lab11/triumvi/README.md

# G2
Energy harvesting true power meter

G2 aims to be the first energy harvesting, clamp on true power meter.
