lab11/triumvi/contiki/README.md

G2 - Contiki
==============

This folder contains code to make G2 a
[Contiki](https://github.com/contiki-os/contiki) platform.

Toolchain
------------

1. Install the compilers. See
[this](https://github.com/contiki-os/contiki/tree/master/platform/cc2538dk#install-a-toolchain)
for a link to the best compiler to use for the CC2538

Main Application
----------------

Currently, `triumvi_current` is the primary application. This application supports
versions 10, 11, 12, 12.1.
