lab11/triumvi/hardware/v9/mcu/Altium/layout/triumvi_v9_mcu.PcbDoc.htm

Reporting Options

# File in Previous Format

Date | : | 4/25/2016
Time | : | 2:15:08 PM
Filename | : | \\psf\Dropbox\Altium_YeSheng\Triumvi_v9_mcu\layout\triumvi_v9_mcu.PcbDoc

Version | Warning

This file was generated by an earlier version of the software
