lab11/triumvi/hardware/v9/sensing/Altium/layout/triumvi_v9_sensing.PcbDoc.htm

Reporting Options

# File in Previous Format

Date | : | 4/26/2016
Time | : | 10:14:43 AM
Filename | : | \\psf\Dropbox\Altium_YeSheng\Triumvi_v9_sensing\layout\triumvi_v9_sensing.PcbDoc

Version | Warning

This file was generated by an earlier version of the software
