lab11/triumvi/case/labels/bottom/BlockM-no-rball.png

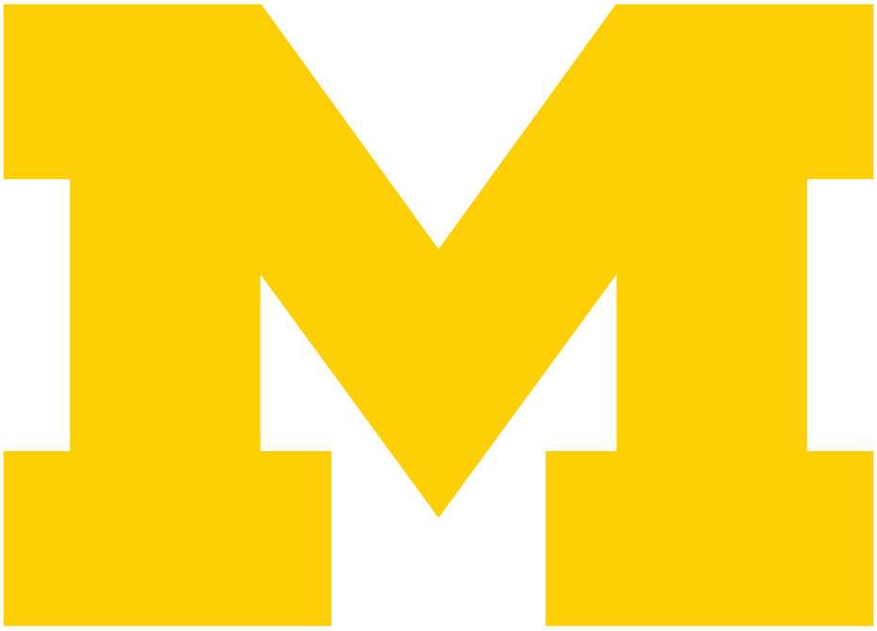
case/labels/bottom/BlockM-no-rball.png
