lab11/triumvi/hardware/charger/bom/Bill of Materials-triumvi_v10_phoneJeck_charging.xlsx

Designator | Value | Footprint | Quantity | Description | Supplier Part Number 1
C1_CHG1, C1_CHG2, C1_CHG3, C1_CHG4, C1_CHG5, C1_CHG6, C1_CHG7, C1_CHG8, C1_CHG9, C1_CHG10, C2_CHG1, C2_CHG2, C2_CHG3, C2_CHG4, C2_CHG5, C2_CHG6, C2_CHG7, C2_CHG8, C2_CHG9, C2_CHG10 | 4.7u | 0805 | 20 | Ceramic capacitor, 4.7 uF, 25 V, 0805 package | 490-3335-1-ND (https://octopart-clicks.com/click/altium?sku=490-3335-1-ND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)
C3 | 10u | 0603 - Polar Marking | 1 | Tantalum capacitor, 10 uF, 10 V, 0603 package | 511-1679-1-ND (https://octopart-clicks.com/click/altium?sku=511-1679-1-ND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)
C4 | 100u | 2917 | 1 | Tantalum capacitor, 100u, 2917 package | 399-3769-1-ND (https://octopart-clicks.com/click/altium?sku=399-3769-1-ND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)
C5 | 10u | 0603 | 1 | Ceramic capacitor, 10 uF, 16 V, 0603 package | 445-9065-1-ND (https://octopart-clicks.com/click/altium?manufacturer=TDK%20Corporation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)
C6 | 1u | 0603 | 1 | Ceramic capacitor, 1 uF, 16 V, 0603 package | 445-1604-1-ND (https://octopart-clicks.com/click/altium?manufacturer=TDK%20Corporation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)
D1_CHG1, D1_CHG2, D1_CHG3, D1_CHG4, D1_CHG5, D1_CHG6, D1_CHG7, D1_CHG8, D1_CHG9, D1_CHG10 |  | 0603 - LED | 10 | LED, Green, 0603 | 160-1446-1-ND (https://octopart-clicks.com/click/altium?sku=160-1446-1-ND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)
D2 |  | 0603 - LED | 1 | LED, Blue, 0603 | 475-2815-1-ND (https://octopart-clicks.com/click/altium?manufacturer=OSRAM%20Opto%20Semiconductors%20Inc.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)
FB1 |  | 0603 | 1 | Ferrite Bead, 2 A, 0603 package | 553-2387-1-ND (https://octopart-clicks.com/click/altium?manufacturer=Pulse%20Electronics%20Corporation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)
J1 |  | PJ-102AH | 1 | CONN PWR JACK 2.1X5.5MM HIGH CUR | CP-102AH-ND (https://octopart-clicks.com/click/altium?sku=CP-102AH-ND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)
P1_CHG1, P1_CHG2, P1_CHG3, P1_CHG4, P1_CHG5, P1_CHG6, P1_CHG7, P1_CHG8, P1_CHG9, P1_CHG10 |  | PJ3516S-041 | 10 | 3.5 mm phone jack, 4 terminals
R1_CHG1, R1_CHG2, R1_CHG3, R1_CHG4, R1_CHG5, R1_CHG6, R1_CHG7, R1_CHG8, R1_CHG9, R1_CHG10 | 10K | 0603 | 10 | Chip resistor, 10K, 0603 package | 541-10.0KHCT-ND (https://octopart-clicks.com/click/altium?sku=541-10.0KHCT-ND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)
R2_CHG1, R2_CHG2, R2_CHG3, R2_CHG4, R2_CHG5, R2_CHG6, R2_CHG7, R2_CHG8, R2_CHG9, R2_CHG10 | 47K | 0603 | 10 | Chip resistor, 47K, 0603 package | 541-47.0KHCT-ND (https://octopart-clicks.com/click/altium?sku=541-47.0KHCT-ND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)
R3_CHG1, R3_CHG2, R3_CHG3, R3_CHG4, R3_CHG5, R3_CHG6, R3_CHG7, R3_CHG8, R3_CHG9, R3_CHG10, R4 | 330 | 0603 | 11 | Chip resistor, 330, 0603 package | 541-330HCT-ND (https://octopart-clicks.com/click/altium?sku=541-330HCT-ND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)
U1_CHG1, U1_CHG2, U1_CHG3, U1_CHG4, U1_CHG5, U1_CHG6, U1_CHG7, U1_CHG8, U1_CHG9, U1_CHG10 |  | TSOT23-5 | 10 | Miniature Single-Cell, Fully Integrated Li-Ion, Li-Polymer Charge Management Controllers | MCP73831T-2ATI/OTCT-ND (https://octopart-clicks.com/click/altium?manufacturer=Microchip%20Technology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)
