lab11/triumvi/hardware/v12.1/config/bom/Bill of Materials-triumvi_integrated_v2_config.xlsx

Designator | Value | Footprint | Quantity | Description | Supplier Part Number 1
C1 | 0.1u | 0402 | 1 | 0.10µF ±10% 16V Ceramic Capacitor X7R 0402 | 490-3261-1-ND (https://octopart-clicks.com/click/altium?sku=490-3261-1-ND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)
D1 | RGB | PLCC6 | 1 | Red, Green, Blue (RGB) 622nm Red, 530nm Green, 470nm Blue LED Indication - Discrete 2.1V Red, 3V Green, 3V Blue 6-SMD, J-Lead | CLY6D-FKC-CK1N1D1BB7D3D3CT-ND (https://octopart-clicks.com/click/altium?manufacturer=Cree%20Inc.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)
J1 |  | DF40C-12DP-0.4V | 1 | Hirose BM20 Series, 0.4mm pitch, 12 pos, header | H124599CT-ND (https://octopart-clicks.com/click/altium?manufacturer=Hirose%20Electric%20Co%20Ltd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)
P1 |  | PJ3516S-041 | 1 | 3.5 mm phone jack, 4 terminals
P2, P3 |  | PJ2505S-041 | 2 | 2.5 mm phone jack, 4 terminals
R1, R7 | 100k | 0402 | 2 | RES SMD 100K OHM 1% 1/16W 0402 | 541-100KLCT-ND (https://octopart-clicks.com/click/altium?sku=541-100KLCT-ND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)
R2 | 110 | 0402 | 1 | RES SMD 110 OHM 1% 1/16W 0402 | 541-110LCT-ND (https://octopart-clicks.com/click/altium?sku=541-110LCT-ND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)
R3 | 220 | 0402 | 1 | RES SMD 220 OHM 1% 1/16W 0402 | 541-220LCT-ND (https://octopart-clicks.com/click/altium?sku=541-220LCT-ND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)
R4 | 324 | 0402 | 1 | RES SMD 324 OHM 1% 1/16W 0402 | 541-324LCT-ND (https://octopart-clicks.com/click/altium?sku=541-324LCT-ND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)
R5, R6 | 10k | 0402 | 2 | RES SMD 10K OHM 1% 1/16W 0402 | 541-10.0KLCT-ND (https://octopart-clicks.com/click/altium?sku=541-10.0KLCT-ND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)
SW1 |  | SH-7050A | 1 | ROTARY CODED SWITCHES | 563-1213-1-ND (https://octopart-clicks.com/click/altium?sku=563-1213-1-ND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)
SW2, SW3 |  | SH-7010A | 2 | ROTARY CODED SWITCHES | 563-1207-1-ND (https://octopart-clicks.com/click/altium?sku=563-1207-1-ND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)
U1 |  | QFN40P400X400X60_HS-29N | 1 | Voltage Level Shifting GPIO with LED Driver and Keypad Engine | SX1509BIULCT-ND (https://octopart-clicks.com/click/altium?manufacturer=Semtech%20Corporation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)
