lab11/triumvi/hardware/v12.1/sensing_mcu/bom/Bill of Materials-triumvi_integrated_v2_base.xlsx

Designator | Value | Footprint | Quantity | Description | Supplier Part Number 1
ANT1 |  | 2450AT45A100 | 1 | 2.45 GHz High Gain SMD Chip Antenna | 712-1012-1-ND (https://octopart-clicks.com/click/altium?manufacturer=Johanson%20Technology%20Inc.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)
B1 |  | 2450BM15A0002 | 1 | 2.45 GHz Balun for TI CC253X | 712-1536-1-ND (https://octopart-clicks.com/click/altium?manufacturer=Johanson%20Technology%20Inc.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)
C1, C2, C3, C14 | 1u | 0603 | 4 | 1µF ±10% 16V Ceramic Capacitor X7R 0603 | 445-1604-1-ND (https://octopart-clicks.com/click/altium?manufacturer=TDK%20Corporation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)
C4, C5, C15, C41, C42, C43, C44, C46, C47 | 4.7u | 0603 | 9 | 4.7µF ±10% 10V Ceramic Capacitor X5R 0603 | 445-7482-1-ND (https://octopart-clicks.com/click/altium?manufacturer=TDK%20Corporation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)
C6 | 0.068u | 0603 | 1 | 0.068µF ±10% 50V Ceramic Capacitor X7R 0603 | 399-7955-1-ND (https://octopart-clicks.com/click/altium?sku=399-7955-1-ND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)
C7 | 10000p | 0603 | 1 | 10000pF ±5% 50V Ceramic Capacitor X7R 0603 | 399-1092-6-ND (https://octopart-clicks.com/click/altium?sku=399-1092-6-ND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)
C8, C9, C10, C11, C12 | 220u | 2917 | 5 | 220µF ±10% Molded Tantalum Capacitors 16V | 399-10409-1-ND (https://octopart-clicks.com/click/altium?sku=399-10409-1-ND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)
C13 | 100u | 1206 - POLAR MARKING | 1 | 100µF ±20% Molded Tantalum Capacitors 6.3V 1206 | 478-8155-1-ND (https://octopart-clicks.com/click/altium?sku=478-8155-1-ND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)
C16, C17, C19, C21, C23, C24, C27, C28, C29, C30, C31, C32, C33, C35, C38, C39 | 0.1u | 0402 | 16 | 0.10µF ±10% 16V Ceramic Capacitor X7R 0402 | 490-3261-1-ND (https://octopart-clicks.com/click/altium?sku=490-3261-1-ND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)
C18 | 80m | XH414HG-IV01E | 1 | 80mF (EDLC) Supercapacitor 3.3V Coin | 728-1050-1-ND (https://octopart-clicks.com/click/altium?sku=728-1050-1-ND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)
C20, C25, C26, C45 | 10u | 0603 | 4 | 10µF ±20% 6.3V Ceramic Capacitor X5R 0603 | 445-4112-1-ND (https://octopart-clicks.com/click/altium?manufacturer=TDK%20Corporation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)
C22 | 18p | 0402 | 1 | 18pF ±2% 50V Ceramic Capacitor C0G, NP0 0402 | 712-1264-1-ND (https://octopart-clicks.com/click/altium?manufacturer=Johanson%20Technology%20Inc.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)
C34 | 220p | 0402 | 1 | 220pF ±10% 50V Ceramic Capacitor X7R 0402 | 399-1030-1-ND (https://octopart-clicks.com/click/altium?sku=399-1030-1-ND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)
C36, C37 | 12p | 0402 | 2 | 12pF ±2% 50V Ceramic Capacitor C0G, NP0 0402 | 712-1256-1-ND (https://octopart-clicks.com/click/altium?manufacturer=Johanson%20Technology%20Inc.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)
C40 | 1000p | 0402 | 1 | 1000pF ±5% 50V Ceramic Capacitor C0G, NP0 0402 | 445-6846-1-ND (https://octopart-clicks.com/click/altium?manufacturer=TDK%20Corporation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)
D1, D3 |  | PowerDI123 | 2 | 1.0A SURFACE MOUNT SCHOTTKY BARRIER RECTIFIER | DFLS130LDICT-ND (https://octopart-clicks.com/click/altium?sku=DFLS130LDICT-ND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)
D2 | Green | 0402 - LED | 1 | Green 571nm LED Indication - Discrete 2V 0402 (1005 Metric) | 754-1811-1-ND (https://octopart-clicks.com/click/altium?sku=754-1811-1-ND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)
D4, D5, D6, D7 |  | SOT23-3 | 4 | SURFACE MOUNT SCHOTTKY BARRIER DIODE | BAS40-04FDICT-ND (https://octopart-clicks.com/click/altium?manufacturer=Diodes%20Incorporated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)
D8 |  | SOT-363 | 1 | SURFACE MOUNT SCHOTTKY BARRIER DIODE ARRAYS | BAS40TW-FDICT-ND (https://octopart-clicks.com/click/altium?sku=BAS40TW-FDICT-ND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)
D9 |  | 0503/SOD-723F | 1 | Zener Diode 3.6V 150mW ±5% Surface Mount 0503 (1308 Metric) | 641-1232-1-ND (https://octopart-clicks.com/click/altium?sku=641-1232-1-ND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)
D10 | Red | 0402 - LED | 1 | Red 620nm LED Indication - Discrete 2V 2-SMD | 511-1593-1-ND (https://octopart-clicks.com/click/altium?sku=511-1593-1-ND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)
D11 |  | 0402 - DIODE | 1 | Diode Schottky 30V 100mA Surface Mount 0402/SOD-923F | 641-1271-1-ND (https://octopart-clicks.com/click/altium?sku=641-1271-1-ND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)
D12 |  | SOT323 | 1 | Diode Array 1 Pair Common Cathode Standard 75V 150mA Surface Mount SC-70, SOT-323 | BAV70W-FDICT-ND (https://octopart-clicks.com/click/altium?sku=BAV70W-FDICT-ND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)
J1 |  | DF40B(2.0)-12DS-0.4V | 1 | Hirose BM20 Series, 0.4mm pitch, 2mm stack height, 12 pos, header | H124594CT-ND (https://octopart-clicks.com/click/altium?manufacturer=Hirose%20Electric%20Co%20Ltd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)
J2, J3 |  | 9774020243R | 2 | 2 mm stack height, m2 standoff | 732-7073-1-ND (https://octopart-clicks.com/click/altium?manufacturer=Wurth%20Electronics%20Inc.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)
L1 | 10u | CDRH2D18 | 1 | 10µH Shielded Inductor 1A 180 mOhm Max Nonstandard | 308-1959-1-ND (https://octopart-clicks.com/click/altium?manufacturer=Sumida%20America%20Components%20Inc.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)
P1, P2 |  | TC2030-IDC-NLFP | 2 | TC2030-MCP-NL
Q1 |  | SOT23-3 | 1 | P-Channel 30-V (D-S) MOSFET | SI2369DS-T1-GE3CT-ND (https://octopart-clicks.com/click/altium?manufacturer=Vishay%20Siliconix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)
Q2, Q4 |  | SOT23-3 | 2 | P-Channel 20 V (D-S) MOSFET | SI2367DS-T1-GE3CT-ND (https://octopart-clicks.com/click/altium?manufacturer=Vishay%20Siliconix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)
Q3, Q5 |  | SOT23-3 | 2 | N-Channel 8 V (D-S) MOSFET | SI2342DS-T1-GE3CT-ND (https://octopart-clicks.com/click/altium?manufacturer=Vishay%20Siliconix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)
Q6, Q7, Q8, Q9 |  | SOT23-3 | 4 | N-Channel 30 V (D-S) MOSFET | SI2338DS-T1-GE3CT-ND (https://octopart-clicks.com/click/altium?manufacturer=Vishay%20Siliconix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)
Q10, Q11 |  | SC70-6 | 2 | DUAL N-CHANNEL ENHANCEMENT MODE MOSFET | DMN2004DWKDICT-ND (https://octopart-clicks.com/click/altium?manufacturer=Diodes%20Incorporated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)
Q12 |  | SC70-6 | 1 | Dual P-Channel 12 V (D-S) MOSFET | SI1965DH-T1-GE3CT-ND (https://octopart-clicks.com/click/altium?manufacturer=Vishay%20Siliconix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)
Q13, Q14, Q15 |  | SC70-6 | 3 | Load Switch with Level-Shift | SI1865DDL-T1-GE3CT-ND (https://octopart-clicks.com/click/altium?manufacturer=Vishay%20Siliconix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)
R1 | 910 | 0402 | 1 | RES SMD 910 OHM 1% 1/16W 0402 | 541-910LCT-ND (https://octopart-clicks.com/click/altium?sku=541-910LCT-ND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)
R2, R3, R5, R6, R26, R28 | 47k | 0402 | 6 | RES SMD 47K OHM 1% 1/16W 0402 | 541-47.0KLCT-ND (https://octopart-clicks.com/click/altium?sku=541-47.0KLCT-ND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)
R4, R7, R8, R22, R24, R29, R30, R32, R33, R37, R38, R39, R40, R41, R42 | 1Meg | 0402 | 15 | RES SMD 1M OHM 1% 1/16W 0402 | 541-1.00MLCT-ND (https://octopart-clicks.com/click/altium?sku=541-1.00MLCT-ND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)
R9 | 20 | 0805 | 1 | RES SMD 20 OHM 0.1% 1/5W 0805 | RTAN0805BKE20R0CT-ND (https://octopart-clicks.com/click/altium?manufacturer=Stackpole%20Electronics%20Inc.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)
R10, R11 | 10k | 0402 | 2 | RES SMD 10K OHM 1% 1/16W 0402 | 541-10.0KLCT-ND (https://octopart-clicks.com/click/altium?sku=541-10.0KLCT-ND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)
R12 | 4.32k | 0402 | 1 | RES SMD 4.32K OHM 1% 1/16W 0402 | 541-4.32KLCT-ND (https://octopart-clicks.com/click/altium?sku=541-4.32KLCT-ND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)
R13 | 45.3k | 0402 | 1 | RES SMD 45.3KOHM 0.5% 1/16W 0402 | YAG4430CT-ND (https://octopart-clicks.com/click/altium?sku=YAG4430CT-ND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)
R14 | 620 | 0402 | 1 | RES SMD 620 OHM 1% 1/16W 0402 | 541-620LCT-ND (https://octopart-clicks.com/click/altium?sku=541-620LCT-ND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)
R15 | 24k | 0402 | 1 | RES SMD 24K OHM 0.5% 1/16W 0402 | 311-2260-1-ND (https://octopart-clicks.com/click/altium?sku=311-2260-1-ND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)
R16 | 20 | 0402 | 1 | RES SMD 20 OHM 1% 1/16W 0402 | 541-20.0LCT-ND (https://octopart-clicks.com/click/altium?sku=541-20.0LCT-ND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)
R17 | 12.1k | 0402 | 1 | RES SMD 12.1K OHM 1% 1/16W 0402 | 541-12.1KLCT-ND (https://octopart-clicks.com/click/altium?sku=541-12.1KLCT-ND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)
R18 | 110 | 0402 | 1 | RES SMD 110 OHM 1% 1/16W 0402 | 541-110LCT-ND (https://octopart-clicks.com/click/altium?sku=541-110LCT-ND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)
R19 | 5.76k | 0402 | 1 | RES SMD 5.76K OHM 0.5% 1/16W 0402 | YAG3196CT-ND (https://octopart-clicks.com/click/altium?sku=YAG3196CT-ND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)
R20, R23, R25 | 100k | 0402 | 3 | RES SMD 100K OHM 1% 1/16W 0402 | 541-100KLCT-ND (https://octopart-clicks.com/click/altium?sku=541-100KLCT-ND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)
R21 | 2Meg | 0402 | 1 | RES SMD 2M OHM 1% 1/16W 0402 | 541-2.00MLCT-ND (https://octopart-clicks.com/click/altium?sku=541-2.00MLCT-ND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)
R27 | 100 | 0402 | 1 | RES SMD 100 OHM 1% 1/16W 0402 | 541-100LCT-ND (https://octopart-clicks.com/click/altium?sku=541-100LCT-ND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)
R31, R34 | 2.2k | 0402 | 2 | RES SMD 2.2K OHM 1% 1/16W 0402 | 541-2.20KLCT-ND (https://octopart-clicks.com/click/altium?sku=541-2.20KLCT-ND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)
R35 | 56k | 0402 | 1 | RES SMD 56K OHM 1% 1/16W 0402 | 541-56.0KLCT-ND (https://octopart-clicks.com/click/altium?sku=541-56.0KLCT-ND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)
R36 | 470k | 0402 | 1 | RES SMD 470K OHM 5% 1/16W 0402 | 541-470KJCT-ND (https://octopart-clicks.com/click/altium?sku=541-470KJCT-ND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)
SW1 |  | EVQP7C | 1 | 3.5 mm×2.9 mm Side-operational SMD Light Touch Switches | P16769CT-ND (https://octopart-clicks.com/click/altium?manufacturer=Panasonic%20Electronic%20Components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)
U1 |  | SOT23-6 | 1 | Low Noise, Regulated Charge Pump DC/DC Converters | LTC3200ES6-5#TRMPBFCT-ND (https://octopart-clicks.com/click/altium?manufacturer=Linear%20Technology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)
U2 |  | TSOT23-5 | 1 | Miniature Single-Cell, Fully Integrated Li-Ion, Li-Polymer Charge Management Controllers | MCP73831T-2ATI/OTCT-ND (https://octopart-clicks.com/click/altium?manufacturer=Microchip%20Technology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)
U3 |  | QFN-10 | 1 | Piezoelectric Energy Harvesting Power Supply | LTC3588EDD-1#PBF-ND (https://octopart-clicks.com/click/altium?manufacturer=Linear%20Technology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)
U4 |  | TDFN-8 | 1 | 256-Kbit (32 K × 8) Serial (SPI) F-RAM | FM25V02A-DGTR-ND (https://octopart-clicks.com/click/altium?manufacturer=Cypress%20Semiconductor%20Corp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)
U5 |  | TSSOP-14 | 1 | 1 pC Charge Injection, 100 pA Leakage CMOS 5 V/5 V/3 V 4-Channel Multiplexer | ADG604YRUZ-ND (https://octopart-clicks.com/click/altium?sku=ADG604YRUZ-ND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)
U6 |  | MSOP-8 | 1 | Micro-Power (50uA), Zero-Drift, Rail-to-Rail Out Instrumentation Amplifier | 296-23564-1-ND (https://octopart-clicks.com/click/altium?sku=296-23564-1-ND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)
U7 |  | MSOP-8 | 1 | 0.9 µA, High Precision Op Amps | MCP6032-E/MS-ND (https://octopart-clicks.com/click/altium?manufacturer=Microchip%20Technology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)
U8 |  | SC70-5 | 1 | Rail-to-rail 0.9 V nanopower comparator | 497-13217-1-ND (https://octopart-clicks.com/click/altium?sku=497-13217-1-ND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)
U9 |  | QFN56 | 1 | A Powerful System-On-Chip for 2.4-GHz IEEE 802.15.4, 6LoWPAN and ZigBee Applications | 296-35797-1-ND (https://octopart-clicks.com/click/altium?sku=296-35797-1-ND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)
U10, U12 |  | CP-6-3 | 2 | Ultralow Noise, 200 mA, CMOS Linear Regulator | ADP151ACPZ-3.0-R7CT-ND (https://octopart-clicks.com/click/altium?manufacturer=Analog%20Devices%20Inc.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)
U11 |  | TSOT-23 | 1 | Low Loss PowerPath Controller in ThinSOT | LTC4412ES6#TRMPBFCT-ND (https://octopart-clicks.com/click/altium?manufacturer=Linear%20Technology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)
Y1 |  | RV-3049-C3 | 1 | Real Time Clock Module with SPI-Bus
Y2 |  | FA-128 | 1 | MHz Range Crystal Unit | SER3800CT-ND (https://octopart-clicks.com/click/altium?sku=SER3800CT-ND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)
