lab11/triumvi/case/triumvi_v10.1_charge_holder.SLDASM

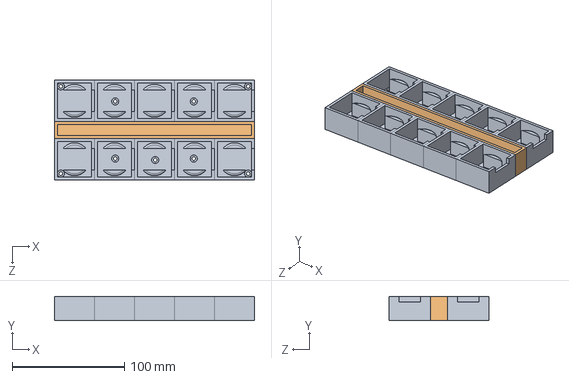
[picture p2: CAD file, 2017-02-23]
case/triumvi_v10.1_charge_holder.SLDASM
177.8 x 21.3 x 88.9 mm
triumvi_v10_charge_holder_pod x 10
triumvi_v10_charge_holder_middle
