lab11/triumvi/case/triumvi_v10_charge_holder_middle.SLDPRT

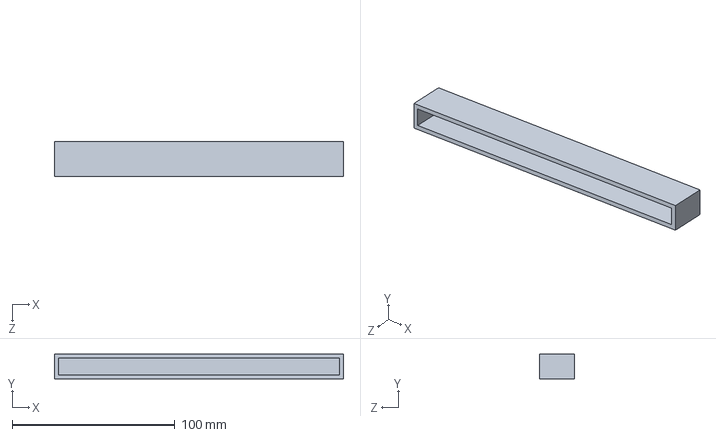
[picture p3: CAD file, 2017-02-23]
case/triumvi_v10_charge_holder_middle.SLDPRT
177.8 x 15.2 x 21.3 mm
