lab11/triumvi/case/triumvi_v10_cap.SLDPRT

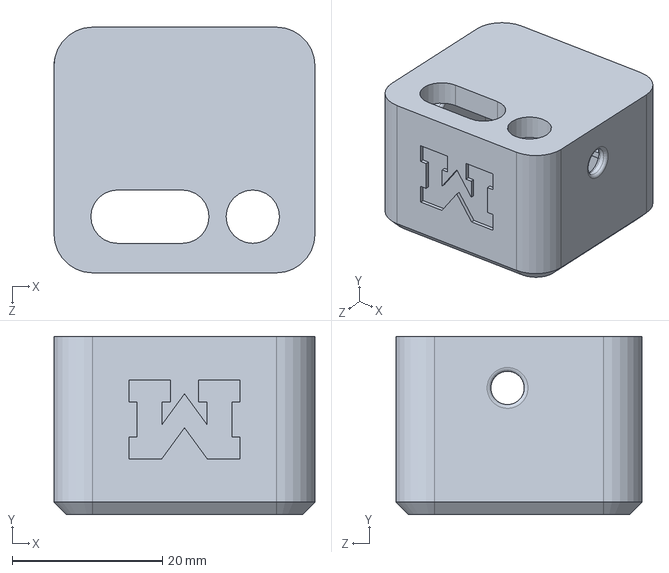
[picture p4: CAD file, 2017-02-23]
case/triumvi_v10_cap.SLDPRT
34.8 x 23.7 x 32.8 mm
