lab11/triumvi/case/triumvi_v10_charge_holder_pod.SLDPRT

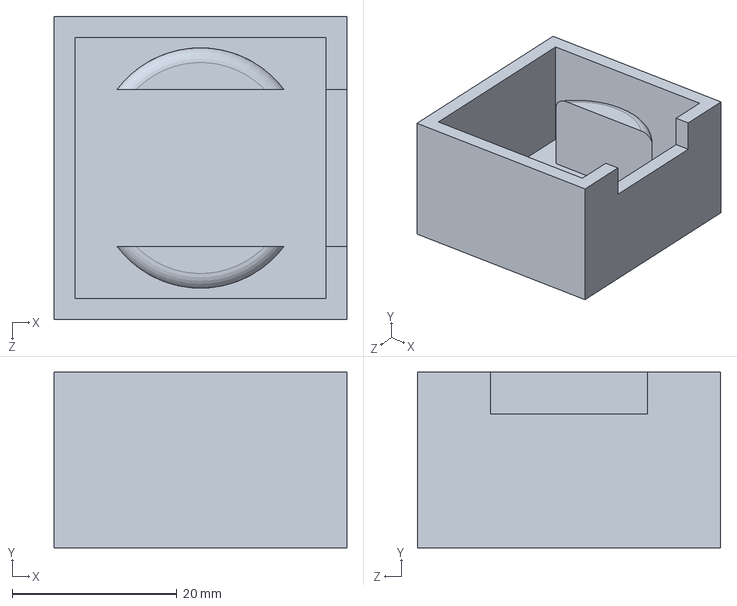
[picture p5: CAD file, 2017-02-23]
case/triumvi_v10_charge_holder_pod.SLDPRT
35.6 x 21.3 x 36.8 mm
