lab11/triumvi/case/triumvi_white_charge_holder.SLDPRT

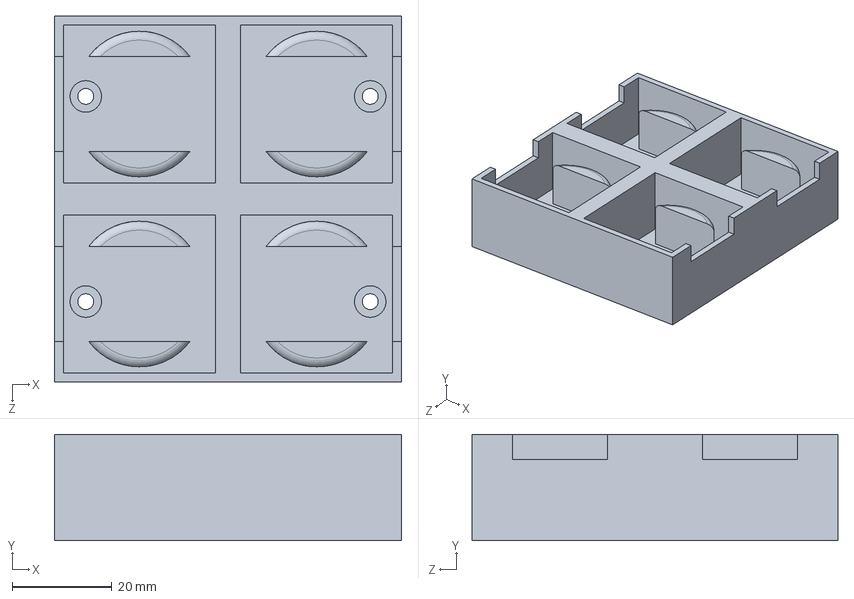
[picture p6: CAD file, 2016-12-15]
case/triumvi_white_charge_holder.SLDPRT
69.6 x 21.3 x 73.4 mm
