lab11/triumvi/case/bottom_cap_case.SLDPRT

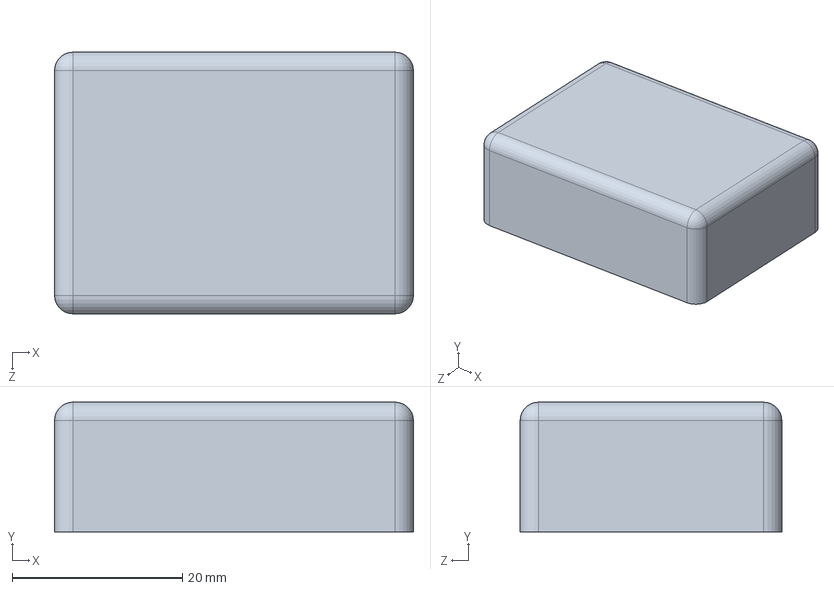
[picture p7: CAD file, 2016-12-15]
case/bottom_cap_case.SLDPRT
42.2 x 15.2 x 30.7 mm
