lab11/triumvi/case/triumvi_white_charge_holder_test.SLDPRT

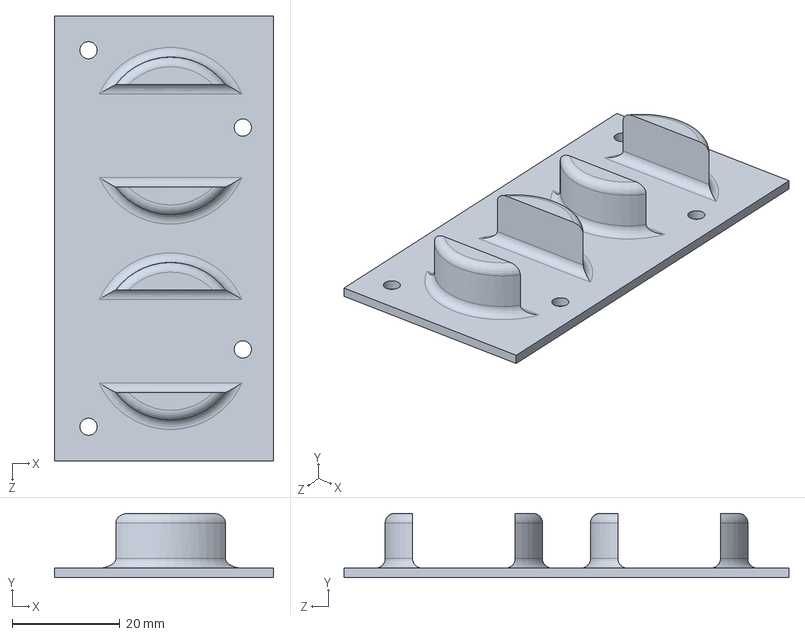
[picture p8: CAD file, 2016-12-15]
case/triumvi_white_charge_holder_test.SLDPRT
40.7 x 11.9 x 82.6 mm
