lab11/triumvi/case/triumvi_v10_charge_holder.SLDASM

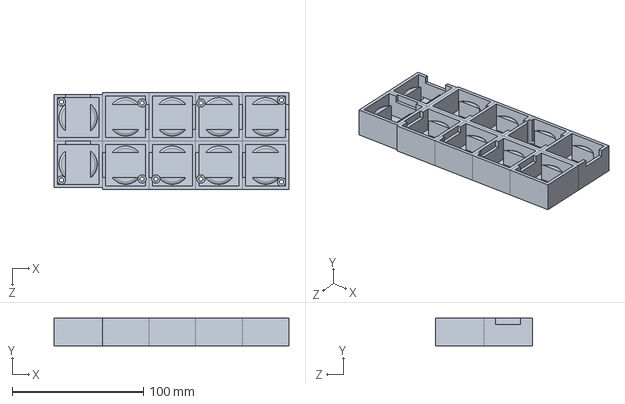
[picture p9: CAD file, 2016-12-15, an earlier design]
case/triumvi_v10_charge_holder.SLDASM
179.1 x 21.3 x 73.7 mm
triumvi_v10_charge_holder_pod x 10
