lab11/triumvi/case/triumvi_v9_cap.SLDPRT

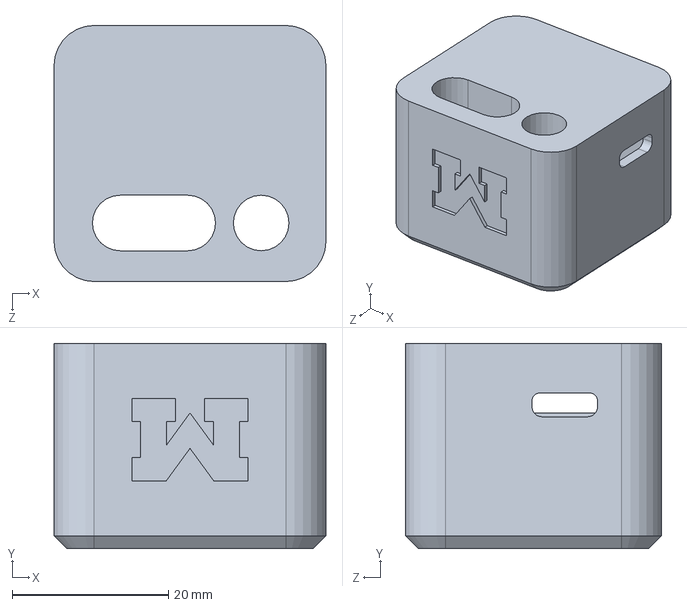
[picture p10: CAD file, 2016-12-15, an earlier design]
case/triumvi_v9_cap.SLDPRT
34.8 x 26.3 x 32.8 mm
