lab11/triumvi/hardware/v12.1/sensing_mcu/schematic/schematic.PDF

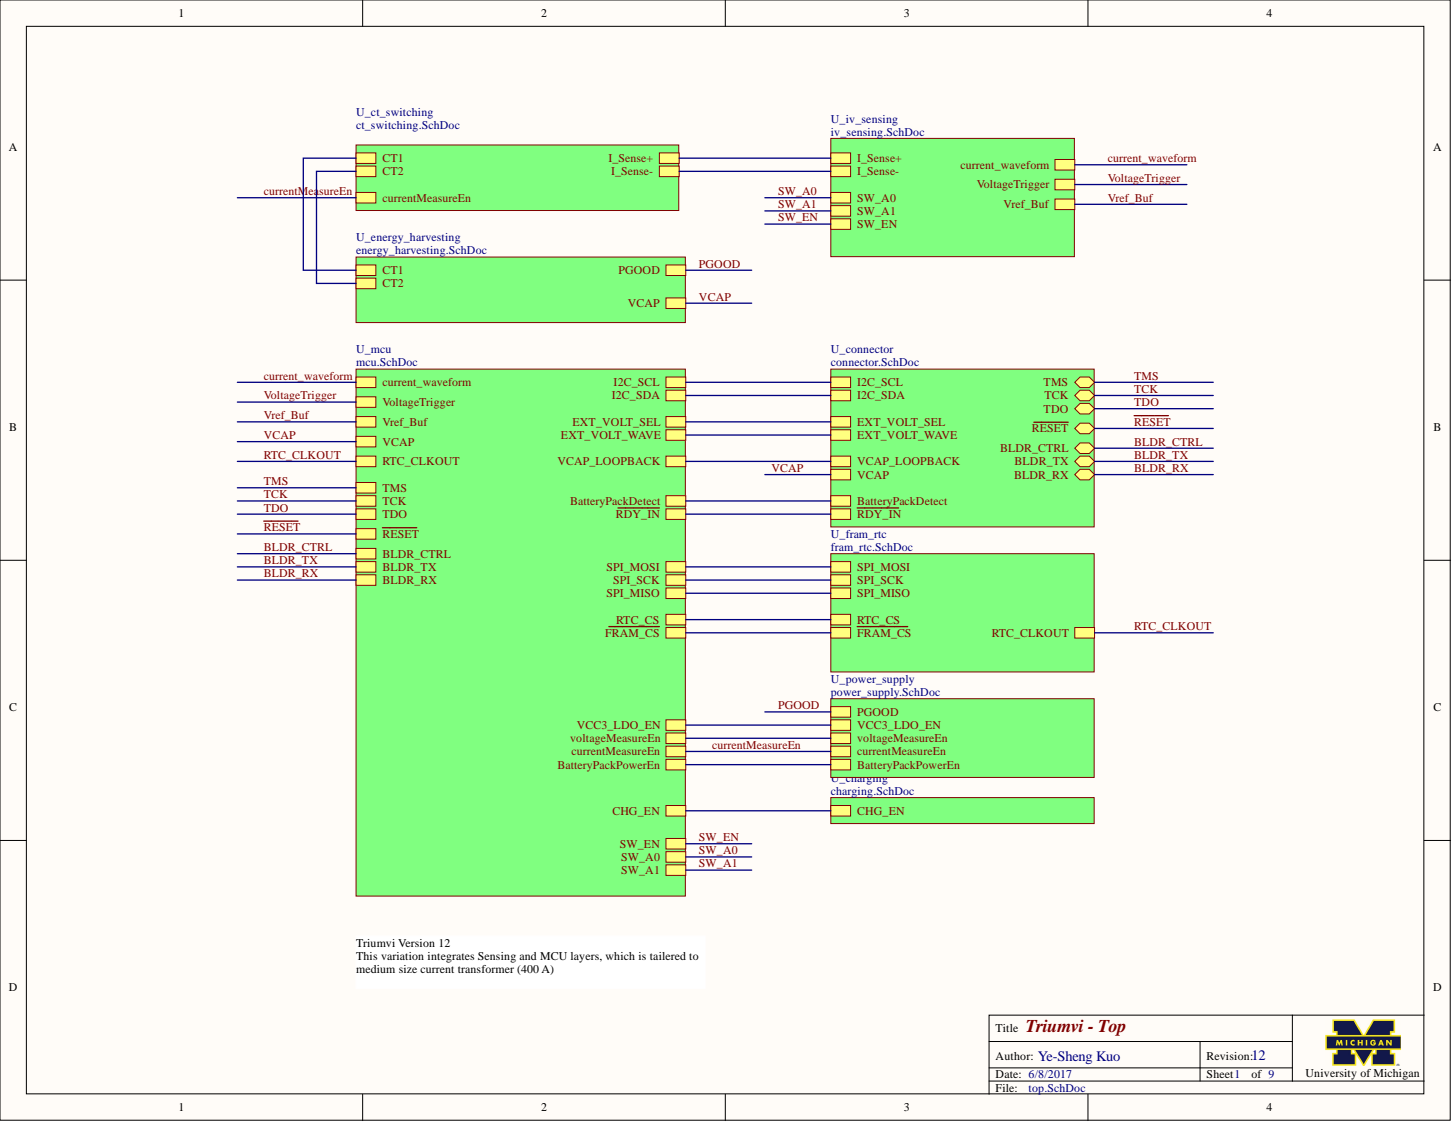
[picture p12: page 1]

Triumvi Version 12
This variation integrates Sensing and MCU layers, which is tailered to
medium size current transformer (400 A)

Triumvi - Top Title | University of Michigan

Author: Ye-Sheng Kuo | Revision:
Date: | Sheet of

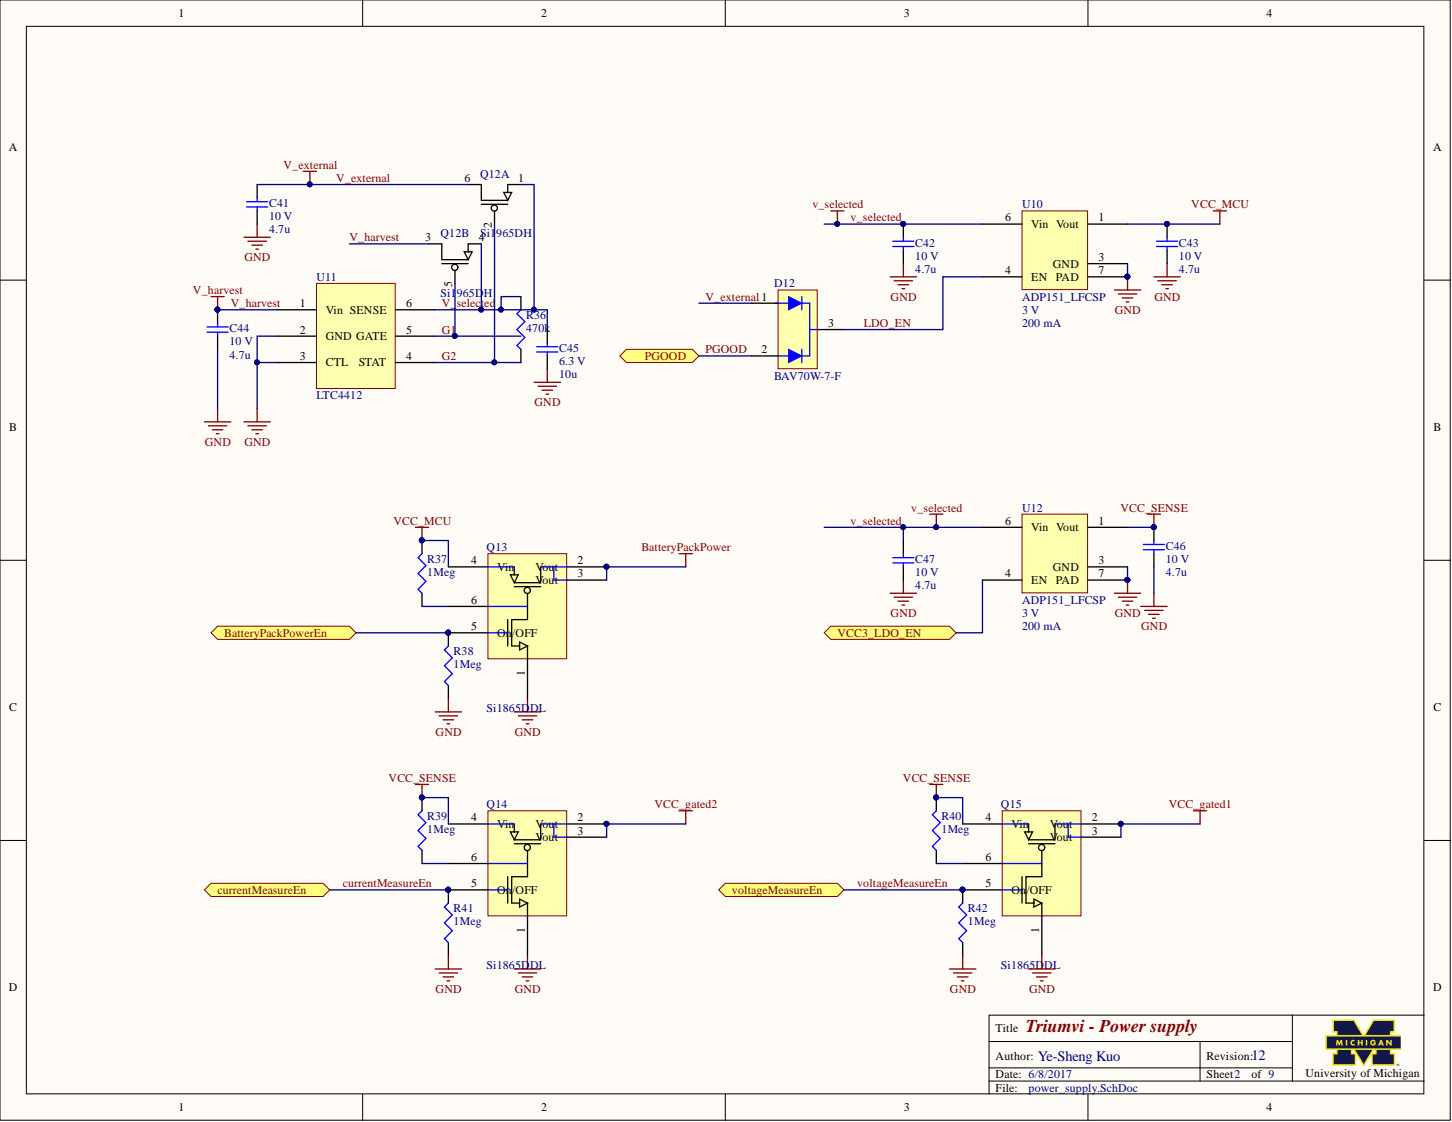
[picture p13: page 2]

Vin 4

On/OFF 5

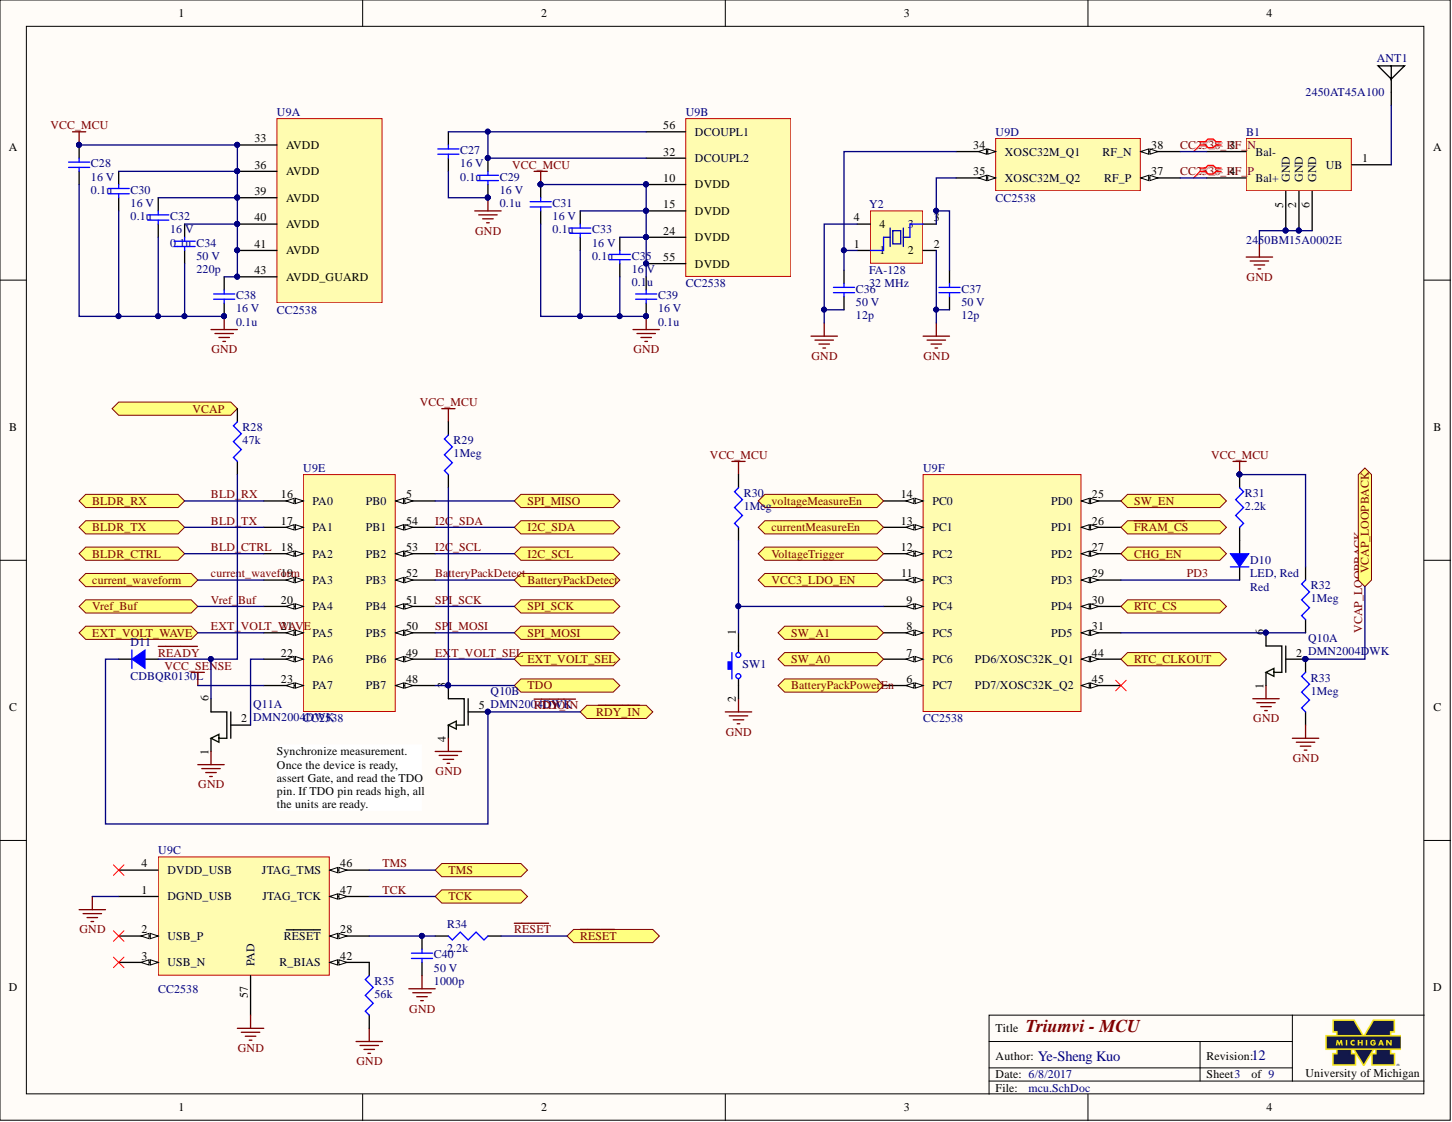
[picture p14: page 3]

AVDD 36

AVDD 40

Synchronize measurement.
Once the device is ready,
assert Gate, and read the TDO
pin. If TDO pin reads high, all
the units are ready.

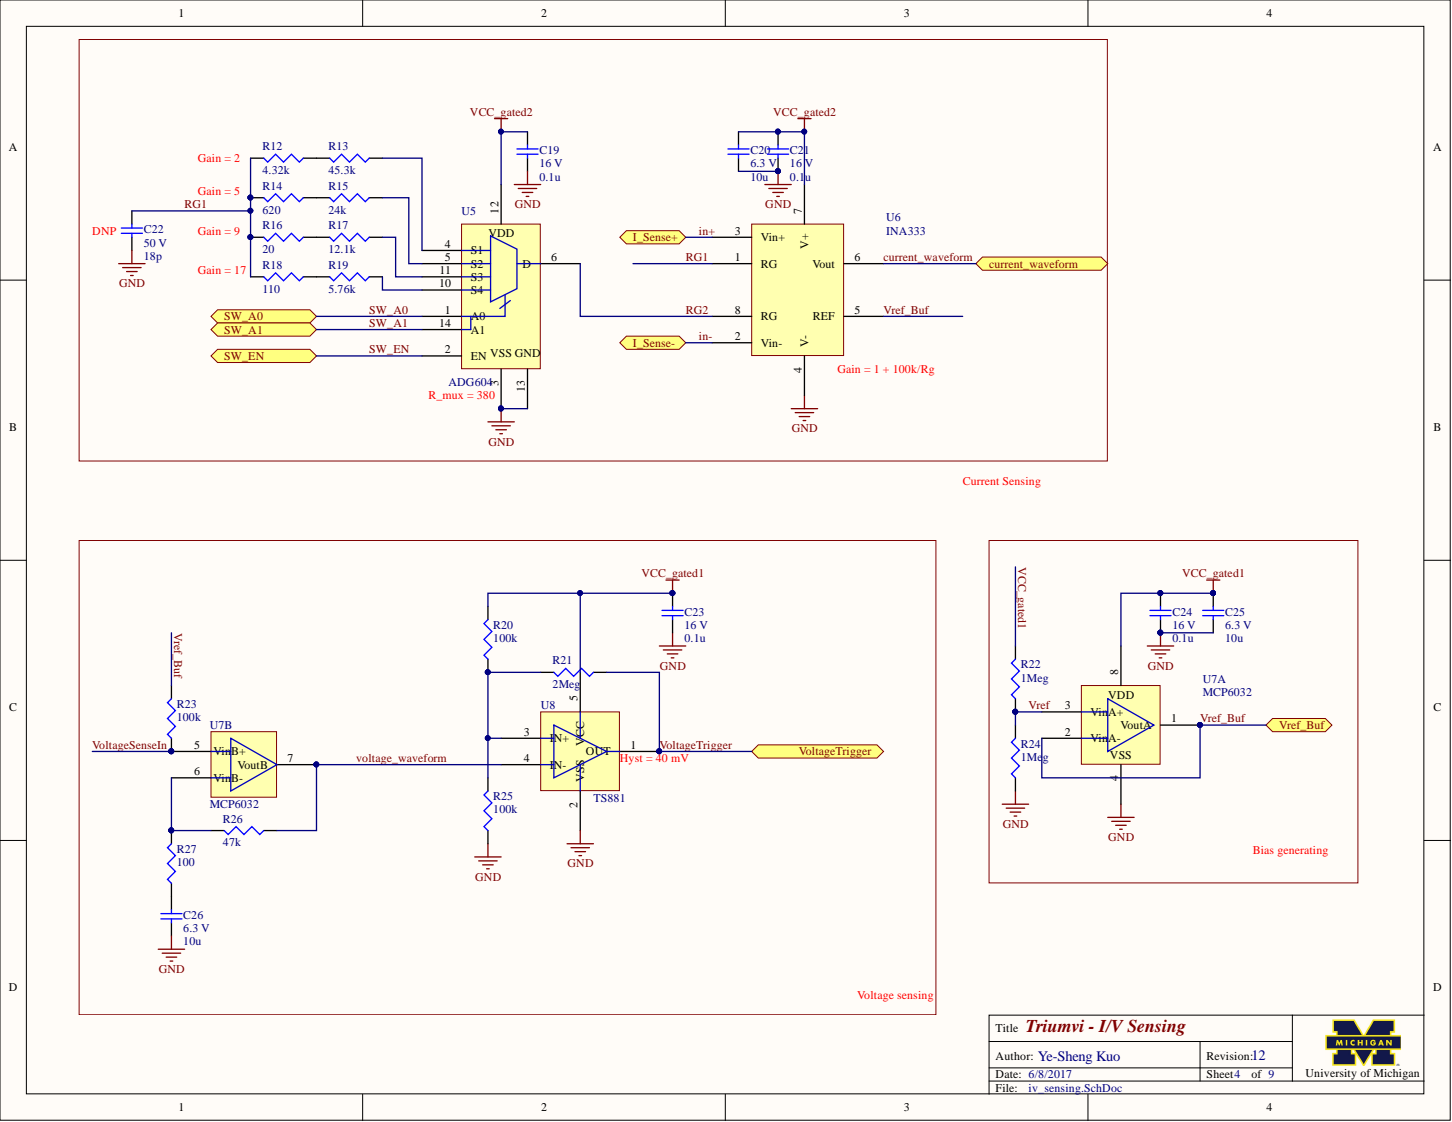
[picture p15: page 4]

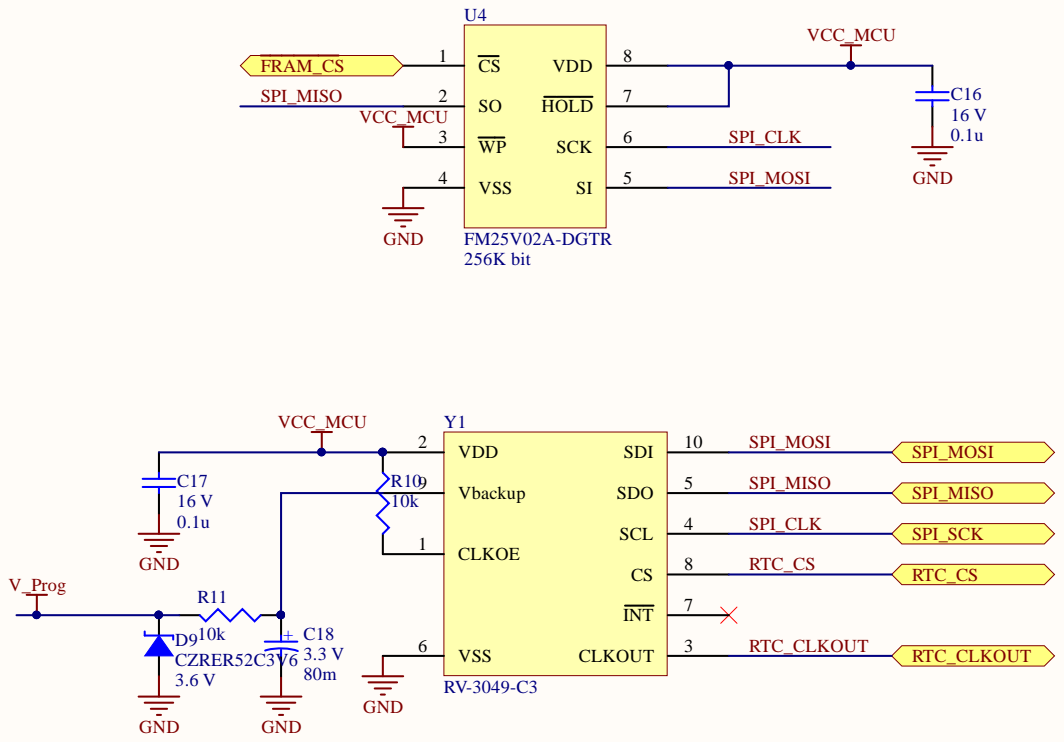
[picture p16: page 5]

Vbackup 9
10k | CLKOE 1

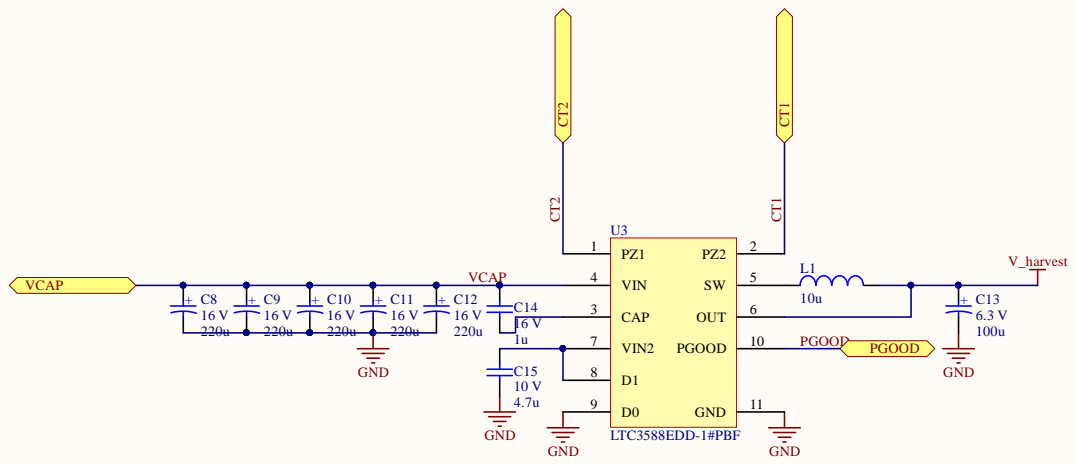
[picture p17: page 6]

16 V | VIN2 7

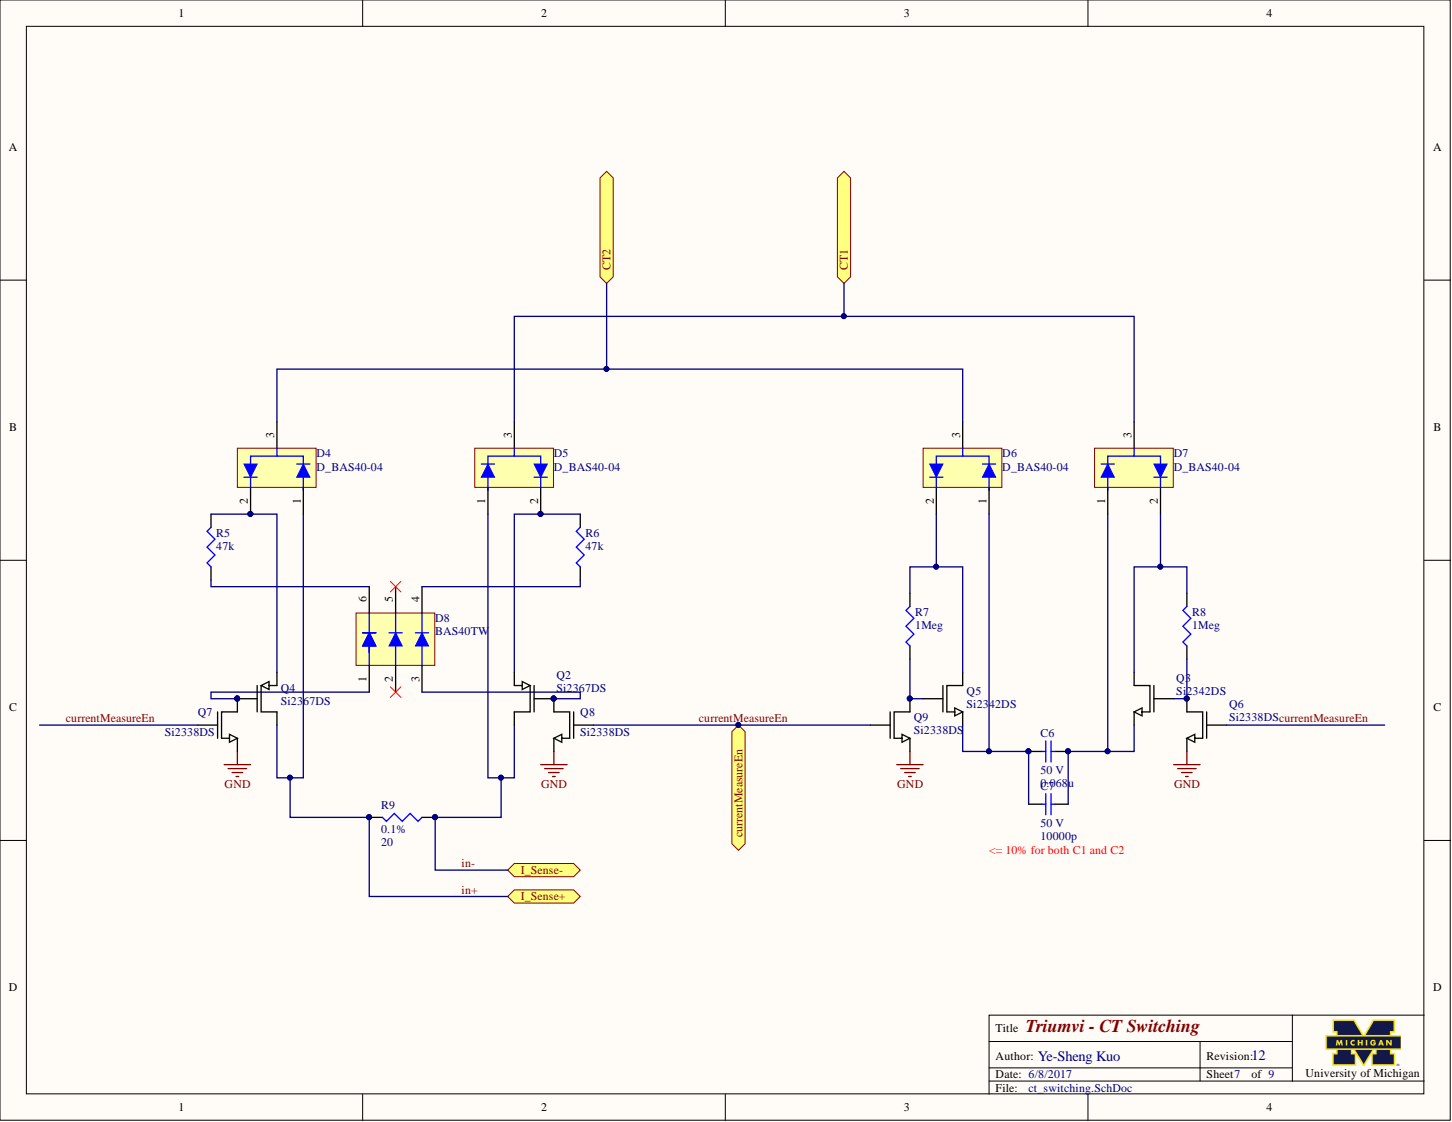
[picture p18: page 7]

Q4
Si2367DS

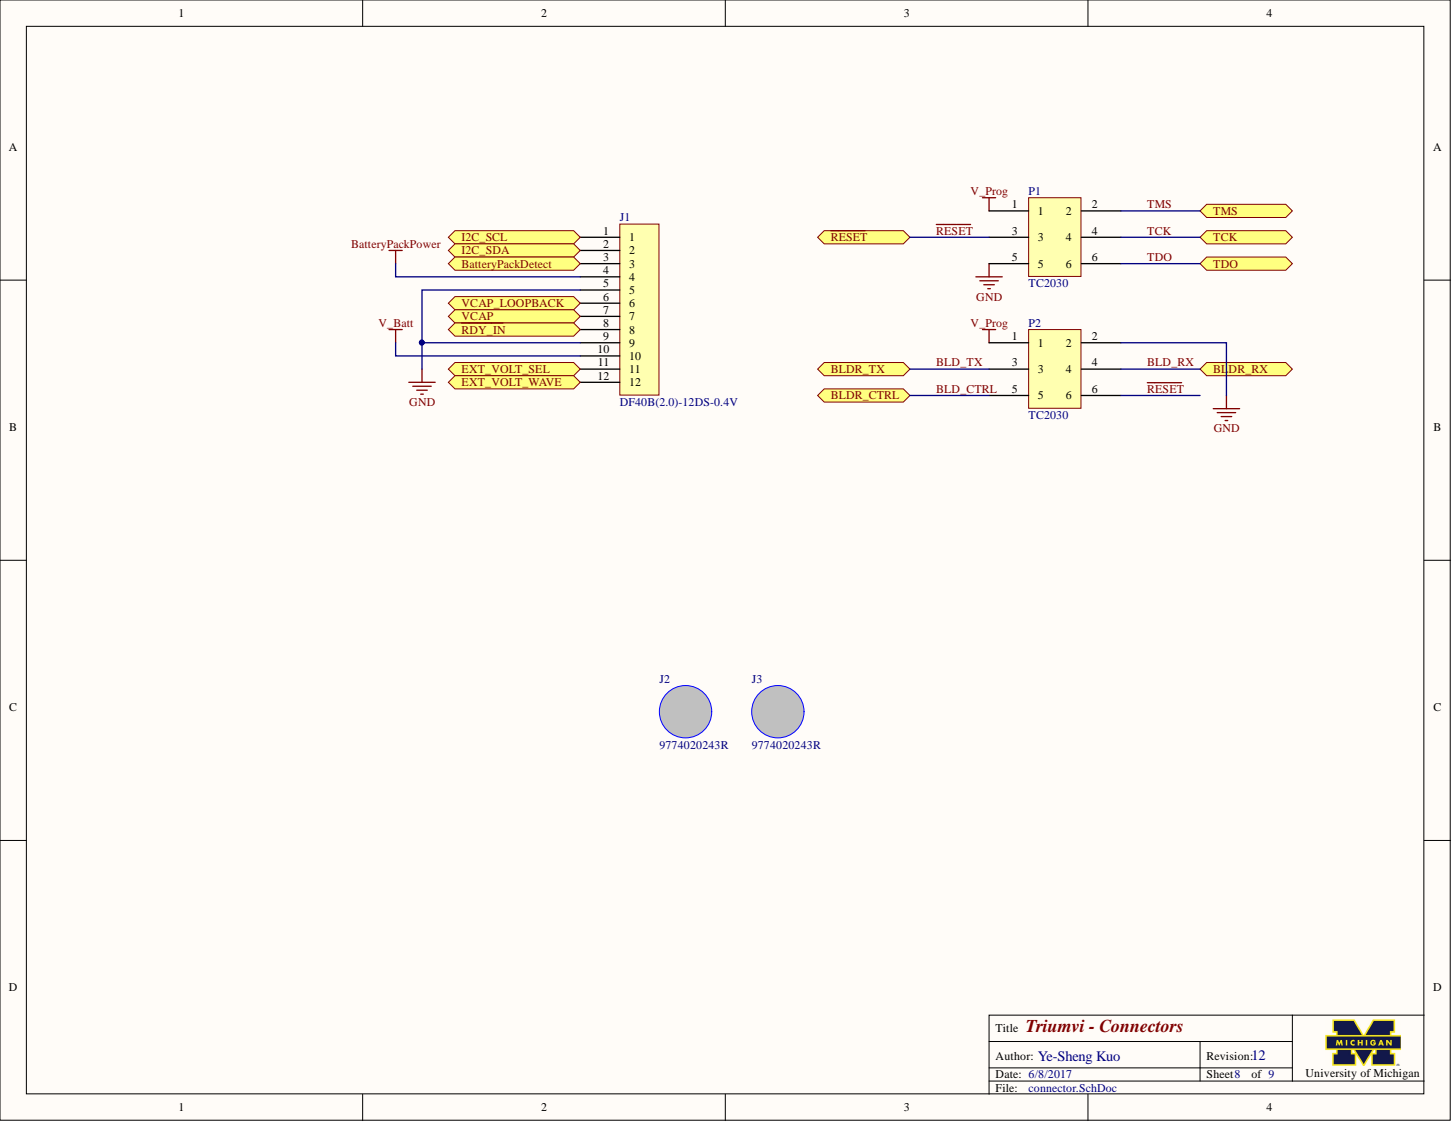
[picture p19: page 8]

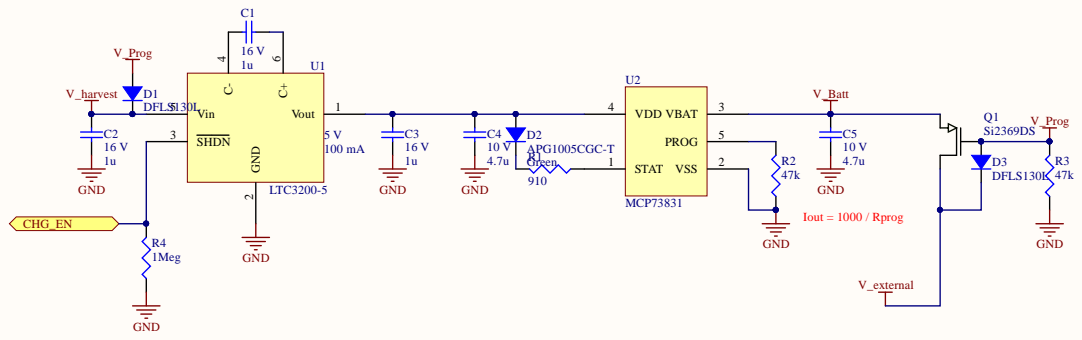
[picture p20: page 9]

Triumvi - Charging T i t l e | U n i vers i t y of Mich i gan

A u t h or: Ye-S h e n g Ku o | Rev i s i o n :

/ / | Sheet o f
