lab11/triumvi/hardware/charger/schematic/schematic.PDF

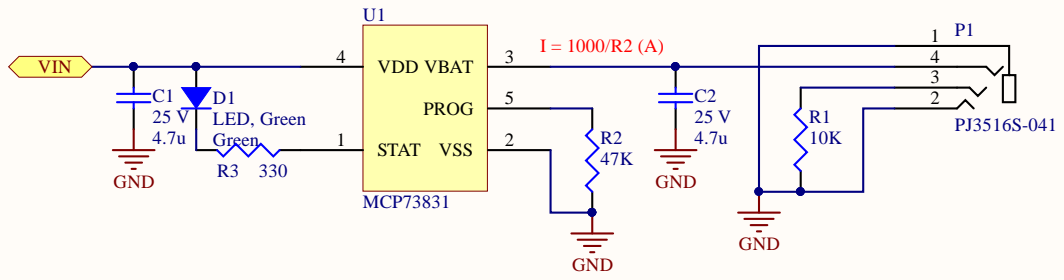
[picture p21: page 1]

T i t l e | U n i vers i t y of Mich i gan

A u t h or: Ye-S h e n g Ku o | Rev i s i o n :
Date: / / | Sheet o f

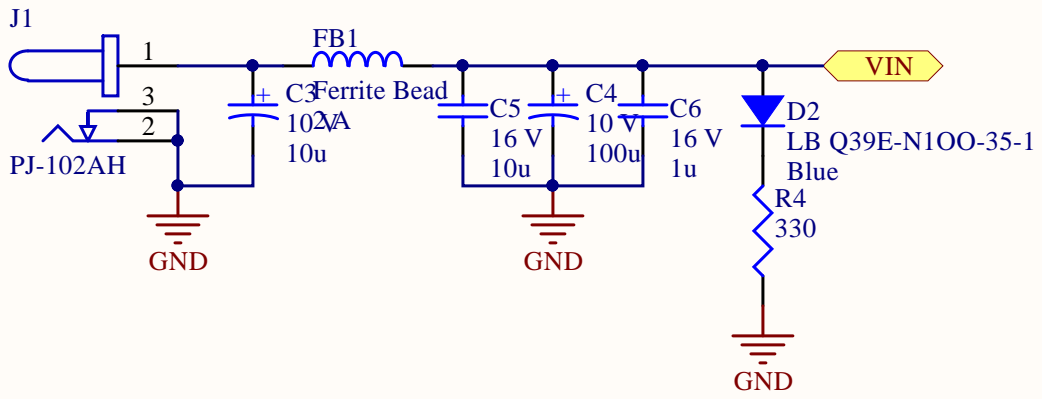
[picture p22: page 2]

T i t l e | U n i vers i t y of Mich i gan

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

/ / | Sheet o f

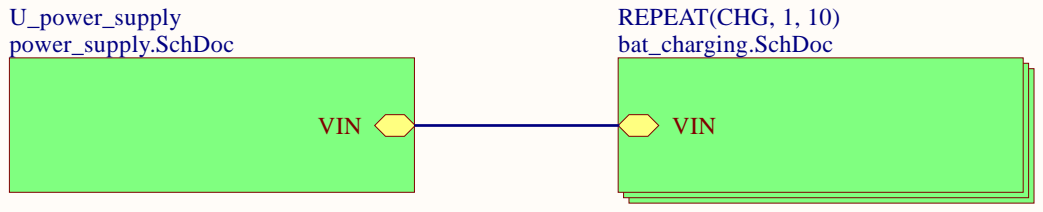
[picture p23: page 3]

Title | University of Michigan

Author: Ye-Sheng Kuo | Revision:
6/9/2017 | Sheet of
