lab11/triumvi/case/triumvi (1).pdf

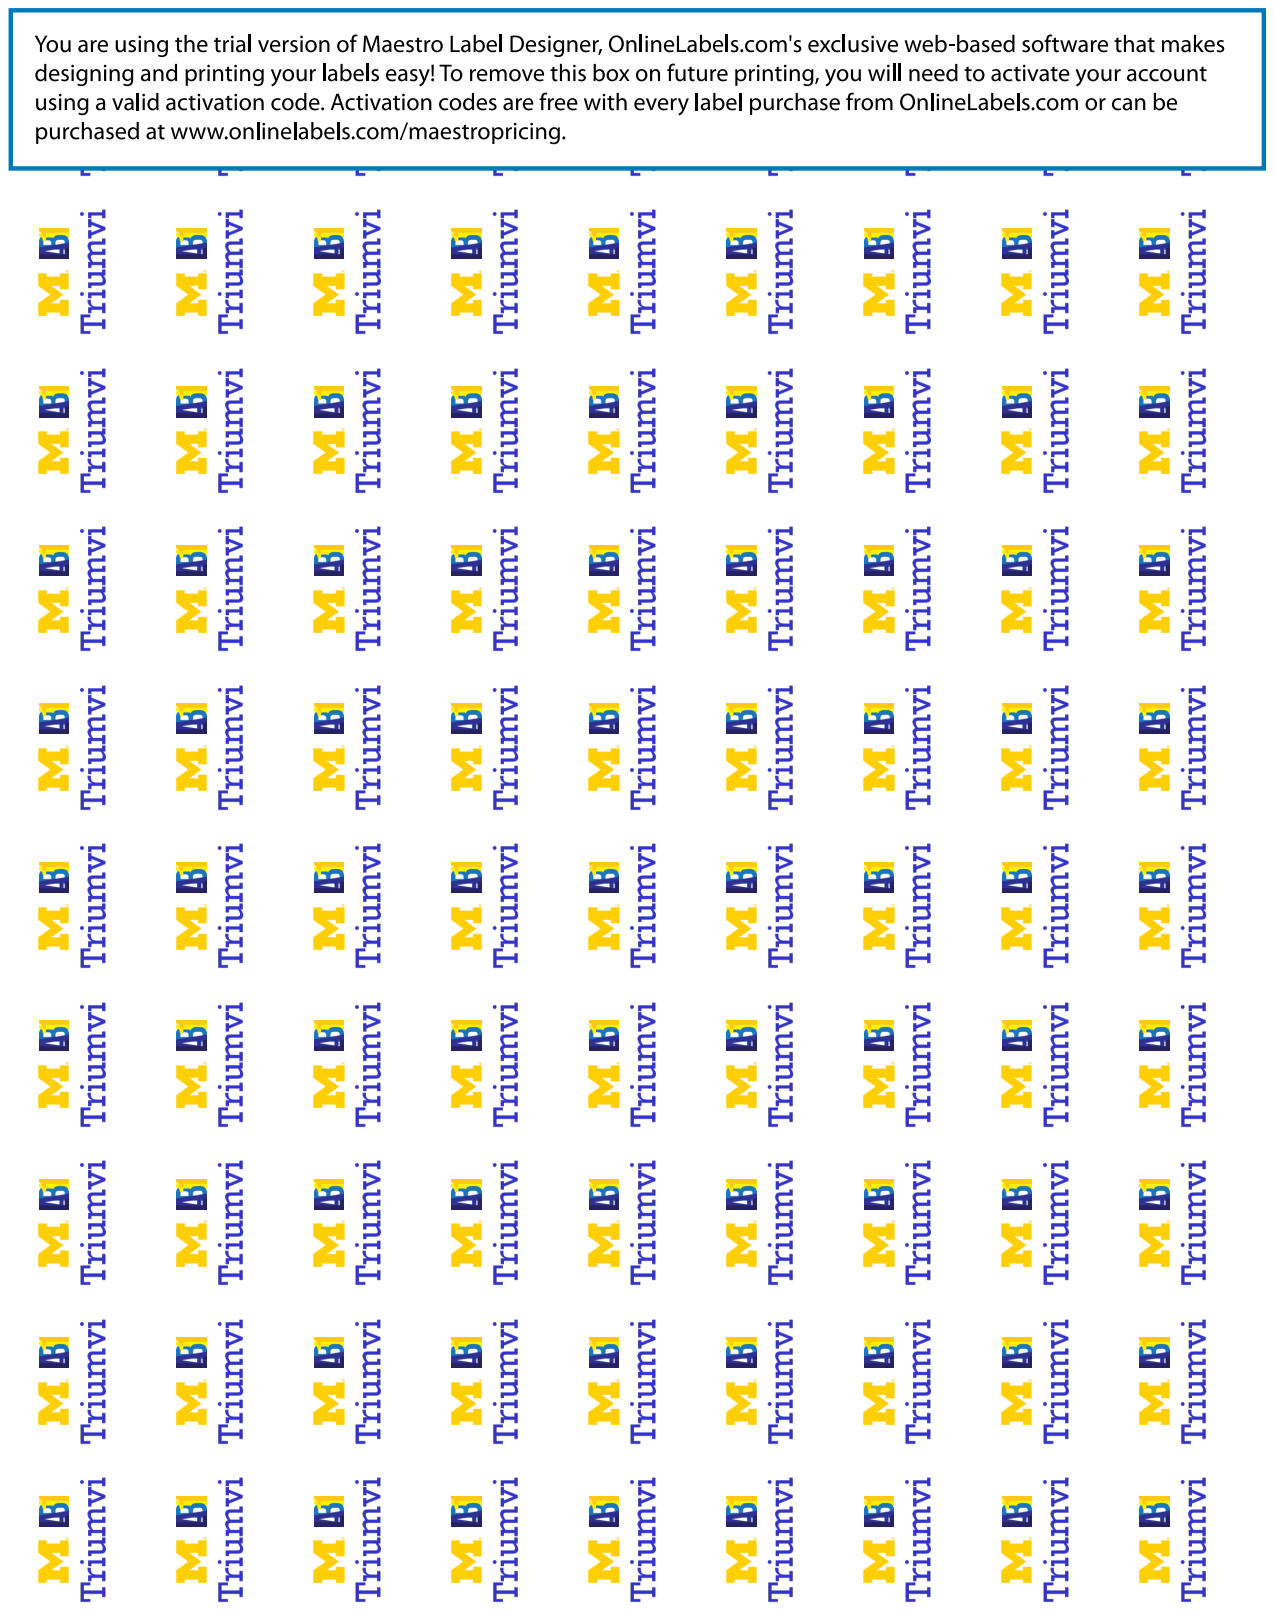
[picture p24: page 1]
