lab11/triumvi/hardware/v7/Project Outputs for coilcube_frontend_v2/schematic.PDF

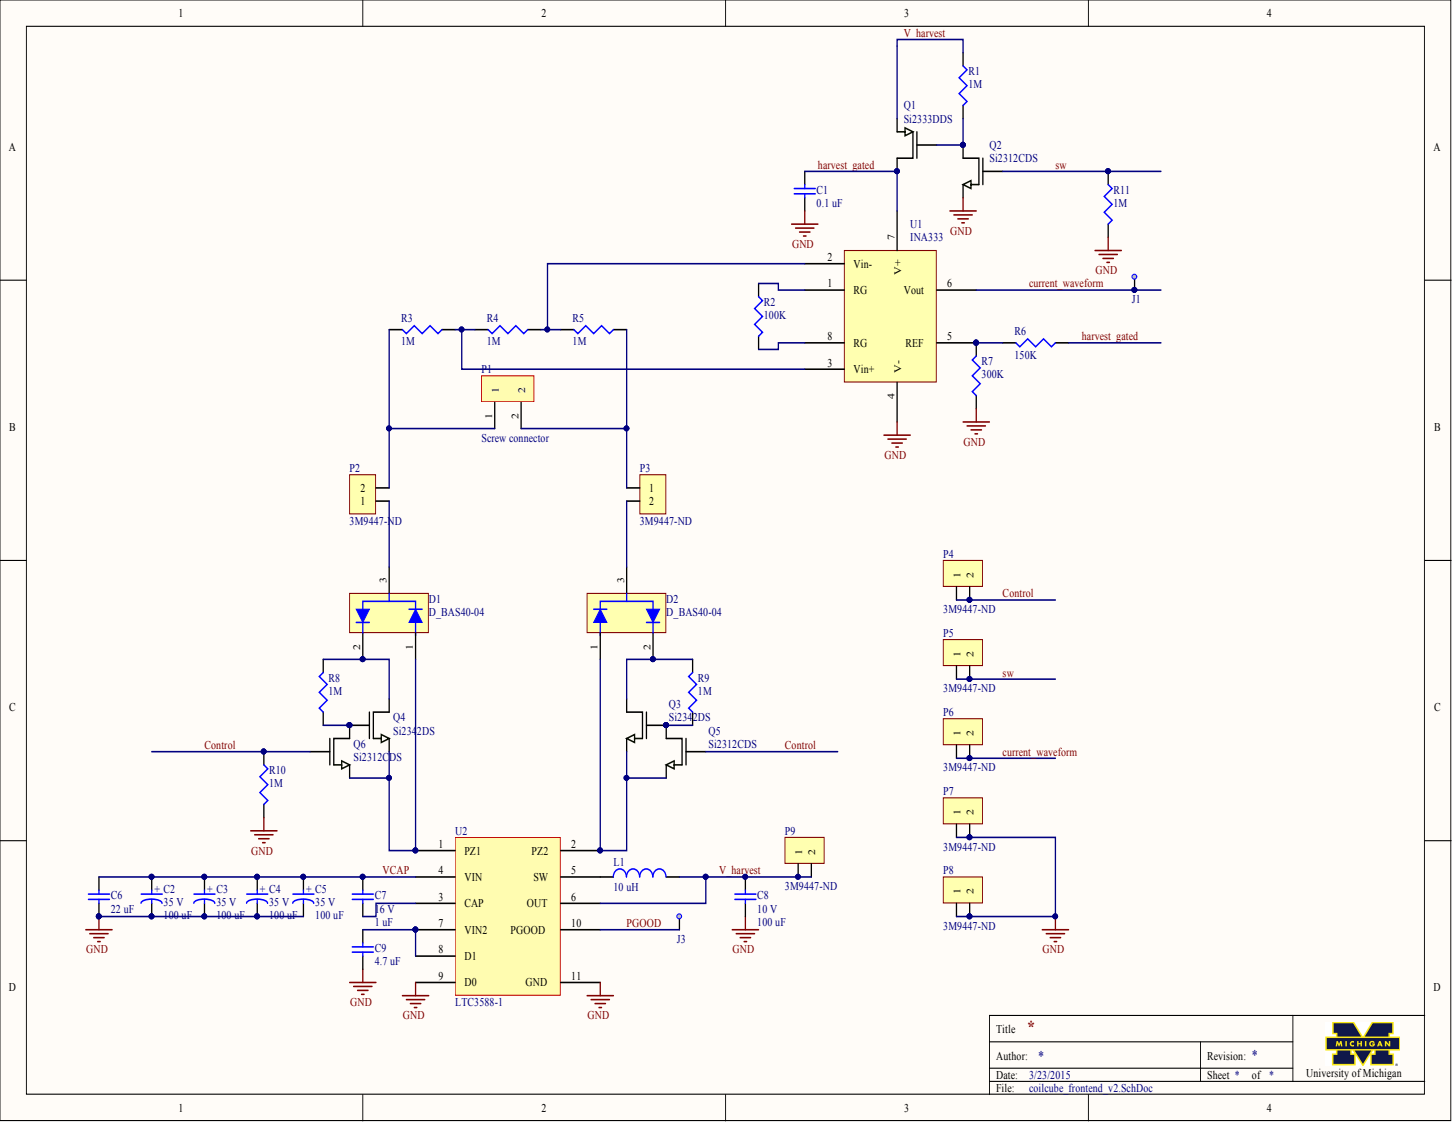
[picture p25: page 1]

CAP 3 | 10 uH

16 V | VIN2 7

Title * | University of Michigan

Author: * | Revision: *
Date: 3/23/2015 | Sheet * of *
