lab11/triumvi/hardware/v7/Project Outputs for coilcube_frontend_v2/schematic_v3.PDF

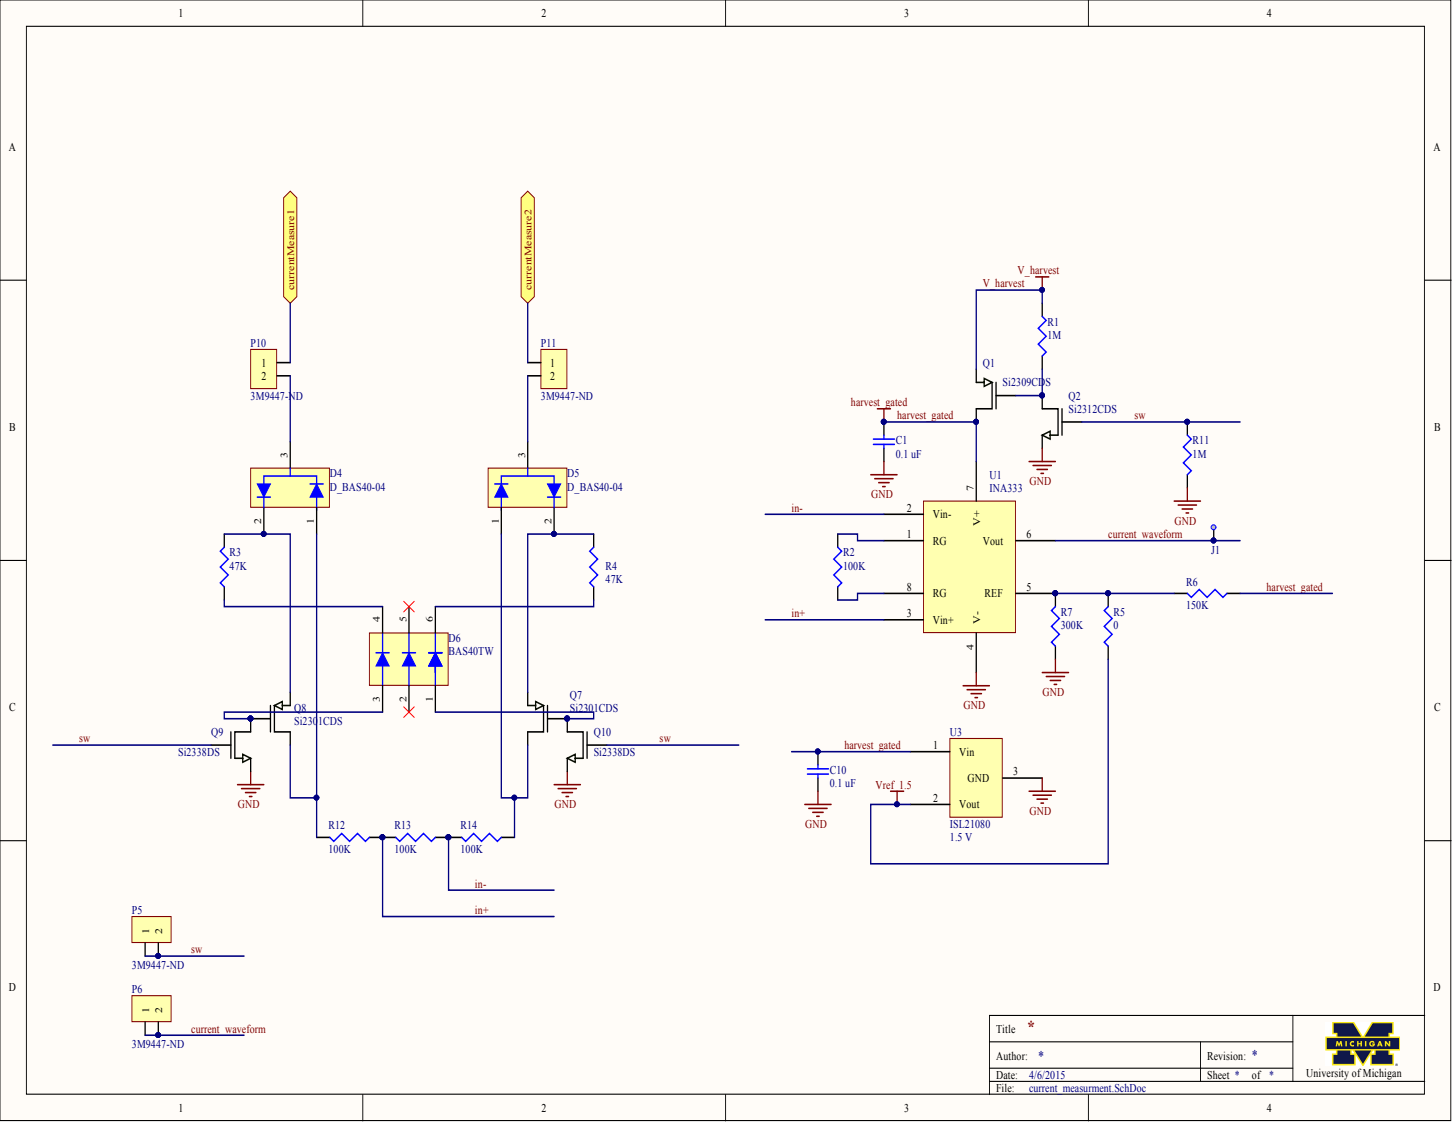
[picture p26: page 1]

Title * | University of Michigan

Author: * | Revision: *
Date: | Sheet * of *

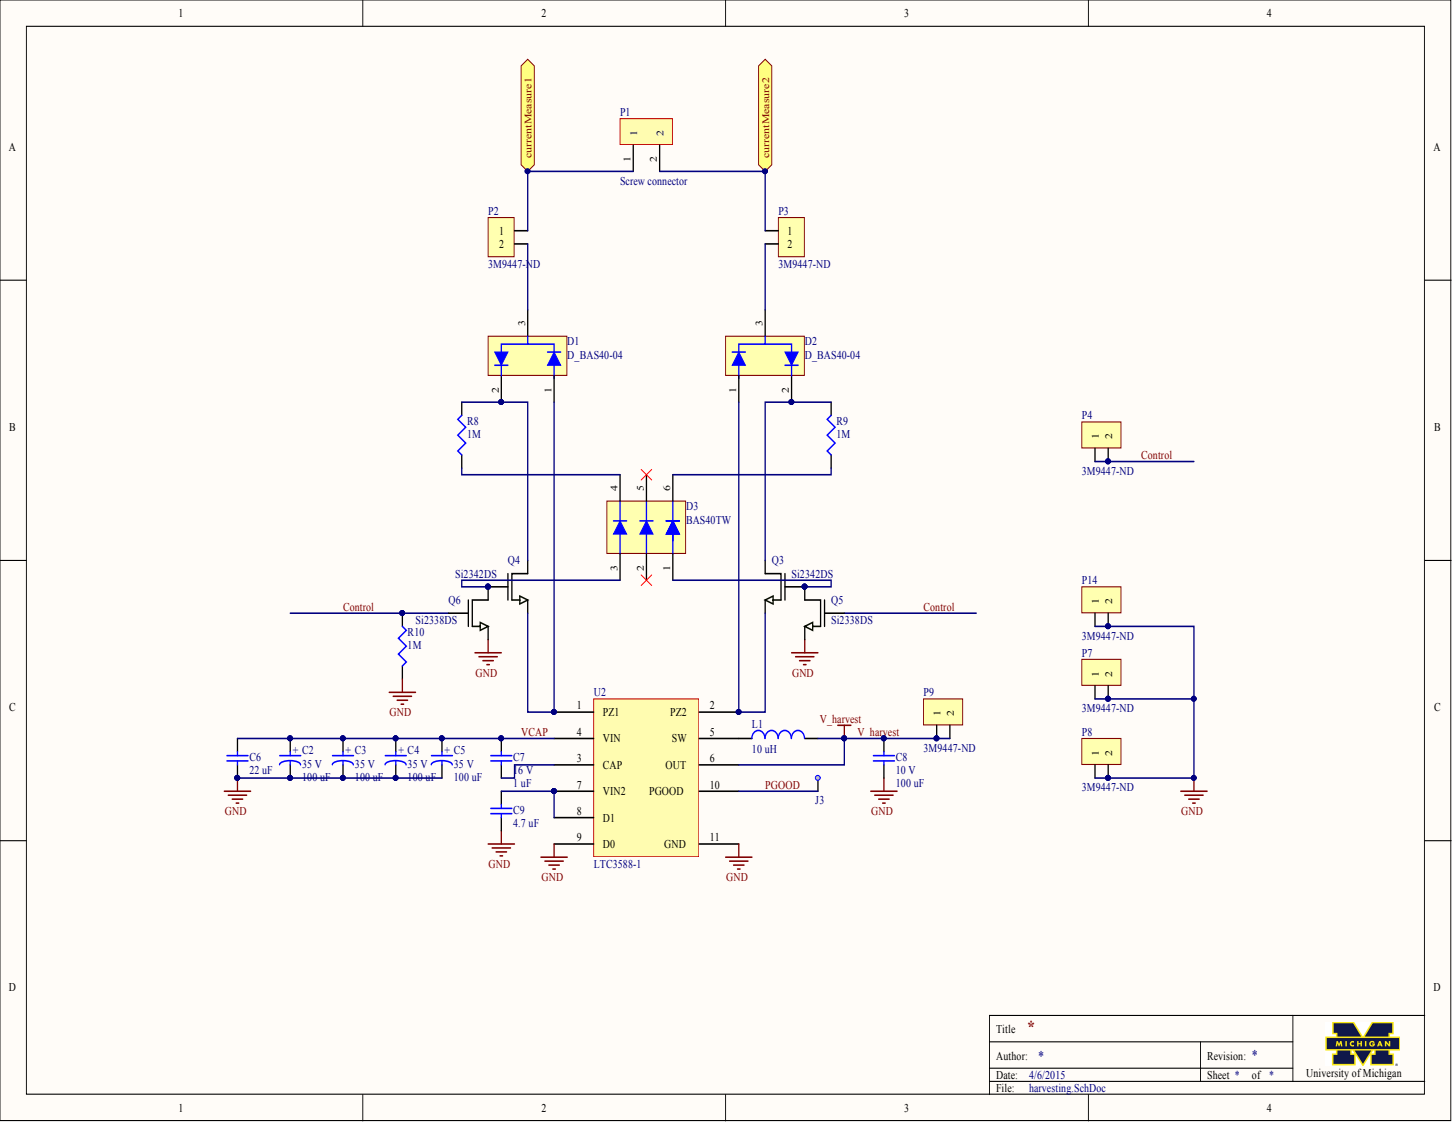
[picture p27: page 2]

CAP 3 | 10 uH

16 V | VIN2 7

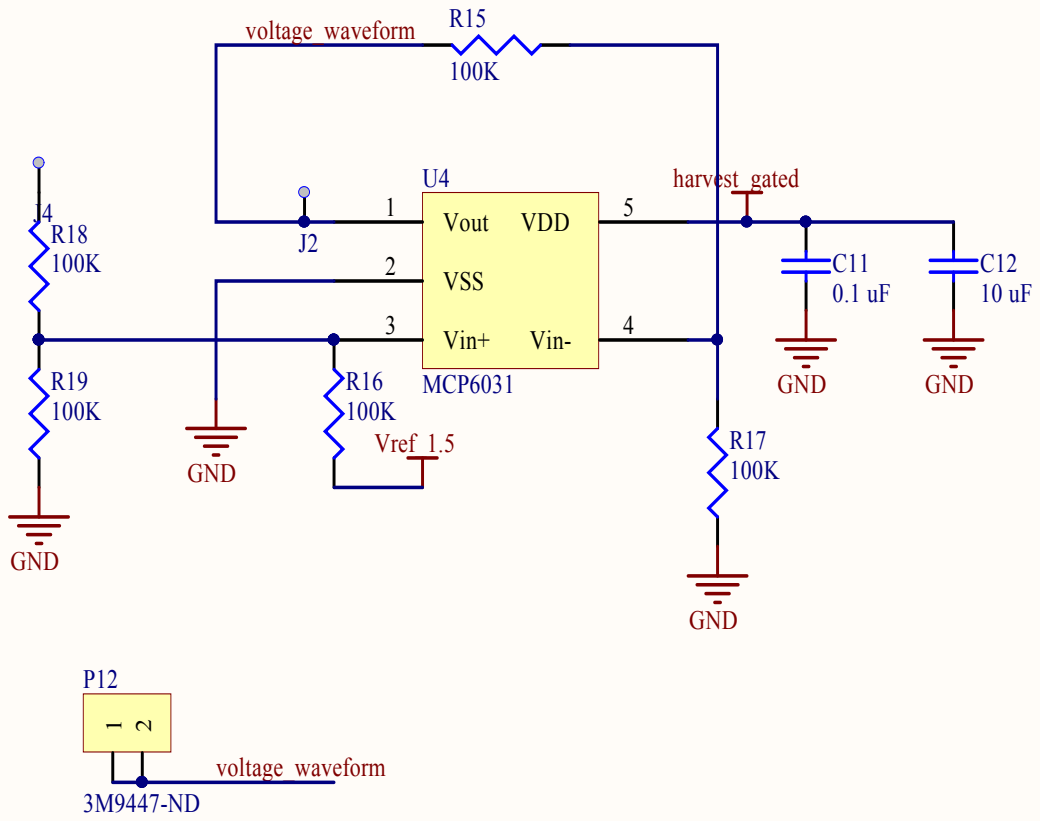
[picture p28: page 3]
