lab11/triumvi/hardware/v11/mcu/schematic/schematic.PDF

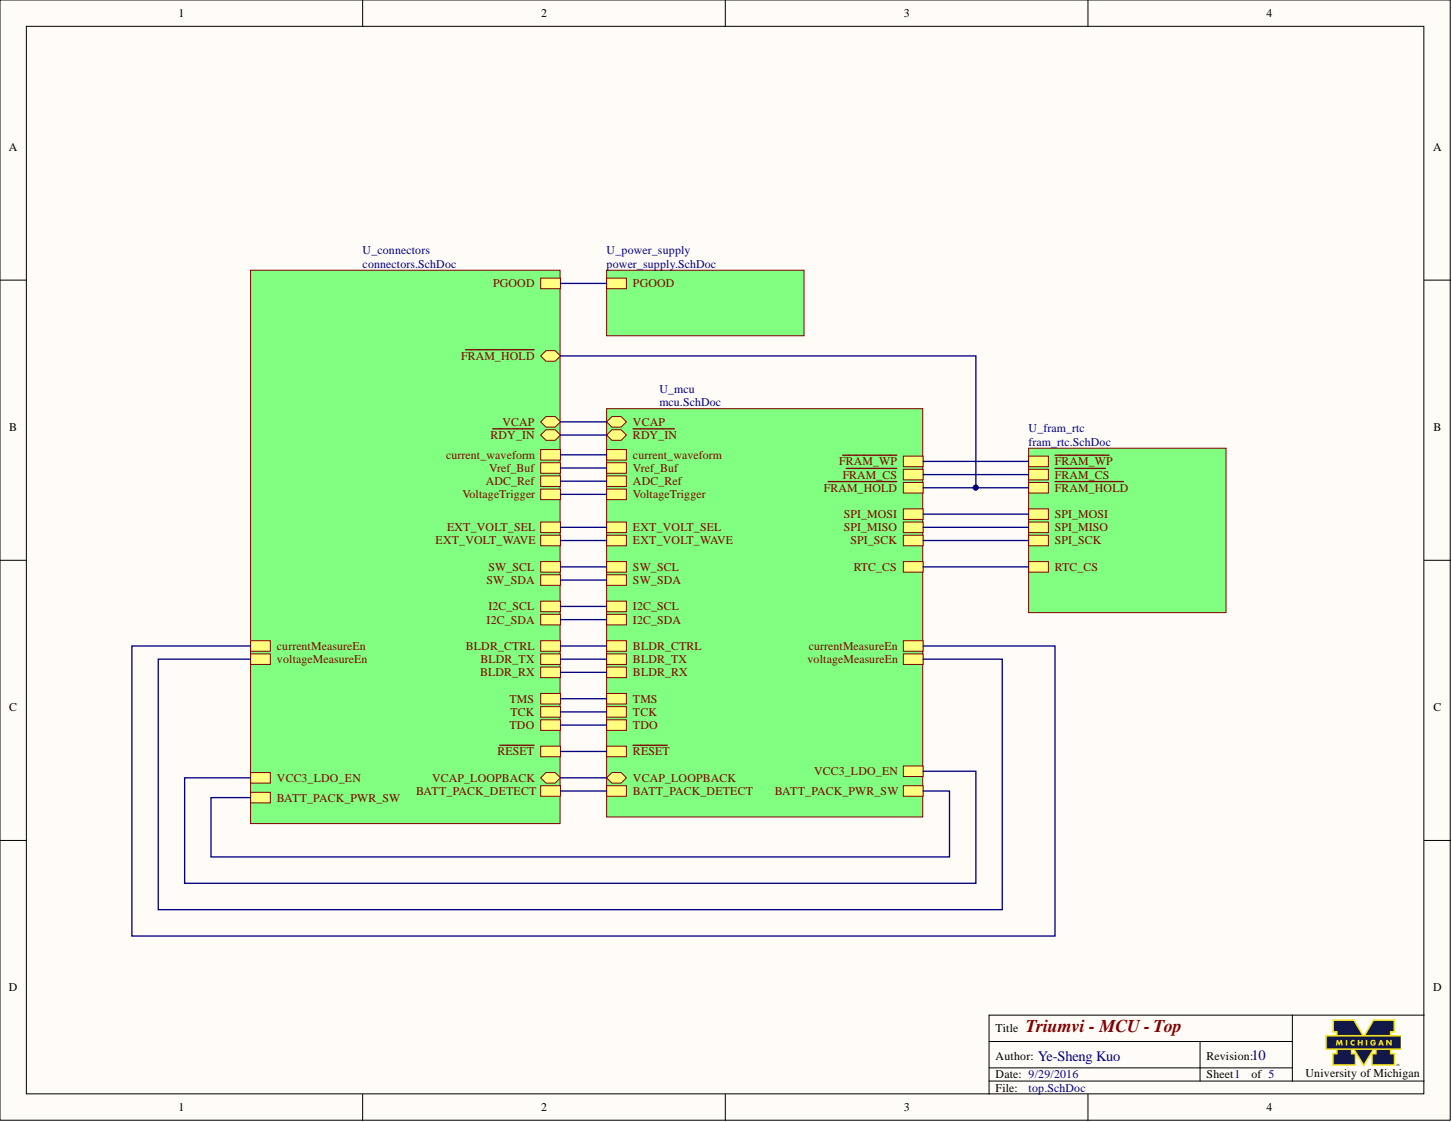
[picture p29: page 1]

Triumvi - MCU - Top Title | University of Michigan

Author: Ye-Sheng Kuo | Revision:
Date: | Sheet of

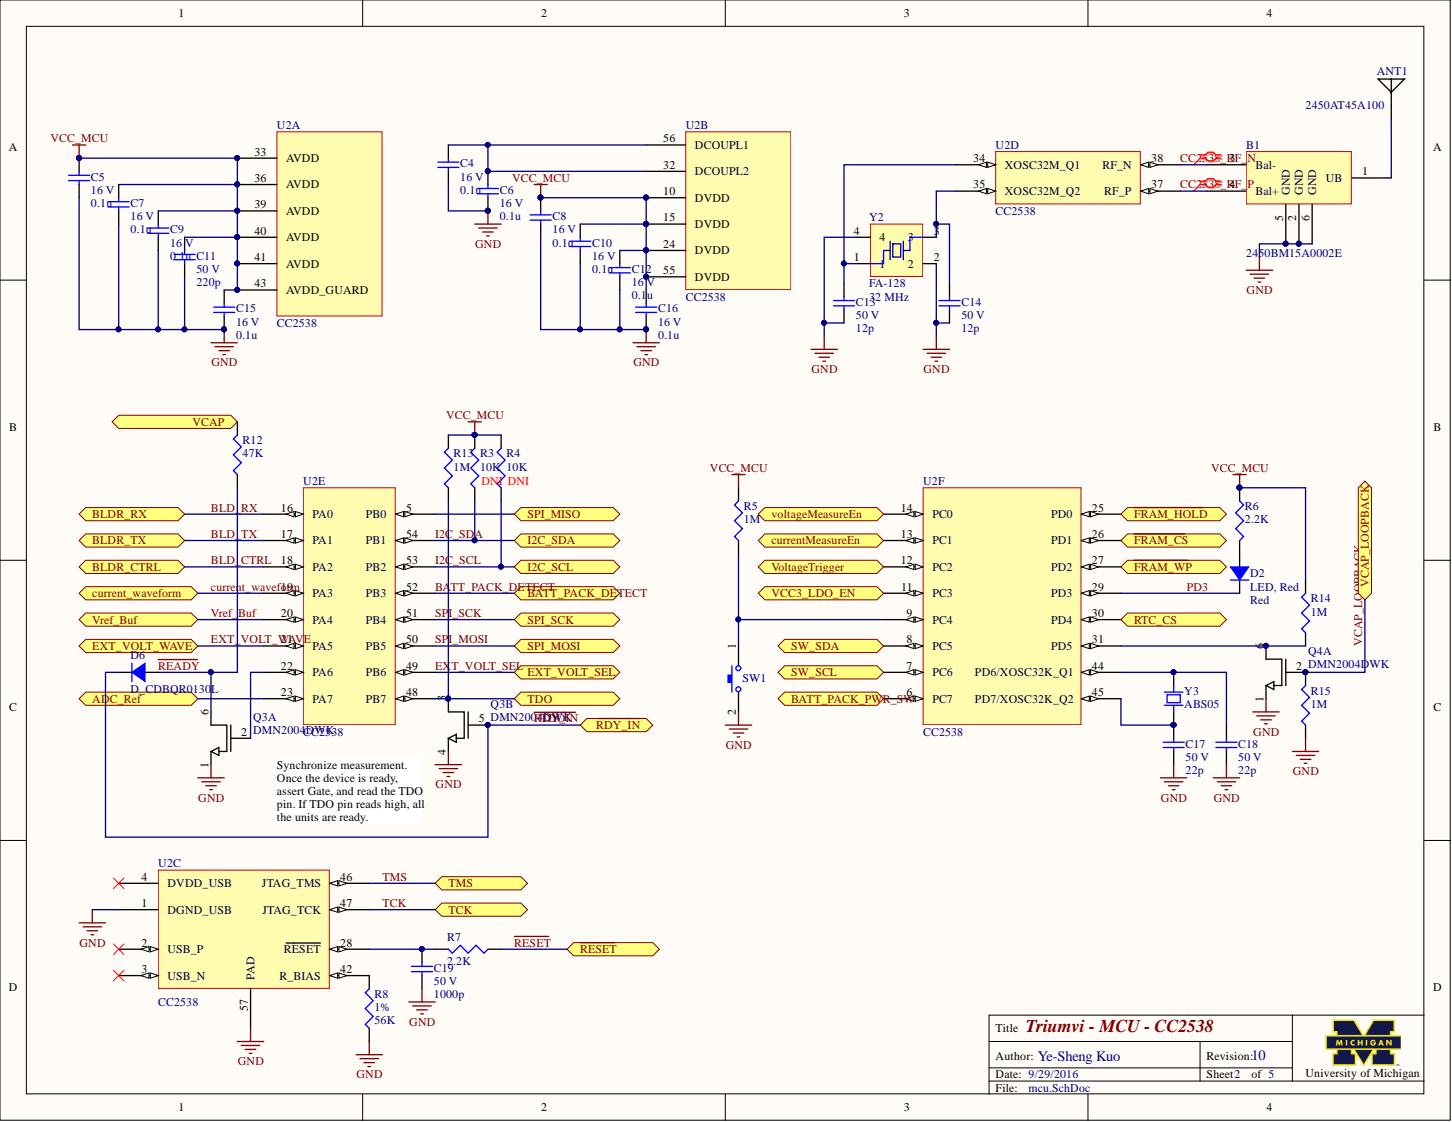
[picture p30: page 2]

Synchronize measurement.
Once the device is ready,
assert Gate, and read the TDO
pin. If TDO pin reads high, all
the units are ready.

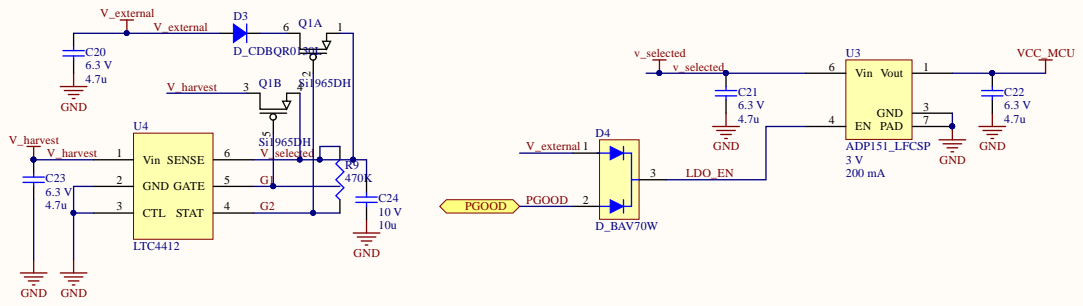
[picture p31: page 3]

Triumvi - MCU - Power supply T i t l e | U n i vers i t y of Mich i gan

A u t h or: Ye-S h e n g Ku o | Rev i s i o n :

/ / | Sheet o f

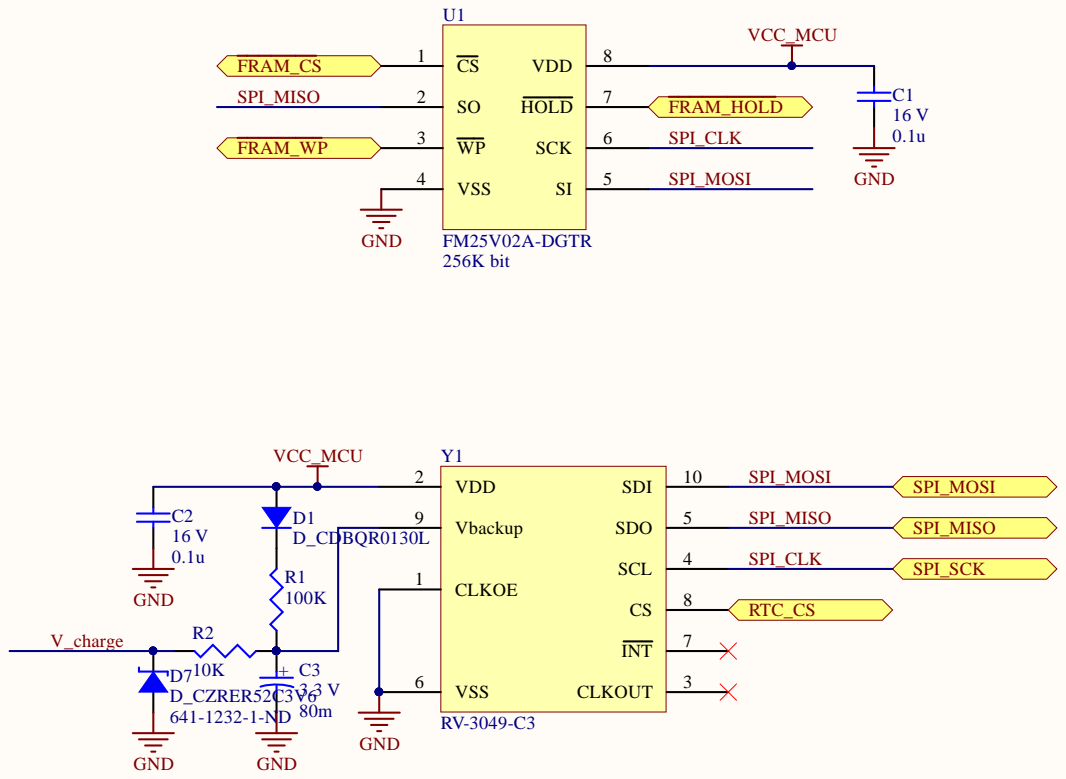
[picture p32: page 4]

Triumvi - MCU - FRAM, RTC

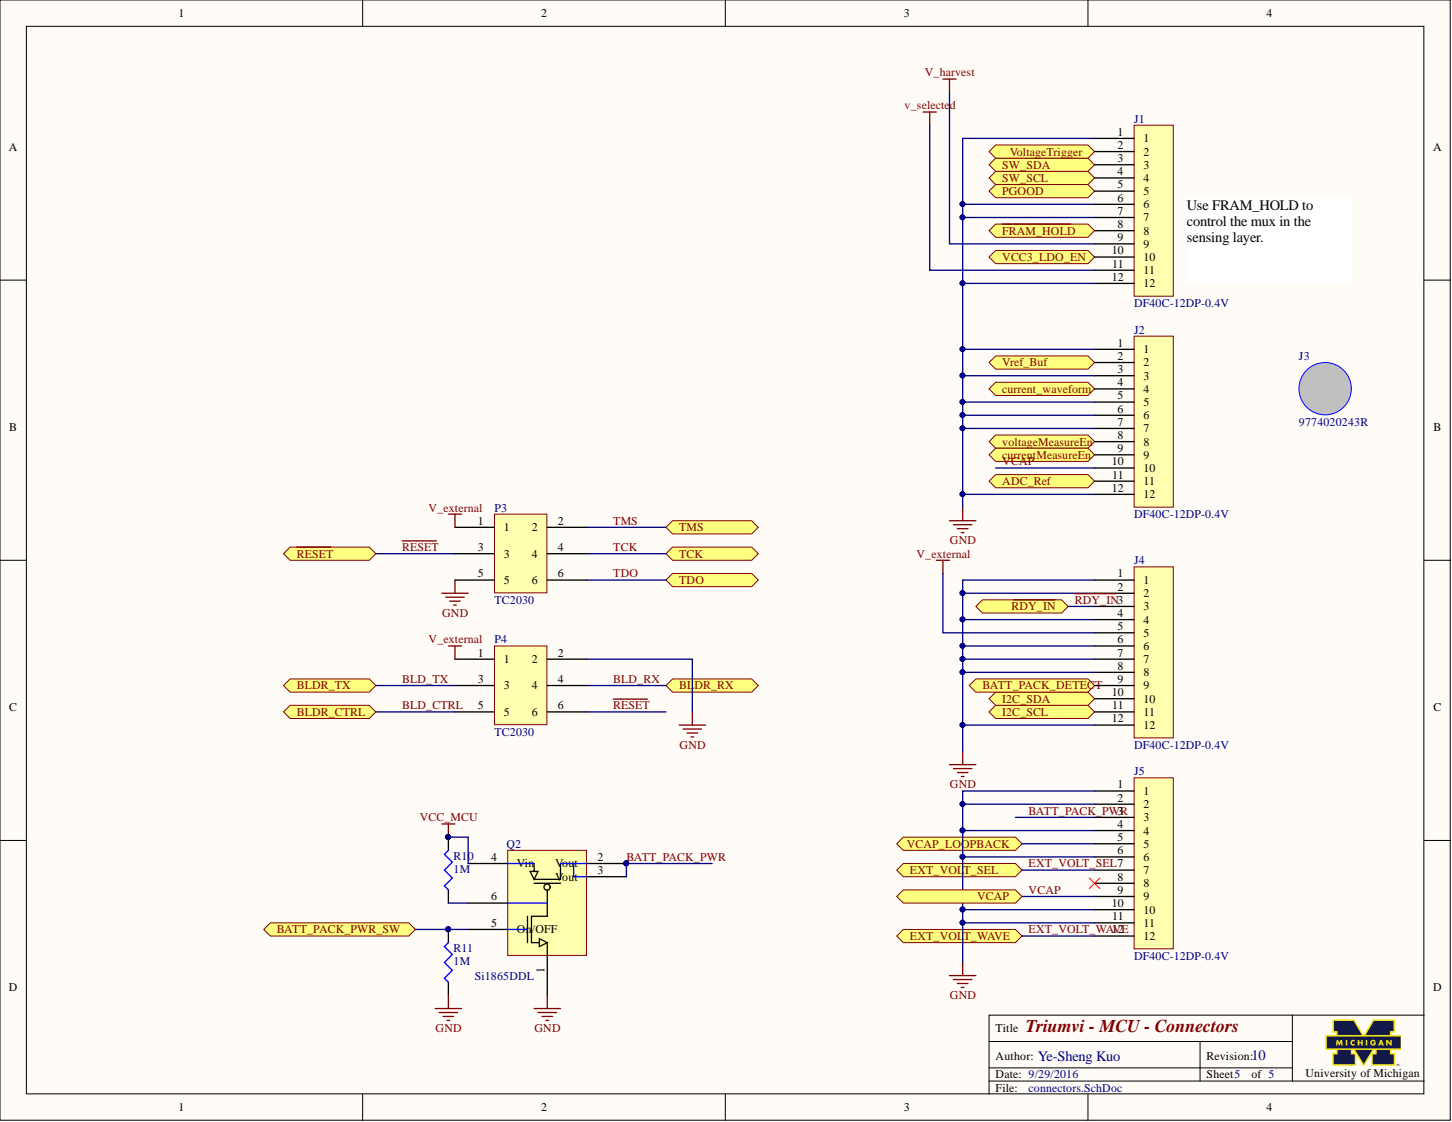
[picture p33: page 5]

Use FRAM_HOLD to
control the mux in the
sensing layer.

FRAM_HOLD | 8 8

VCC3_LDO_EN | 10 10

RDY_IN | 3 3 4 4

BATT_PACK_PWR | 3 3 4 4

Vin 4

EXT_VOLT_SEL VCAP VCAP | 7 7 8 8

11 11
12 12

On/OFF 5
