lab11/triumvi/hardware/v11/sensing/schematic/schematic.PDF

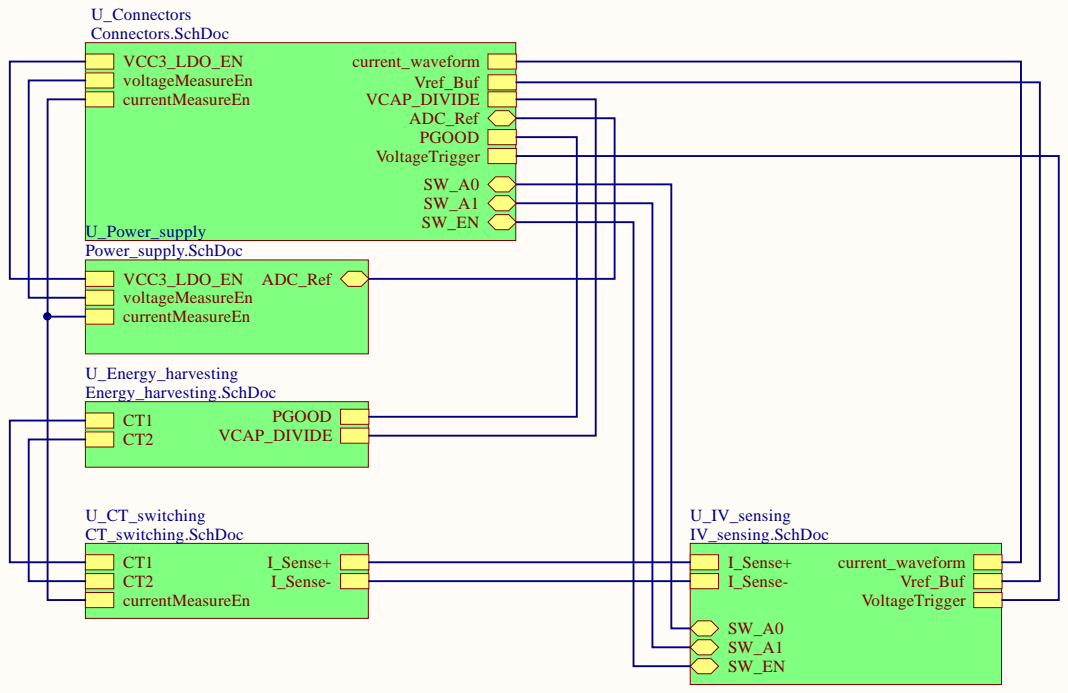
[picture p34: page 1]

ADC_Ref

Power_supply.SchDoc

Triumvi - Sensing - Top Title | University of Michigan

Author: Ye-Sheng Kuo | Revision:
Date: | Sheet of

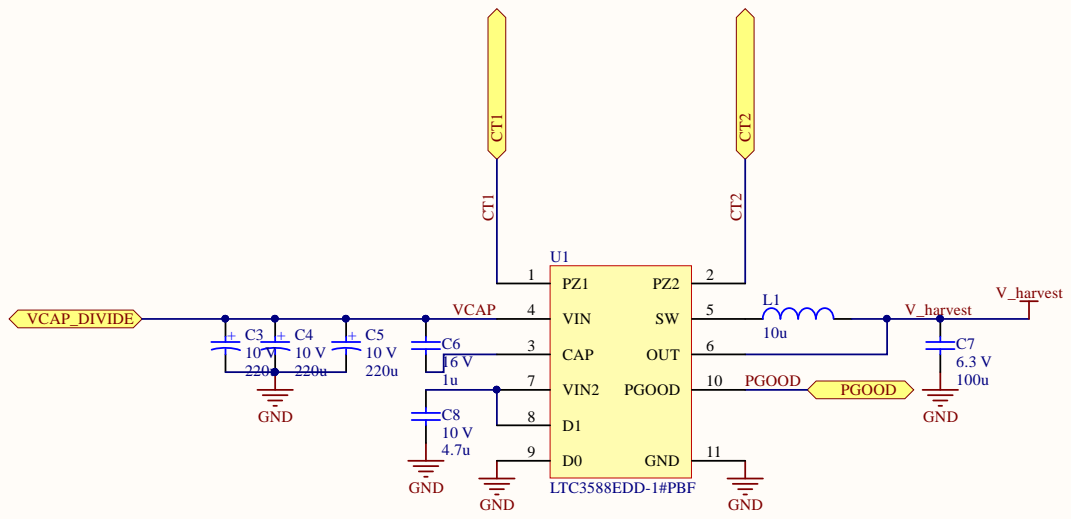
[picture p35: page 2]

16 V | VIN2 7

Triumvi - Sensing - Energy Harvesting

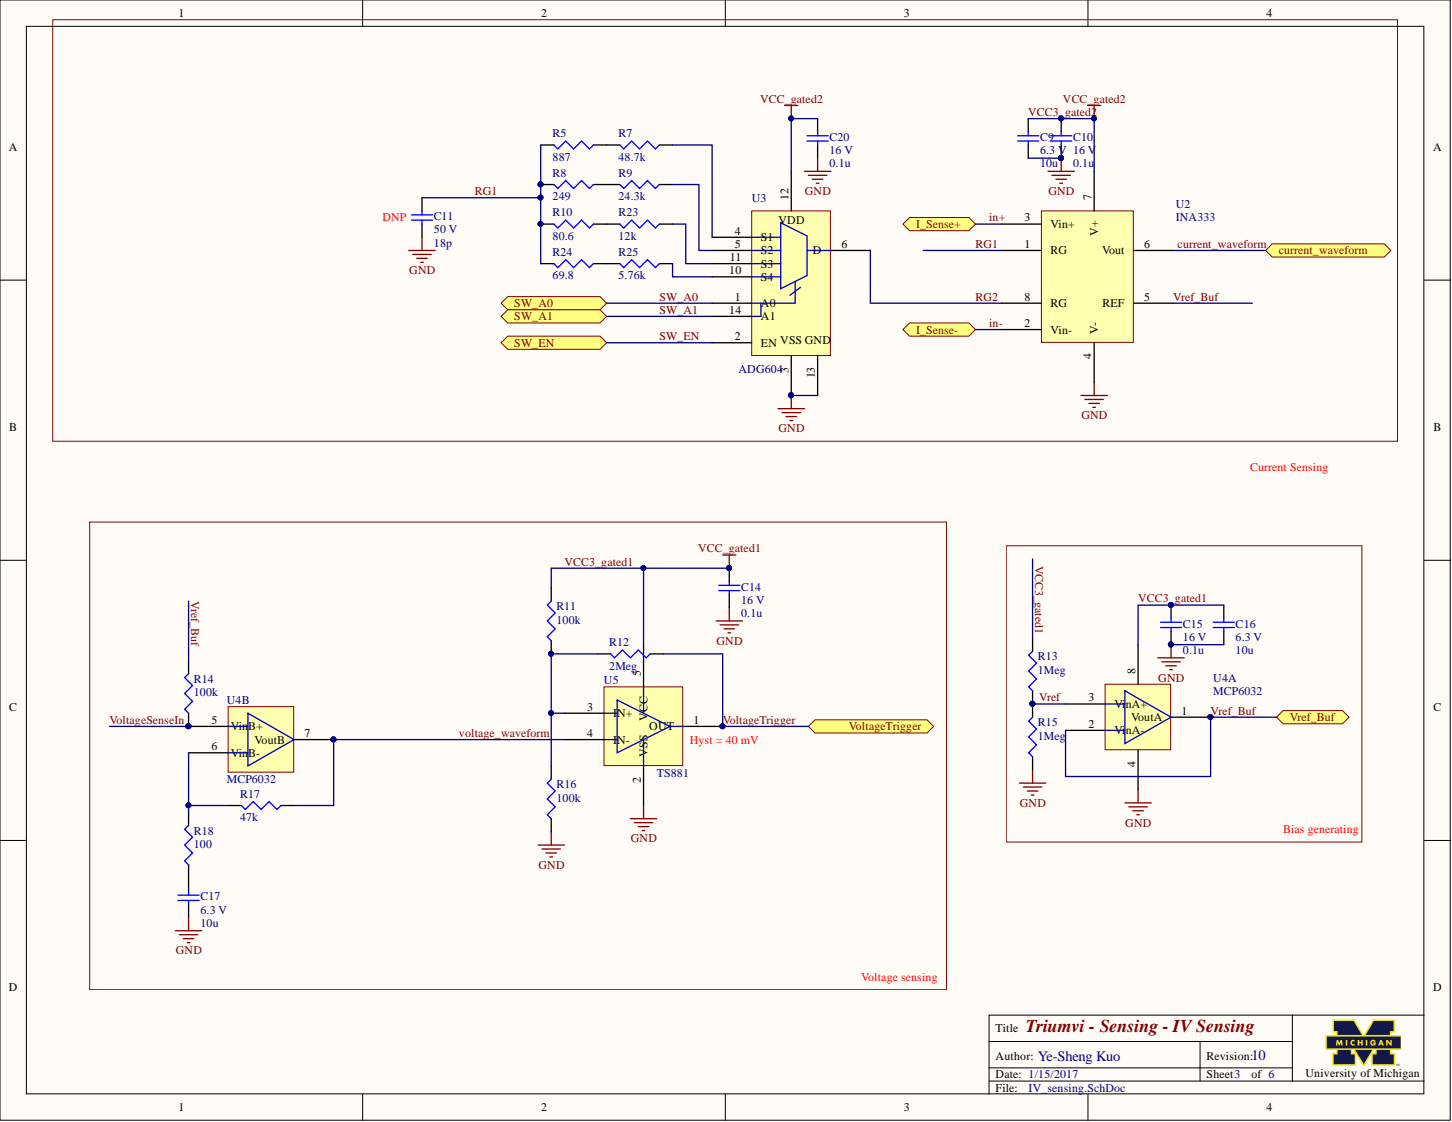
[picture p36: page 3]

Triumvi - Sensing - IV Sensing

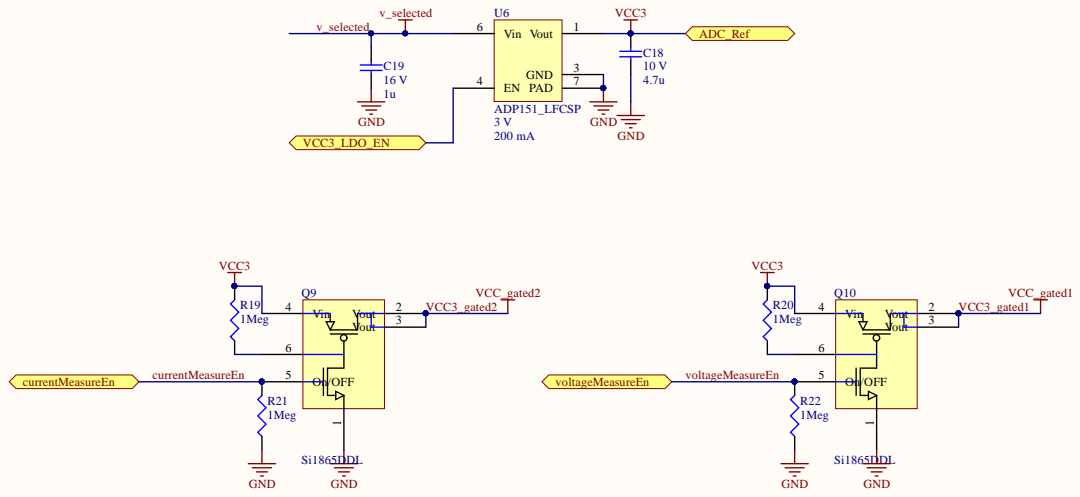
[picture p37: page 4]

Triumvi - Sensing - Power Supply

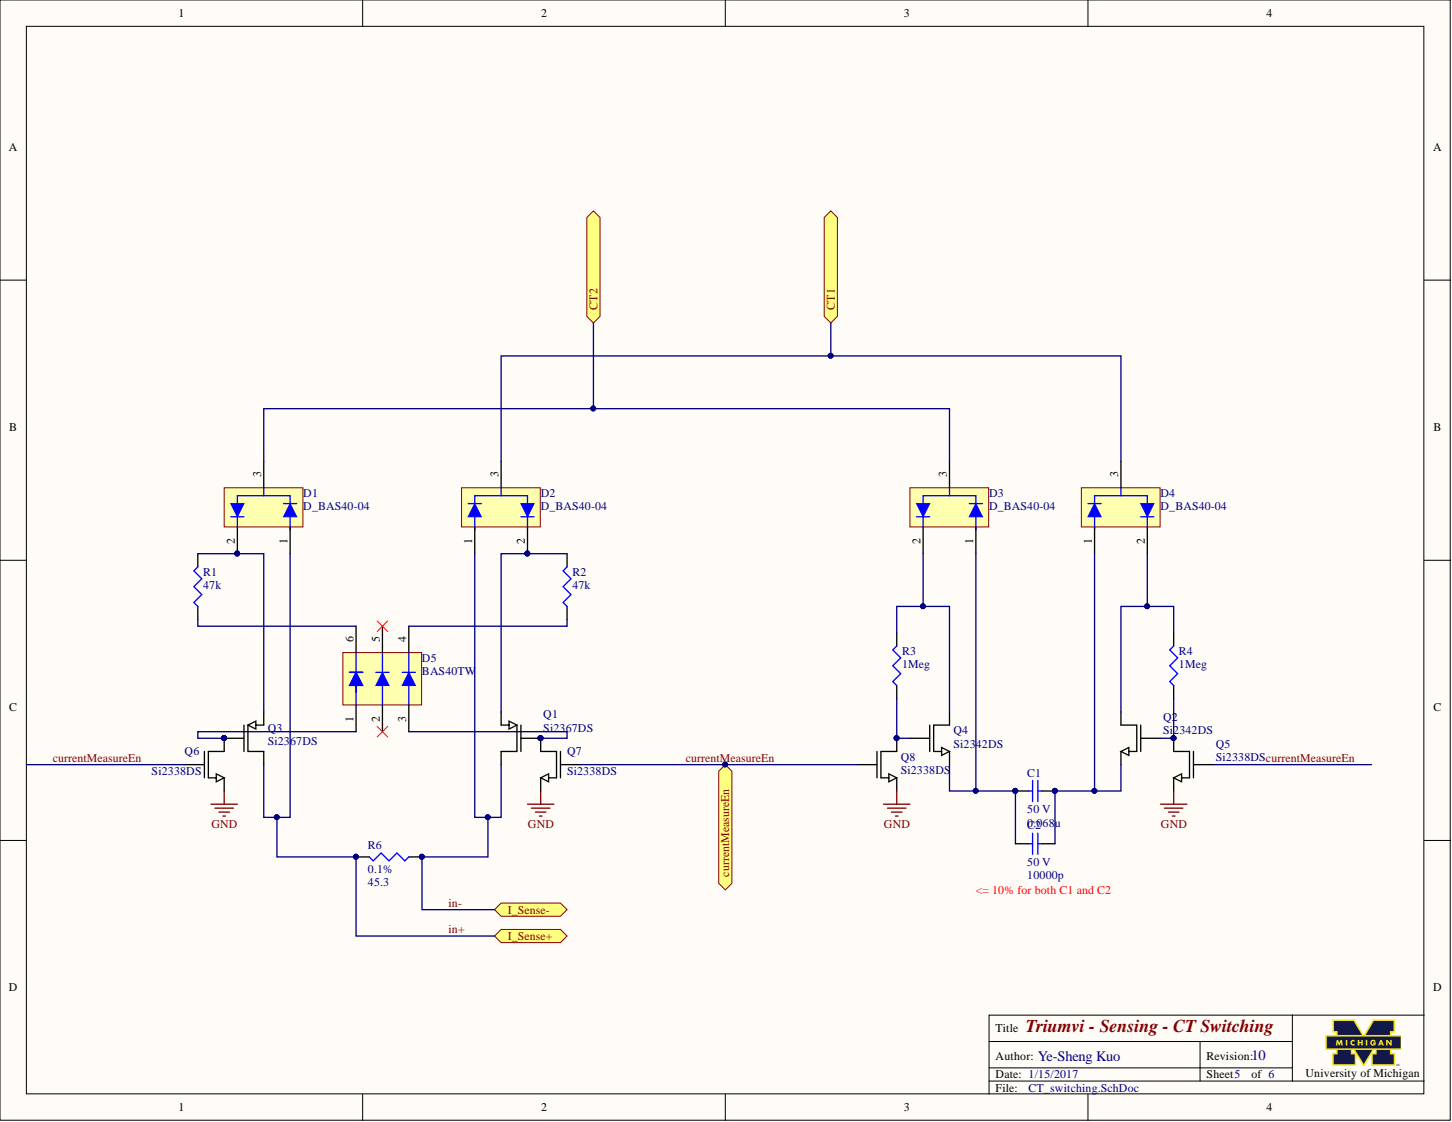
[picture p38: page 5]

Triumvi - Sensing - CT Switching

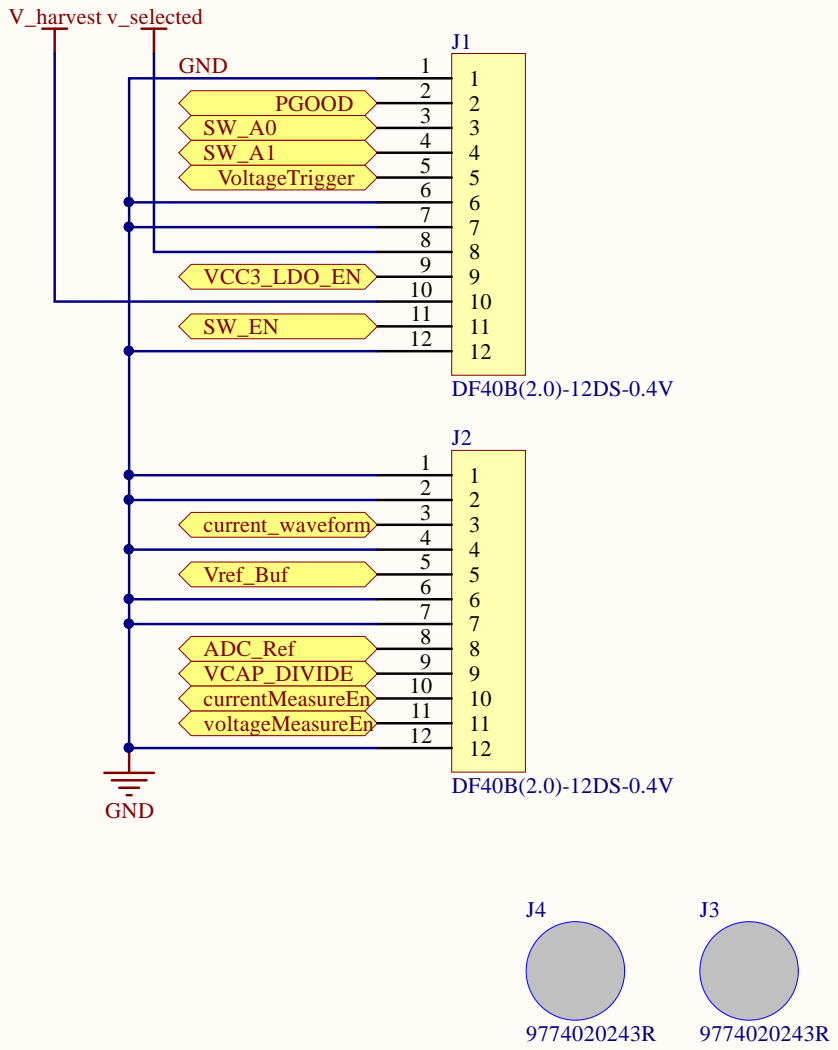
[picture p39: page 6]
