lab11/triumvi/hardware/v9/mcu/schematic/schematic.PDF

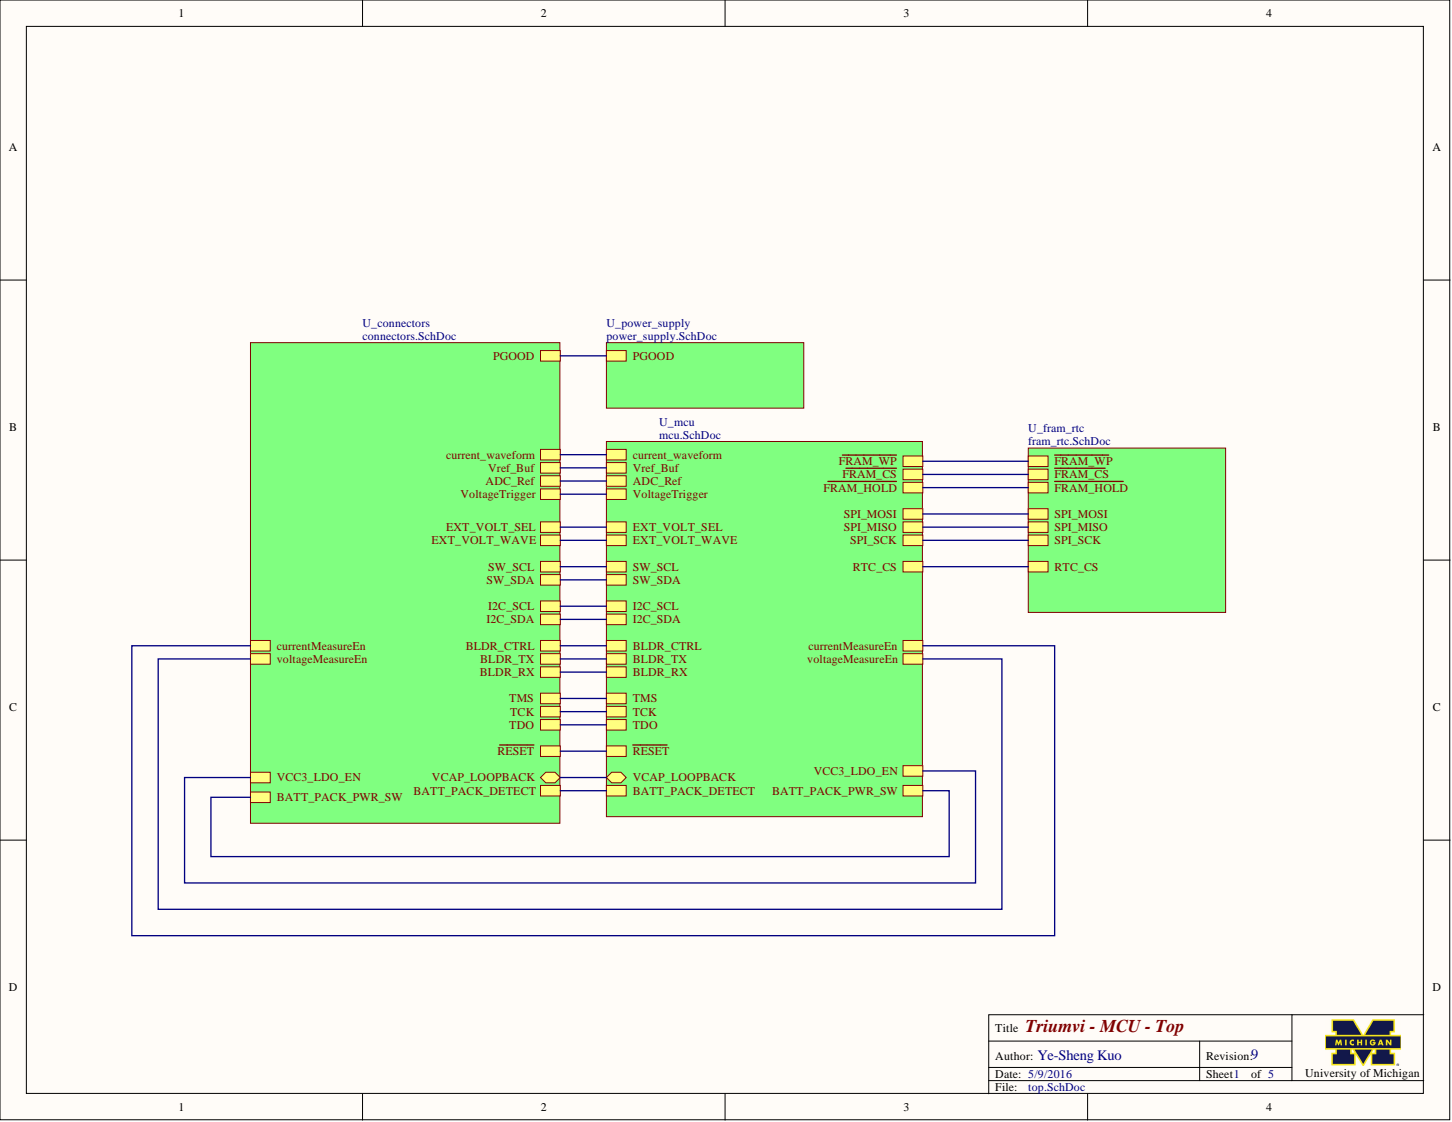
[picture p40: page 1]

Triumvi - MCU - Top Title | University of Michigan

Author: Ye-Sheng Kuo | Revision:
Date: | Sheet of

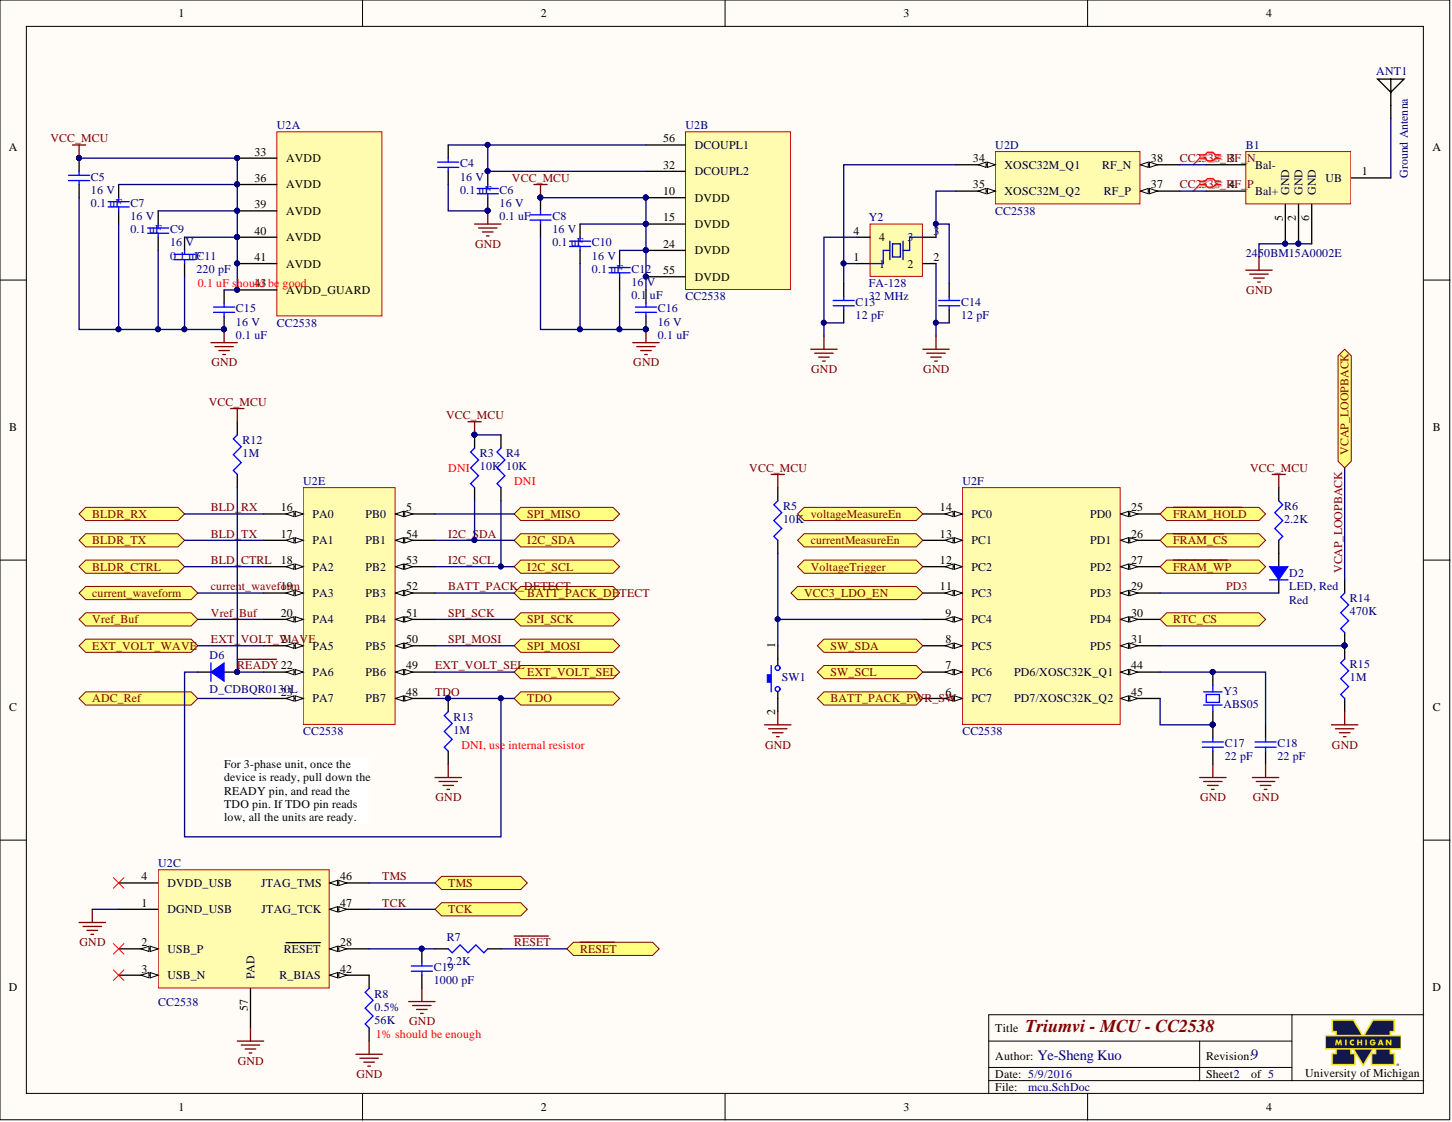
[picture p41: page 2]

For 3-phase unit, once the
device is ready, pull down the
READY pin, and read the
TDO pin. If TDO pin reads
low, all the units are ready.

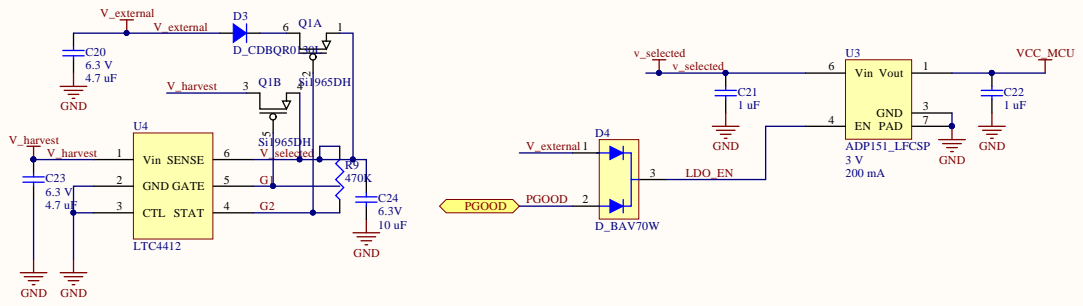
[picture p42: page 3]

Triumvi - MCU - Power supply9 5/9/2016 power_supply.SchDoc A u t h or: Y e-S h e n g Ku o | Rev i s i o n :
T i t l e | U n i vers i t y of Mich i gan

Sheet o f

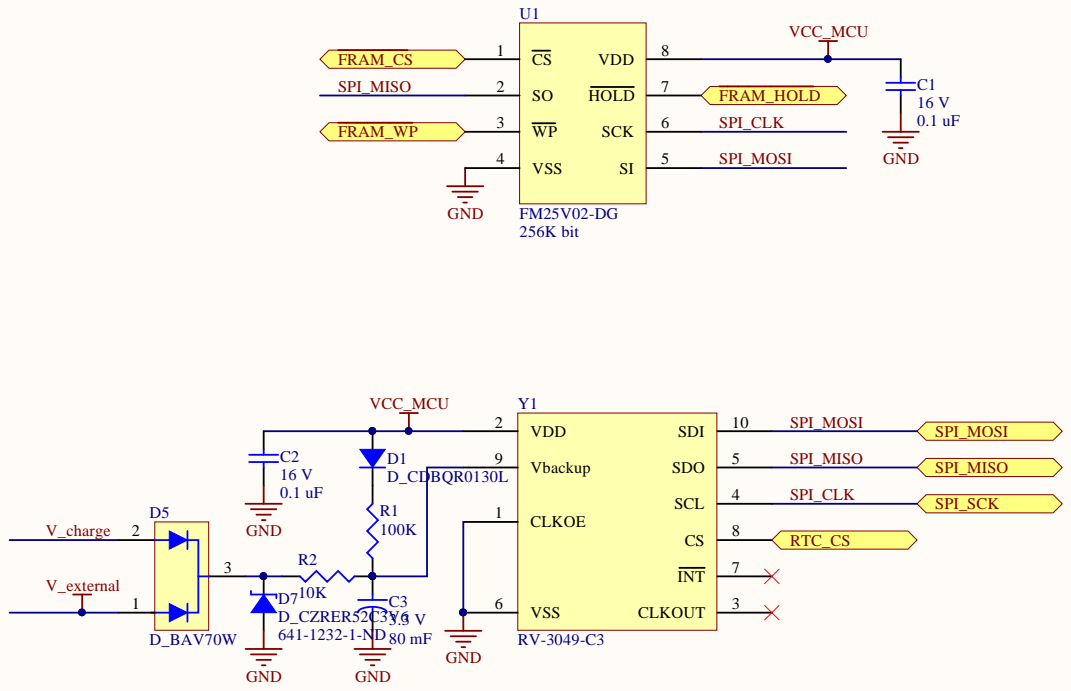
[picture p43: page 4]

Triumvi - MCU - FRAM, RTC

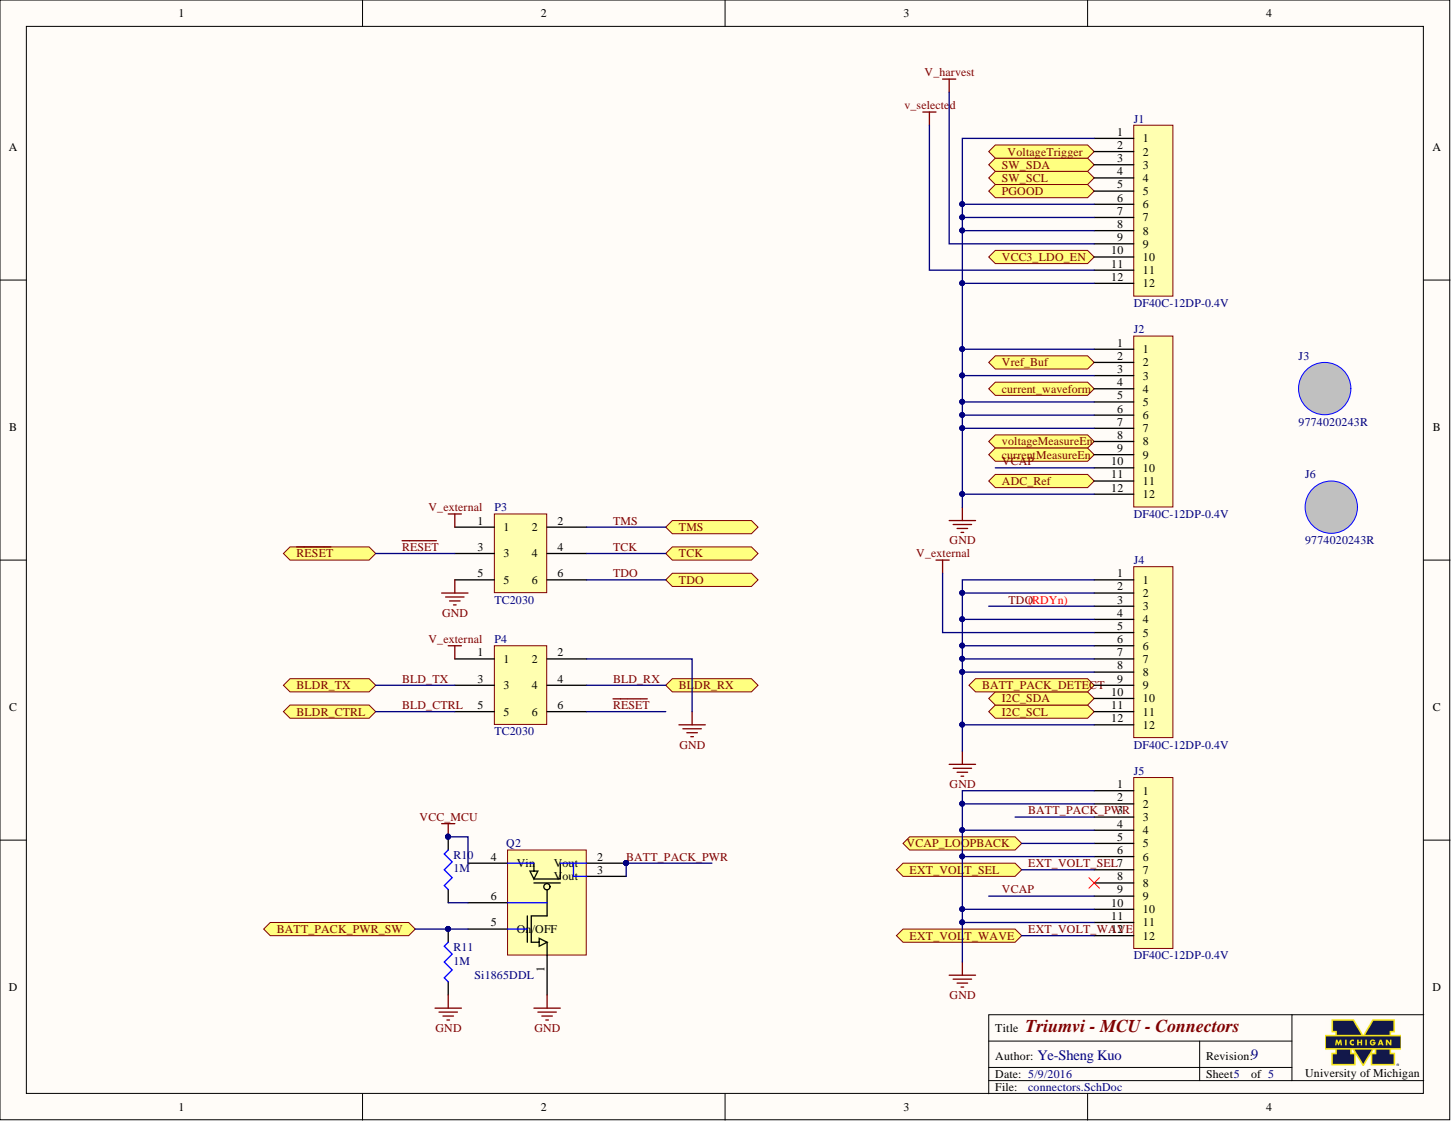
[picture p44: page 5]

7 7
8 8
9 9

VCC3_LDO_EN | 10 10

TDO(RDYn) | 3 3

BATT_PACK_PWR | 3 3 4 4

Vin 4

EXT_VOLT_SEL VCAP | 7 7 8 8

11 11
12 12

On/OFF 5
