lab11/triumvi/hardware/v9/sensing/schematic/schematic.PDF

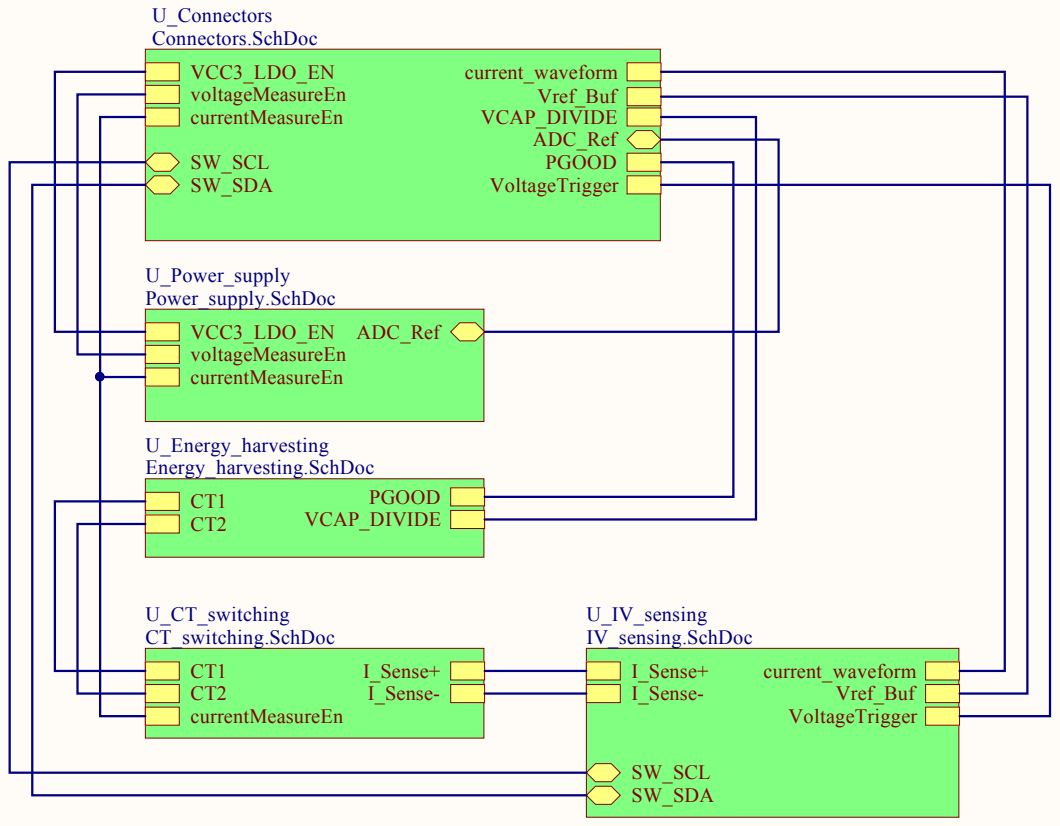
[picture p45: page 1]

ADC_Ref

SW_SDA

U_Power_supply Power_supply.SchDoc

Triumvi - Sensing - Top Title | University of Michigan

Author: Ye-Sheng Kuo | Revision:
Date: | Sheet of

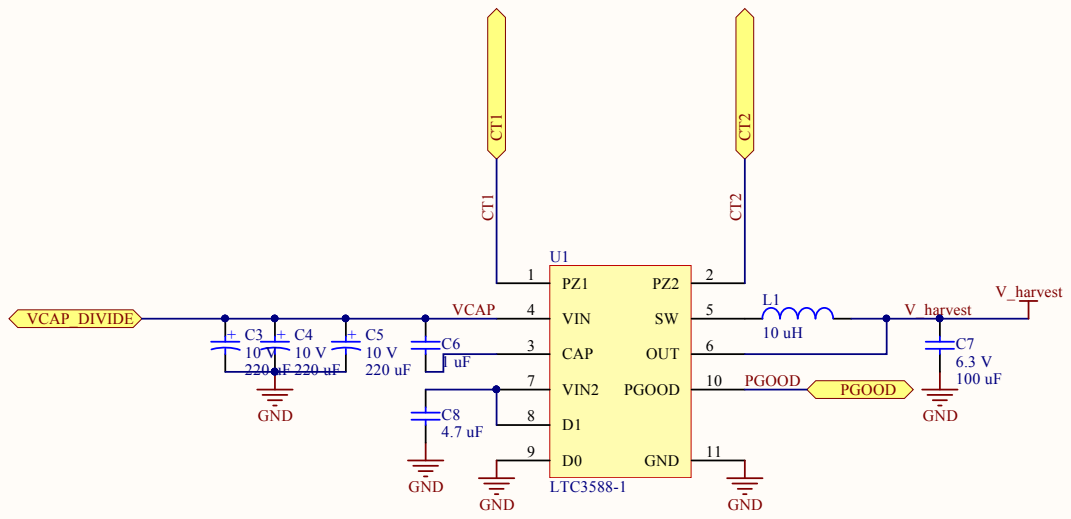
[picture p46: page 2]

1 uF | VIN2 7

Triumvi - Sensing - Energy Harvesting

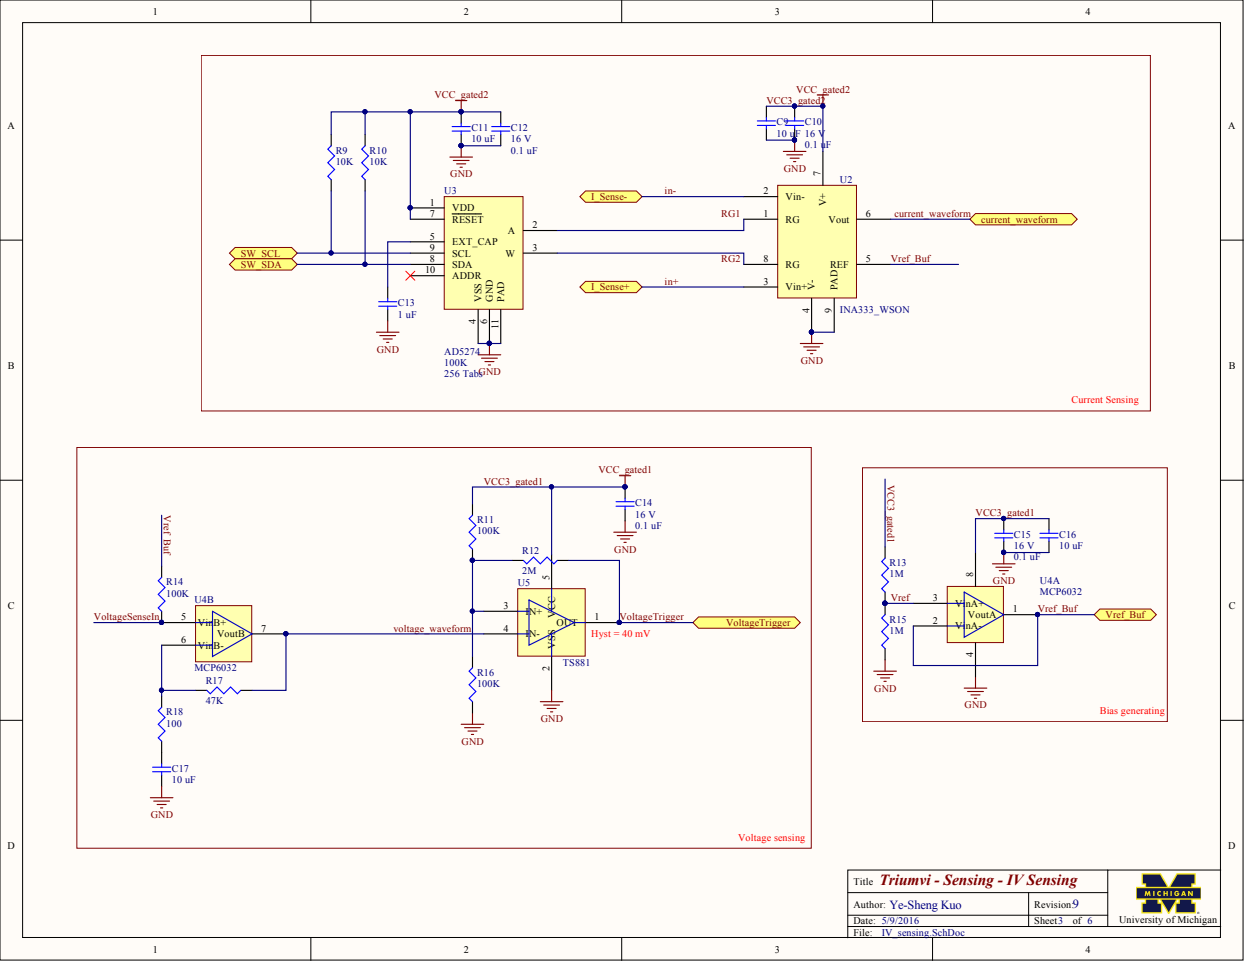
[picture p47: page 3]

Triumvi - Sensing - IV Sensing

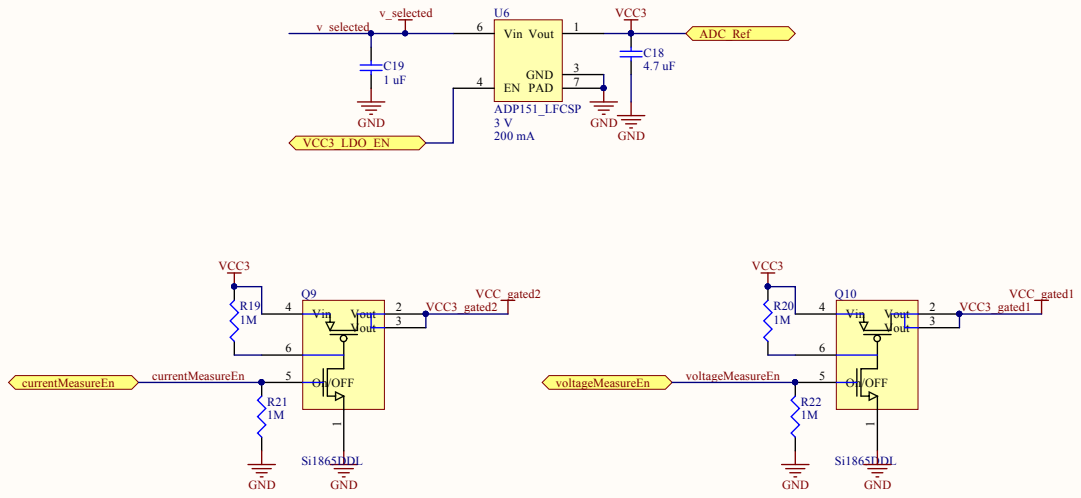
[picture p48: page 4]

Triumvi - Sensing - Power Supply

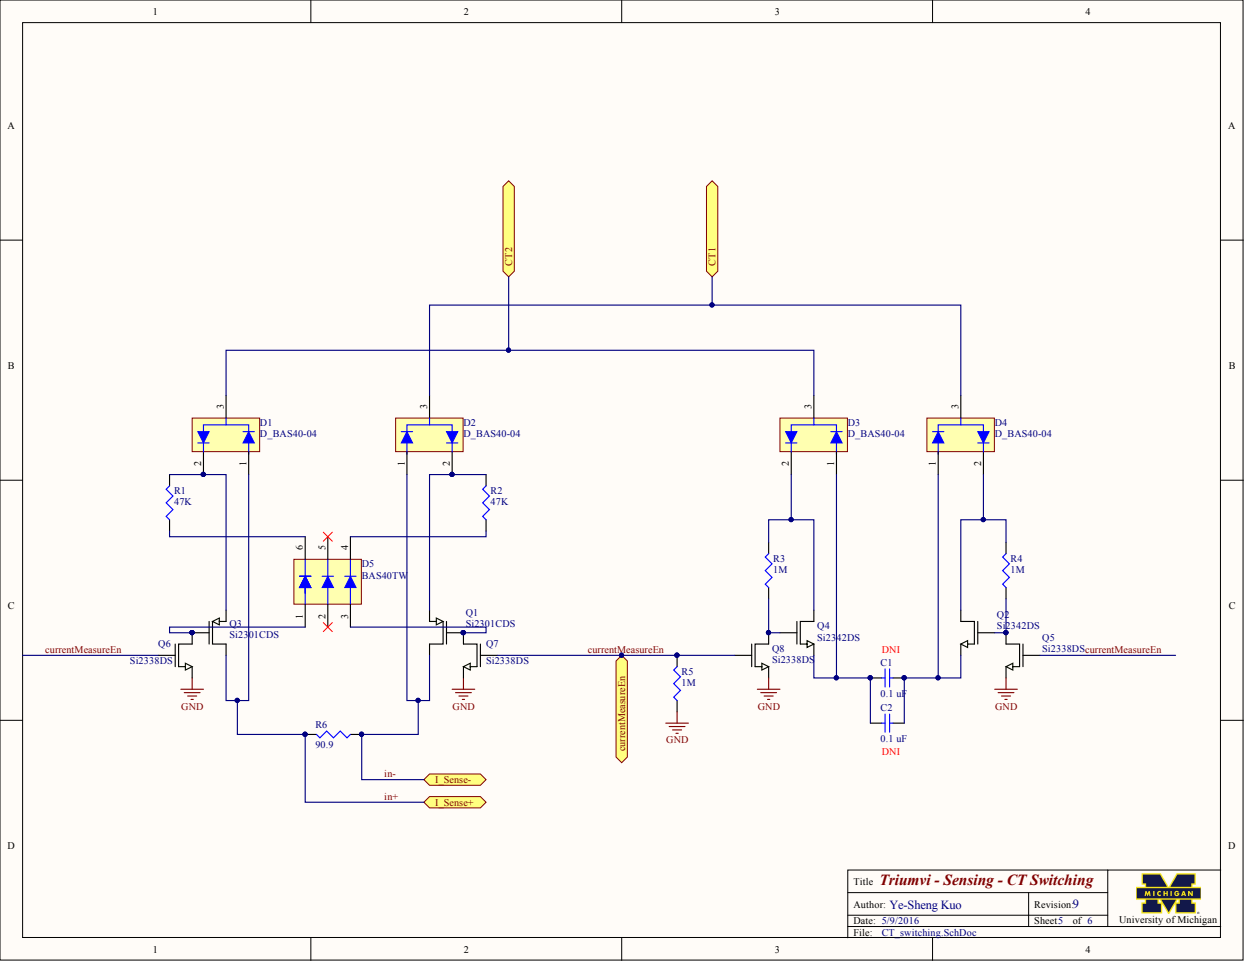
[picture p49: page 5]

Q3
Si2301CDS

Triumvi - Sensing - CT Switching

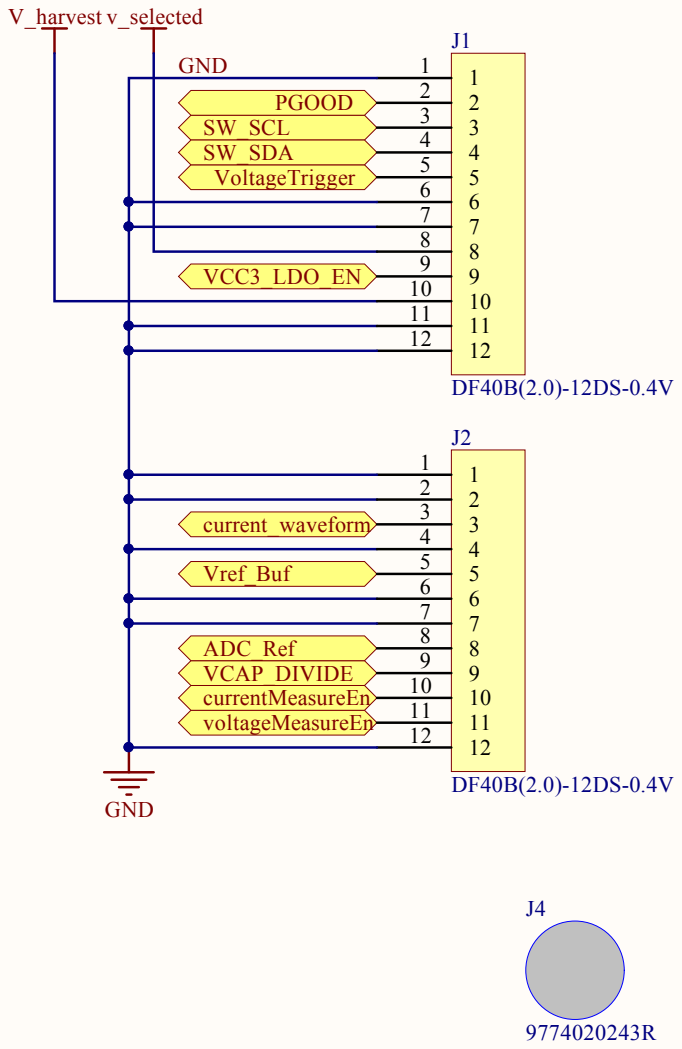
[picture p50: page 6]

7 7
8 8
