lab11/triumvi/hardware/v7/Project Outputs for coilcube_frontend_v2/schematic_v4.PDF

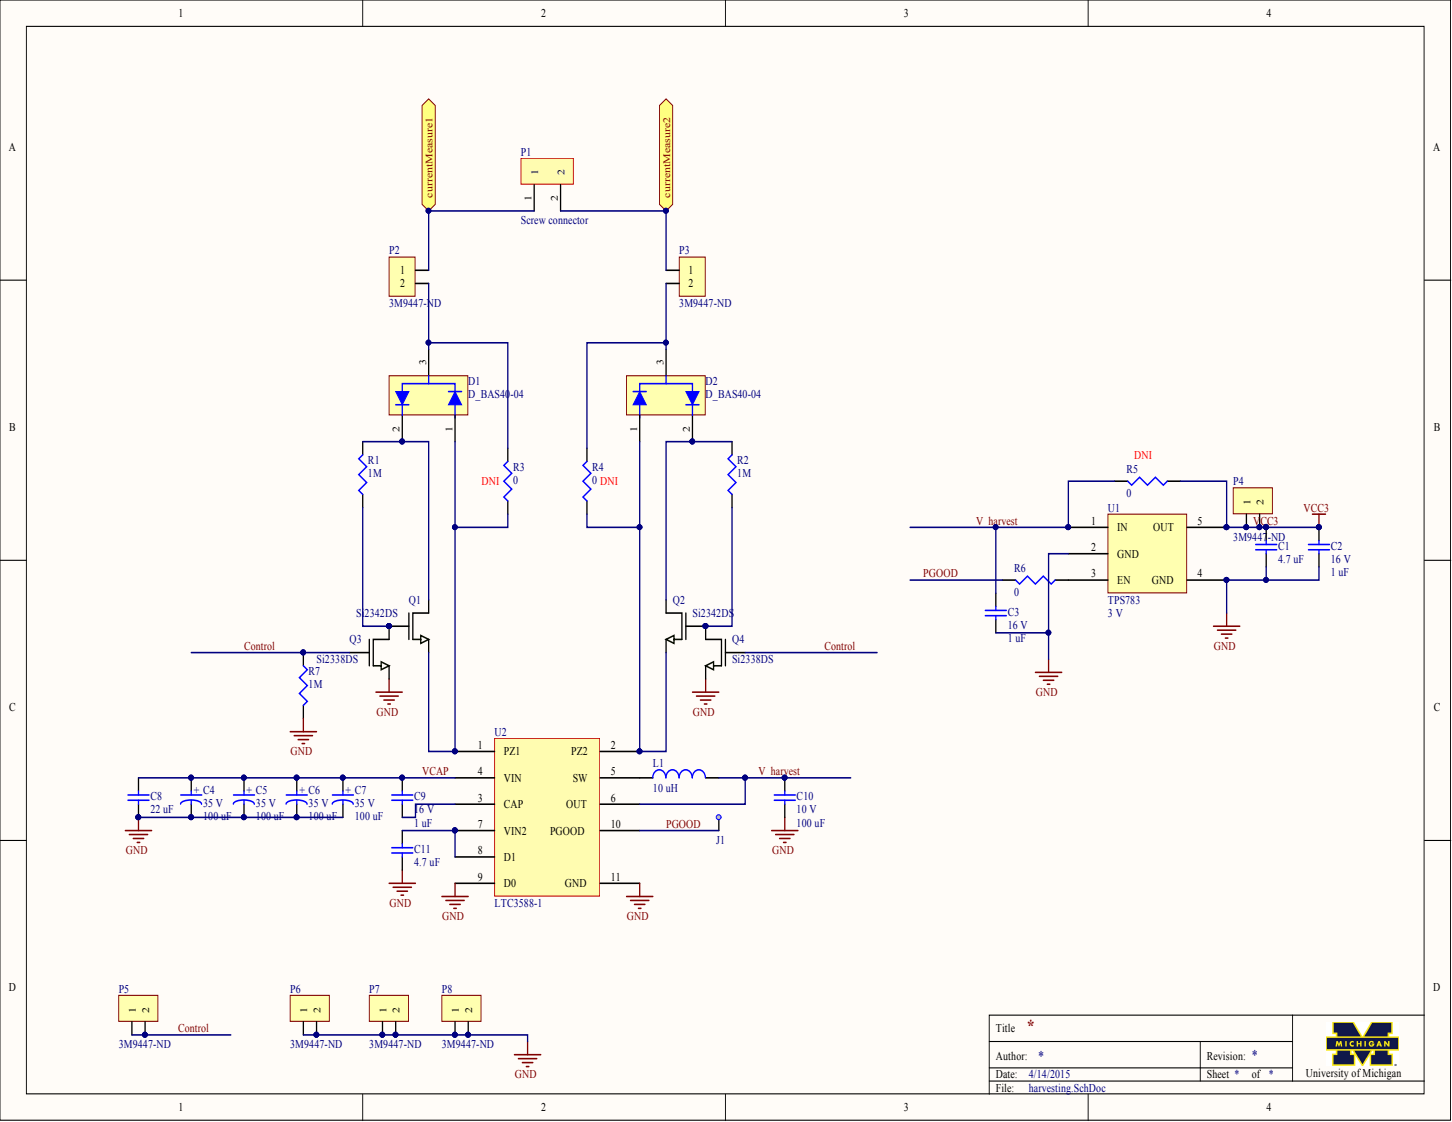
[picture p51: page 1]

* Title | University of Michigan

Author: * | Revision: *
Date: 4/14/2015 | Sheet * of *

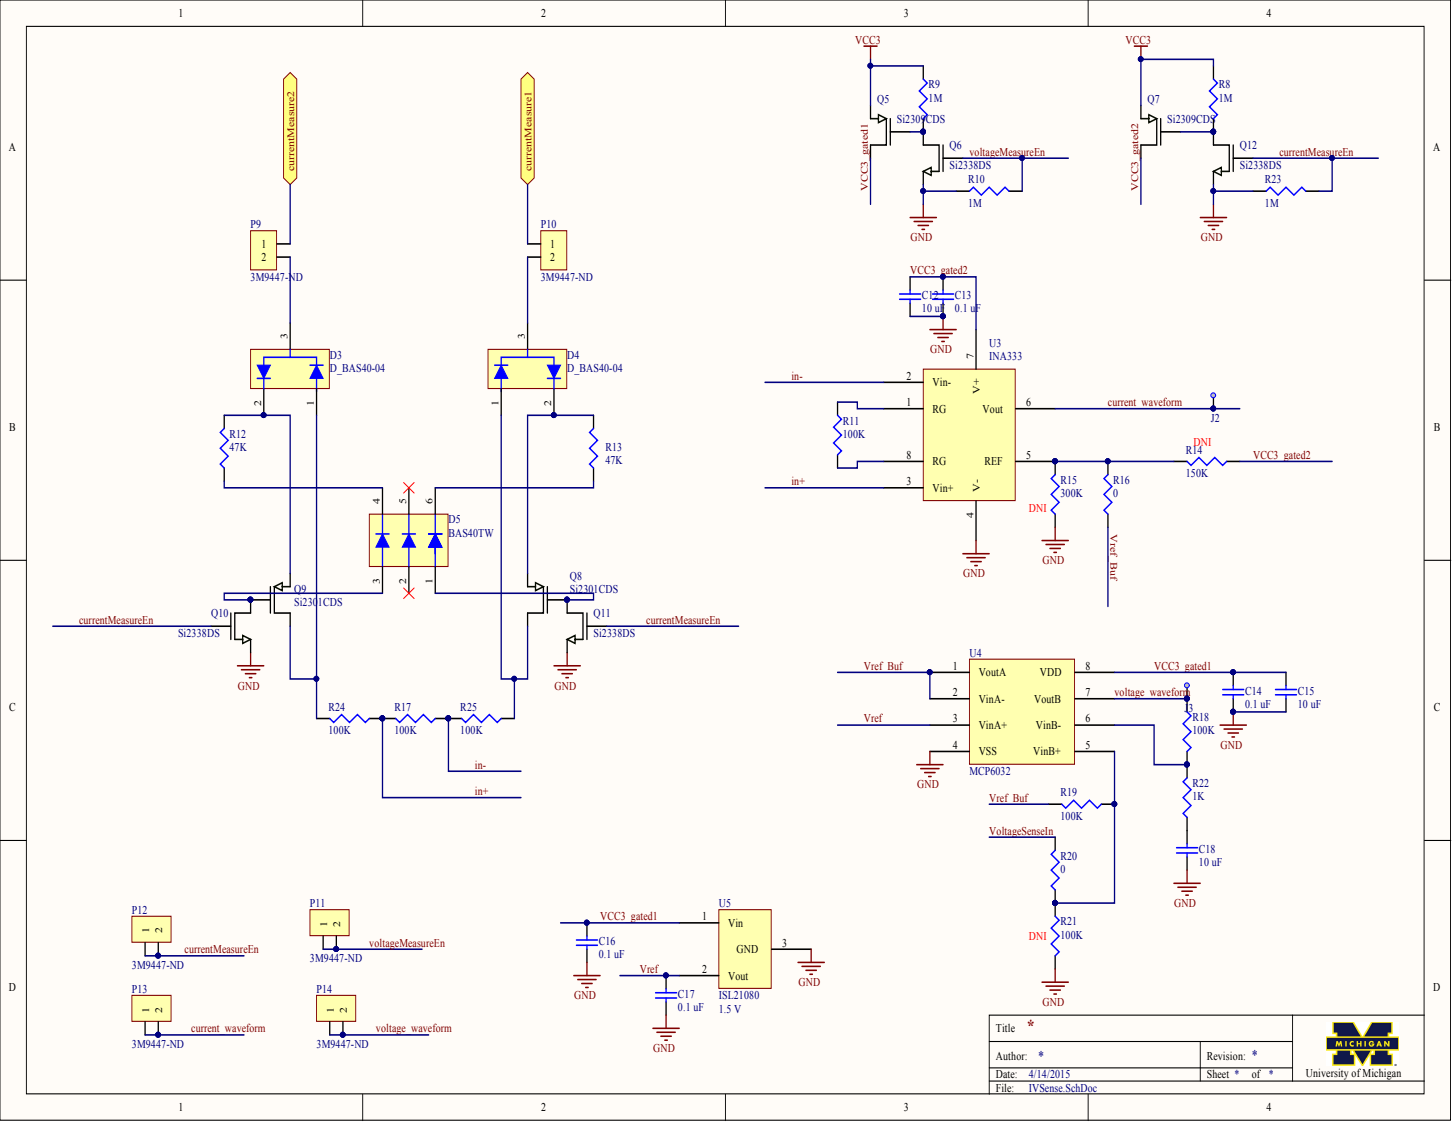
[picture p52: page 2]

Q9
Si2301CDS

* Title | University of Michigan

Author: * | Revision: *
Date: 4/14/2015 | Sheet * of *
