lab11/triumvi/(list of files, drawings)

Other design files:
hardware/altium_libraries/amplifier/amplifier.PcbLib
hardware/altium_libraries/amplifier/amplifier.SchLib
hardware/altium_libraries/battery_charging/battery_charging.PcbLib
hardware/altium_libraries/battery_charging/battery_charging.SchLib
hardware/altium_libraries/comparators/comparators.PcbLib
hardware/altium_libraries/comparators/comparators.SchLib
hardware/altium_libraries/connectos/connectors.PcbLib
hardware/altium_libraries/connectos/connectors.SchLib
hardware/altium_libraries/crystal_oscillator/crystal_oscillators_rtc.PcbLib
hardware/altium_libraries/crystal_oscillator/crystal_oscillators_rtc.SchLib
hardware/altium_libraries/digital_potentiometer/digital_potentiometer.PcbLib
hardware/altium_libraries/digital_potentiometer/digital_potentiometer.SchLib
hardware/altium_libraries/ethernet/ethernet.PcbLib
hardware/altium_libraries/ethernet/ethernet.SchLib
hardware/altium_libraries/ftdi_usbToUart/FTDI_PCB_Public.PcbLib
hardware/altium_libraries/Intel_edison/edison.PcbLib
hardware/altium_libraries/Intel_edison/edison.SchLib
hardware/altium_libraries/io_expansion/io_expansion.PcbLib
hardware/altium_libraries/io_expansion/io_expansion.SchLib
hardware/altium_libraries/level_shifter/level_shifter.PcbLib
hardware/altium_libraries/level_shifter/level_shifter.SchLib
hardware/altium_libraries/logics/logics.PcbLib
hardware/altium_libraries/logics/logics.SchLib
hardware/altium_libraries/mcu/mcu.PcbLib
hardware/altium_libraries/mcu/mcu.SchLib
hardware/altium_libraries/memory/mem.PcbLib
hardware/altium_libraries/memory/mem.SchLib
hardware/altium_libraries/multiplexer/multiplexer.PcbLib
hardware/altium_libraries/multiplexer/multiplexer.SchLib
hardware/altium_libraries/power_switch/power_switch.PcbLib
hardware/altium_libraries/power_switch/power_switch.SchLib
hardware/altium_libraries/powerpath_selector/powerpath_selector.PcbLib
hardware/altium_libraries/powerpath_selector/powerpath_selector.SchLib
hardware/altium_libraries/reference/reference.PcbLib
hardware/altium_libraries/reference/reference.SchLib
hardware/altium_libraries/rf/RF.PcbLib
hardware/altium_libraries/rf/RF.SchLib
hardware/altium_libraries/RLC/rlc.PcbLib
hardware/altium_libraries/RLC/rlc.SchLib
hardware/altium_libraries/switches/switches.PcbLib
hardware/altium_libraries/switches/switches.SchLib
hardware/altium_libraries/transformer/transformer.PcbLib
hardware/altium_libraries/transformer/transformer.SchLib
hardware/altium_libraries/transistors/transistor.PcbLib
hardware/altium_libraries/transistors/transistors.SchLib
hardware/altium_libraries/voltage_regulators/voltage_regulators.PcbLib
hardware/altium_libraries/voltage_regulators/voltage_regulators.SchLib
hardware/charger/design_files/layout/triumvi_v10_phoneJack_charging.PcbDoc
hardware/charger/design_files/layout/triumvi_v10_phoneJack_charging_arr.PcbDoc
hardware/charger/design_files/schematic/bat_charging.SchDoc
hardware/charger/design_files/schematic/power_supply.SchDoc
hardware/charger/design_files/schematic/top.SchDoc
hardware/charger/design_files/triumvi_v10_phoneJeck_charging.PrjPcb
hardware/v7/coilcube_frontend_v2.PrjPcb
hardware/v7/layout/coilcube_frontend_v2.PcbDoc
hardware/v7/layout/coilcube_v3.PcbDoc
hardware/v7/layout/coilcube_v4.PcbDoc
hardware/v7/layout/coilcube_v5.PcbDoc
hardware/v7/layout/coilcube_v6.PcbDoc
hardware/v7/layout/G2_v7_array.PcbDoc
hardware/v7/layout/Genimi_v7.PcbDoc
hardware/v7/schematic/coilcube_frontend_v2.SchDoc
hardware/v7/schematic/current_measurment.SchDoc
hardware/v7/schematic/current_switch.SchDoc
hardware/v7/schematic/harvesting2.SchDoc
hardware/v7/schematic/harvesting.SchDoc
hardware/v7/schematic/IVSense.SchDoc
hardware/v7/schematic/MCU.SchDoc
hardware/v7/schematic/proc.SchDoc
hardware/v7/schematic/voltage_measurment.SchDoc
hardware/v9/configuration/Altium/layout/io_expansion.PcbDoc
hardware/v9/configuration/Altium/layout/io_expansion_v9.PcbDoc
hardware/v9/configuration/Altium/schematic/io_expansion.SchDoc
hardware/v9/configuration/Altium/Triumvi_v9_batteryPack.PrjPcb
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
