lab11/triumvi/contiki/platform/triumvi/dev/board.h

/*
 * Copyright (c) 2012, Texas Instruments Incorporated - http://www.ti.com/
 * All rights reserved.
 *
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
 * 3. Neither the name of the copyright holder nor the names of its
 *    contributors may be used to endorse or promote products derived
 *    from this software without specific prior written permission.
 *
 * THIS SOFTWARE IS PROVIDED BY THE COPYRIGHT HOLDERS AND CONTRIBUTORS
 * ``AS IS'' AND ANY EXPRESS OR IMPLIED WARRANTIES, INCLUDING, BUT NOT
 * LIMITED TO, THE IMPLIED WARRANTIES OF MERCHANTABILITY AND FITNESS
 * FOR A PARTICULAR PURPOSE ARE DISCLAIMED.  IN NO EVENT SHALL THE
 * COPYRIGHT HOLDER OR CONTRIBUTORS BE LIABLE FOR ANY DIRECT, INDIRECT,
 * INCIDENTAL, SPECIAL, EXEMPLARY, OR CONSEQUENTIAL DAMAGES
 * (INCLUDING, BUT NOT LIMITED TO, PROCUREMENT OF SUBSTITUTE GOODS OR
 * SERVICES; LOSS OF USE, DATA, OR PROFITS; OR BUSINESS INTERRUPTION)
 * HOWEVER CAUSED AND ON ANY THEORY OF LIABILITY, WHETHER IN CONTRACT,
 * STRICT LIABILITY, OR TORT (INCLUDING NEGLIGENCE OR OTHERWISE)
 * ARISING IN ANY WAY OUT OF THE USE OF THIS SOFTWARE, EVEN IF ADVISED
 * OF THE POSSIBILITY OF SUCH DAMAGE.
 */
/** \addtogroup cc2538
 * @{
 *
 * \defgroup cc2538-smartrf SmartRF06EB Peripherals
 *
 * Defines related to the SmartRF06EB
 *
 * This file provides connectivity information on LEDs, Buttons, UART and
 * other SmartRF peripherals
 *
 * Notably, PC0 is used to drive LED1 as well as the USB D+ pullup. Therefore
 * when USB is enabled, LED1 can not be driven by firmware.
 *
 * This file can be used as the basis to configure other platforms using the
 * cc2538 SoC.
 * @{
 *
 * \file
 * Header file with definitions related to the I/O connections on the TI
 * SmartRF06EB
 *
 * \note   Do not include this file directly. It gets included by contiki-conf
 *         after all relevant directives have been set.
 */
#ifndef BOARD_H_
#define BOARD_H_

#include "dev/gpio.h"
#include "dev/nvic.h"
/*---------------------------------------------------------------------------*/
/** \name SmartRF LED configuration
 *
 * LEDs on the SmartRF06 (EB and BB) are connected as follows:
 * - LED1 (Red)    -> PC0
 * - LED2 (Yellow) -> PC1
 * - LED3 (Green)  -> PC2
 * - LED4 (Orange) -> PC3
 *
 * LED1 shares the same pin with the USB pullup
 * @{
 */
/*---------------------------------------------------------------------------*/
/* Some files include leds.h before us, so we need to get rid of defaults in
 * leds.h before we provide correct definitions */
#undef LEDS_GREEN
#undef LEDS_BLUE
#undef LEDS_RED
#undef LEDS_CONF_ALL

#define LEDS_BLUE                16 /**< PD4 */
#define LEDS_RED                 8  /**< PD3 */
#define LEDS_GREEN               32 /**< PD5 */
#define LEDS_CONF_ALL            56

/* Notify various examples that we have LEDs */
#define PLATFORM_HAS_LEDS        0

#define LED_BLUE_BASE            GPIO_D_BASE
#define LED_RED_BASE             GPIO_D_BASE
#define LED_GREEN_BASE           GPIO_D_BASE
#define LED_BLUE_MASK            GPIO_PIN_MASK(4)
#define LED_RED_MASK             GPIO_PIN_MASK(3)
#define LED_GREEN_MASK           GPIO_PIN_MASK(5)
/** @} */
/*---------------------------------------------------------------------------*/
/** \name USB configuration
 *
 * The USB pullup is driven by PC0 and is shared with LED1
 */
#define USB_PULLUP_PORT          GPIO_C_NUM
#define USB_PULLUP_PIN           0
/** @} */
/*---------------------------------------------------------------------------*/
/** \name UART configuration
 *
 * On the SmartRF06EB, the UART (XDS back channel) is connected to the
 * following ports/pins
 * - RX:  PA0
 * - TX:  PA1
 * - CTS: PB0 (Can only be used with UART1)
 * - RTS: PD3 (Can only be used with UART1)
 *
 * We configure the port to use UART0. To use UART1, replace UART0_* with
 * UART1_* below.
 * @{
 */
#define UART0_RX_PORT            GPIO_A_NUM
#define UART0_RX_PIN             0

#define UART0_TX_PORT            GPIO_A_NUM
#define UART0_TX_PIN             1
// unused uart1
#define UART1_CTS_PORT           GPIO_C_NUM
#define UART1_CTS_PIN            1

#define UART1_RTS_PORT           GPIO_C_NUM
#define UART1_RTS_PIN            2
/** @} */

/* Triumvi */
/* Port A */
#define I_ADC_GPIO_NUM	GPIO_A_NUM
#define I_ADC_GPIO_PIN	3
#define I_ADC_CHANNEL	SOC_ADC_ADCCON_CH_AIN3

#define V_REF_ADC_GPIO_NUM	GPIO_A_NUM
#define V_REF_ADC_GPIO_PIN	4
#define V_REF_ADC_CHANNEL	SOC_ADC_ADCCON_CH_AIN4

#define EXT_VOLT_IN_GPIO_NUM GPIO_A_NUM
#define EXT_VOLT_IN_GPIO_PIN 5
#define EXT_VOLT_IN_ADC_CHANNEL SOC_ADC_ADCCON_CH_AIN5

#define TRIUMVI_READYn_OUT_GPIO_BASE GPIO_A_BASE
#define TRIUMVI_READYn_OUT_GPIO_PIN 6

/* Port B */
#define CONFIG_PWR_LOOPBAK_GPIO_NUM GPIO_B_NUM
#define CONFIG_PWR_LOOPBAK_GPIO_BASE GPIO_B_BASE
#define CONFIG_PWR_LOOPBAK_GPIO_PIN 3

#define EXT_VOLT_IN_SEL_GPIO_NUM GPIO_B_NUM
#define EXT_VOLT_IN_SEL_GPIO_BASE GPIO_PORT_TO_BASE(EXT_VOLT_IN_SEL_GPIO_NUM)
#define EXT_VOLT_IN_SEL_GPIO_PIN 6

#define TRIUMVI_RDYn_IN_GPIO_NUM GPIO_B_NUM
#define TRIUMVI_RDYn_IN_GPIO_BASE GPIO_PORT_TO_BASE(TRIUMVI_RDYn_IN_GPIO_NUM)
#define TRIUMVI_RDYn_IN_GPIO_PIN 7
#define TRIUMVI_RDYn_IN_INT_NVIC_PORT NVIC_INT_GPIO_PORT_B

/* Port C */
#define V_MEAS_EN_GPIO_BASE GPIO_C_BASE
#define V_MEAS_EN_GPIO_PIN 0

#define I_MEAS_EN_GPIO_BASE GPIO_C_BASE
#define I_MEAS_EN_GPIO_PIN 1

#define V_REF_CROSS_INT_GPIO_NUM GPIO_C_NUM
#define V_REF_CROSS_INT_GPIO_BASE GPIO_PORT_TO_BASE(V_REF_CROSS_INT_GPIO_NUM)
#define V_REF_CROSS_INT_GPIO_PIN 2
#define V_REF_CROSS_INT_NVIC_PORT NVIC_INT_GPIO_PORT_C

#define SENSE_VR_EN_GPIO_BASE GPIO_C_BASE
#define SENSE_VR_EN_GPIO_PIN 3

#define MEM_RST_GPIO_BASE GPIO_C_BASE
#define MEM_RST_GPIO_PIN 4

#define CONFIG_PWR_SW_GPIO_BASE GPIO_C_BASE
#define CONFIG_PWR_SW_GPIO_PIN 7

/* Port D */
#define CONFIG_VCAP_LOOPBACK_GPIO_BASE GPIO_D_BASE
#define CONFIG_VCAP_LOOPBACK_GPIO_PIN 5

/* AD5272/4 */ 
#define AD527X_SDA_GPIO_NUM GPIO_C_NUM
#define AD527X_SDA_GPIO_BASE GPIO_PORT_TO_BASE(AD527X_SDA_GPIO_NUM)
#define AD527X_SDA_GPIO_PIN 5

#define AD527X_SCL_GPIO_NUM GPIO_C_NUM
#define AD527X_SCL_GPIO_BASE GPIO_PORT_TO_BASE(AD527X_SCL_GPIO_NUM)
#define AD527X_SCL_GPIO_PIN 6
#define AD527X_SCL_NVIC_PORT NVIC_INT_GPIO_PORT_C

/* ADG604 Analog Mux*/
#define ADG604_GPIO_NUM GPIO_C_NUM
#define ADG604_GPIO_BASE GPIO_PORT_TO_BASE(ADG604_GPIO_NUM)
#define ADG604_EN_GPIO_NUM GPIO_D_NUM
#define ADG604_EN_GPIO_BASE GPIO_PORT_TO_BASE(ADG604_EN_GPIO_NUM)
#define ADG604_A0_PIN 6
#define ADG604_A1_PIN 5
#define ADG604_EN_PIN 0

/* LTC3200-5 Charge Pump */
#define LTC3200_GPIO_NUM GPIO_D_NUM
#define LTC3200_GPIO_BASE GPIO_PORT_TO_BASE(LTC3200_GPIO_NUM)
#define LTC3200_EN_PIN 2

/* I2C configuration */
#define I2C_SDA_GPIO_NUM GPIO_B_NUM
#define I2C_SDA_GPIO_BASE GPIO_PORT_TO_BASE(I2C_SDA_GPIO_NUM)
#define I2C_SDA_GPIO_PIN 1

#define I2C_SCL_GPIO_NUM GPIO_B_NUM
#define I2C_SCL_GPIO_BASE GPIO_PORT_TO_BASE(I2C_SCL_GPIO_NUM)
#define I2C_SCL_GPIO_PIN 2

/*---------------------------------------------------------------------------*/
/**
 * \name FRAM configuration
 *
 * These values configure which CC2538 pins to use for the FRAM chip.
 * @{
 */
#define FM25CL64B_HOLD_N_PORT_NUM GPIO_D_NUM
#define FM25CL64B_HOLD_N_PIN      0
#define FM25CL64B_WP_N_PORT_NUM   GPIO_D_NUM
#define FM25CL64B_WP_N_PIN        2
#define FM25CL64B_CS_N_PORT_NUM   GPIO_D_NUM
#define FM25CL64B_CS_N_PIN        1

#define FM25V02_HOLD_N_PORT_NUM GPIO_D_NUM
#define FM25V02_HOLD_N_PIN      0
#define FM25V02_WP_N_PORT_NUM   GPIO_D_NUM
#define FM25V02_WP_N_PIN        2
#define FM25V02_CS_N_PORT_NUM   GPIO_D_NUM
#define FM25V02_CS_N_PIN        1
/** @} */
/*---------------------------------------------------------------------------*/
/**
 * \name RV-3049-C3 configuration
 *
 * These values configure which CC2538 pins to use for the RTC chip.
 * @{
 */
//#define RV3049_INT_N_PORT_NUM    GPIO_D_NUM
//#define RV3049_INT_N_PIN         5
#define RV3049_CS_PORT_NUM       GPIO_D_NUM
#define RV3049_CS_PIN            4
/** @} */
/*---------------------------------------------------------------------------*/
/**
 * \name ADC configuration
 *
 * These values configure which CC2538 pins and ADC channels to use for the ADC
 * inputs.
 *
 * ADC inputs can only be on port A.
 * @{
 */
#define ADC_ALS_PWR_PORT         GPIO_A_NUM /**< ALS power GPIO control port */
#define ADC_ALS_PWR_PIN          7 /**< ALS power GPIO control pin */
#define ADC_ALS_OUT_PIN          6 /**< ALS output ADC input pin on port A */
/** @} */
/*---------------------------------------------------------------------------*/
/**
 * \name SPI configuration
 *
 * These values configure which CC2538 pins to use for the SPI lines.
 * @{
 */
#define SPI_CLK_PORT             GPIO_B_NUM
#define SPI_CLK_PIN              4
#define SPI_MOSI_PORT            GPIO_B_NUM
#define SPI_MOSI_PIN             5
#define SPI_MISO_PORT            GPIO_B_NUM
#define SPI_MISO_PIN             0
/** @} */
/*---------------------------------------------------------------------------*/
/**
 * \name Device string used on startup
 * @{
 */
#define BOARD_STRING "Triumvi"
/** @} */

#endif /* BOARD_H_ */

/**
 * @}
 * @}
 */
