lab11/triumvi/contiki/dev/fm25v02/fm25v02.c

/**
* \defgroup fm25v02
* @{
*/

#include "contiki.h"
#include "fm25v02.h"
#include "spi-arch.h"
#include "spi.h"
#include "dev/ssi.h"

/**
* \file   Driver for the FM25V02 series of flash chips
* \author Ye-Sheng Kuo <samkuo@umich.edu>
*/

/**
 * \brief Initialize the FM25V02.
 */
void
fm25v02_init()
{
  #if defined(VERSION9) || defined(VERSION10) || defined(VERSION11)
  /* Set the HOLD_N and WP_N pins to outputs and high */
  GPIO_SET_OUTPUT(GPIO_PORT_TO_BASE(FM25V02_HOLD_N_PORT_NUM),
                  GPIO_PIN_MASK(FM25V02_HOLD_N_PIN));
  GPIO_SET_OUTPUT(GPIO_PORT_TO_BASE(FM25V02_WP_N_PORT_NUM),
                  GPIO_PIN_MASK(FM25V02_WP_N_PIN));
  GPIO_SOFTWARE_CONTROL(GPIO_PORT_TO_BASE(FM25V02_HOLD_N_PORT_NUM),
                        GPIO_PIN_MASK(FM25V02_HOLD_N_PIN));
  GPIO_SOFTWARE_CONTROL(GPIO_PORT_TO_BASE(FM25V02_WP_N_PORT_NUM),
                        GPIO_PIN_MASK(FM25V02_WP_N_PIN));
  GPIO_SET_PIN(GPIO_PORT_TO_BASE(FM25V02_HOLD_N_PORT_NUM),
               GPIO_PIN_MASK(FM25V02_HOLD_N_PIN));
  GPIO_SET_PIN(GPIO_PORT_TO_BASE(FM25V02_WP_N_PORT_NUM),
               GPIO_PIN_MASK(FM25V02_WP_N_PIN));
  #endif

  spi_cs_init(FM25V02_CS_N_PORT_NUM, FM25V02_CS_N_PIN);
  SPI_CS_SET(FM25V02_CS_N_PORT_NUM, FM25V02_CS_N_PIN);
}

/**
 * \brief         Read from the FRAM chip.
 * \param address The index of the byte to start reading from.
 * \param len     The number of bytes to read.
 * \param buf     A buffer to put the return data in.
 * \return        0 on success, -1 on error
 *
 *                Reads len bytes from the FRAM chip starting at address.
 */
int
fm25v02_read(uint16_t address, uint16_t len, uint8_t *buf)
{
  uint16_t i;

  spi_set_mode(SSI_CR0_FRF_MOTOROLA, SSI_CR0_SPO, SSI_CR0_SPH, 8);

  SPI_CS_CLR(FM25V02_CS_N_PORT_NUM, FM25V02_CS_N_PIN);

  /* Send the READ command and the address to the FRAM */
  SPI_WRITE(FM25V02_READ_COMMAND);
  address &= 0x7fff;
  SPI_WRITE((address&0xff00)>>8);
  SPI_WRITE((address&0xff));

  SPI_FLUSH();

  for (i=0; i<len; i++) {
    SPI_READ(buf[i]);
  }

  SPI_CS_SET(FM25V02_CS_N_PORT_NUM, FM25V02_CS_N_PIN);

  return 0;
}

/**
 * \brief         Write to the FRAM chip.
 * \param address The index of the byte to start writing to.
 * \param len     The number of bytes to write.
 * \param buf     A buffer of values to write.
 * \return        0 on success, -1 on error
 *
 *                Writes len bytes to the FRAM chip starting at address.
 */
int
fm25v02_write(uint16_t address, uint16_t len, uint8_t *buf)
{
  uint16_t i;

  spi_set_mode(SSI_CR0_FRF_MOTOROLA, SSI_CR0_SPO, SSI_CR0_SPH, 8);


  SPI_CS_CLR(FM25V02_CS_N_PORT_NUM, FM25V02_CS_N_PIN);

  /* Send the WRITE ENABLE command to allow writing to the FRAM */
  SPI_WRITE(FM25V02_WRITE_ENABLE_COMMAND);

  SPI_CS_SET(FM25V02_CS_N_PORT_NUM, FM25V02_CS_N_PIN);
  SPI_CS_CLR(FM25V02_CS_N_PORT_NUM, FM25V02_CS_N_PIN);

  /* Send the WRITE command and the address to the FRAM */
  SPI_WRITE(FM25V02_WRITE_COMMAND);
  address &= 0x7fff;
  SPI_WRITE((address&0xff00)>>8);
  SPI_WRITE((address&0xff));

  /* Send the data to write */
  for(i=0; i<len; i++) {
    SPI_WRITE(buf[i]);
  }

  SPI_CS_SET(FM25V02_CS_N_PORT_NUM, FM25V02_CS_N_PIN);

  return 0;
}

void fm25v02_sleep(){
	spi_set_mode(SSI_CR0_FRF_MOTOROLA, 0, 0, 8);
	SPI_CS_CLR(FM25V02_CS_N_PORT_NUM, FM25V02_CS_N_PIN);
	SPI_WRITE(FM25V02_SLEEP_COMMAND);
	SPI_CS_SET(FM25V02_CS_N_PORT_NUM, FM25V02_CS_N_PIN);
}

uint8_t fm25v02_readStatus(){
	uint8_t statusReg;
	spi_set_mode(SSI_CR0_FRF_MOTOROLA, 0, 0, 8);
	SPI_CS_CLR(FM25V02_CS_N_PORT_NUM, FM25V02_CS_N_PIN);
	SPI_WRITE(FM25V02_READ_STATUS_COMMAND);
	SPI_FLUSH();
	SPI_READ(statusReg);
	SPI_CS_SET(FM25V02_CS_N_PORT_NUM, FM25V02_CS_N_PIN);
	return statusReg;
}

int fm25v02_writeStatus(uint8_t statusReg){
	// Set WEL bit in status register
	spi_set_mode(SSI_CR0_FRF_MOTOROLA, 0, 0, 8);
	SPI_CS_CLR(FM25V02_CS_N_PORT_NUM, FM25V02_CS_N_PIN);
	SPI_WRITE(FM25V02_WRITE_ENABLE_COMMAND);
	SPI_CS_SET(FM25V02_CS_N_PORT_NUM, FM25V02_CS_N_PIN);

	SPI_CS_CLR(FM25V02_CS_N_PORT_NUM, FM25V02_CS_N_PIN);
	SPI_WRITE(FM25V02_WRITE_STATUS_COMMAND);
    SPI_WRITE(statusReg);
	SPI_CS_SET(FM25V02_CS_N_PORT_NUM, FM25V02_CS_N_PIN);
	return 0;
}

void fm25v02_eraseAll(){
	uint16_t i;
	spi_set_mode(SSI_CR0_FRF_MOTOROLA, 0, 0, 8);
	SPI_CS_CLR(FM25V02_CS_N_PORT_NUM, FM25V02_CS_N_PIN);
	SPI_WRITE(FM25V02_WRITE_ENABLE_COMMAND);
	SPI_CS_SET(FM25V02_CS_N_PORT_NUM, FM25V02_CS_N_PIN);

	SPI_CS_CLR(FM25V02_CS_N_PORT_NUM, FM25V02_CS_N_PIN);
	SPI_WRITE(FM25V02_WRITE_COMMAND);
	// Address
	SPI_WRITE(0x00);
	SPI_WRITE(0x00);

  /* Send the data to write */
	for(i=0; i<0x7fff; i++) {
		SPI_WRITE(0x00);
	}

	SPI_CS_SET(FM25V02_CS_N_PORT_NUM, FM25V02_CS_N_PIN);
}

void fm25v02_dummyWakeup(){
	uint8_t dummyReg;
	//uint16_t dummyCnt;
	spi_set_mode(SSI_CR0_FRF_MOTOROLA, 0, 0, 8);
	SPI_CS_CLR(FM25V02_CS_N_PORT_NUM, FM25V02_CS_N_PIN);
	// Delay for 400-ish us
	clock_delay_usec(400);
	//for (dummyCnt=0; dummyCnt<800; dummyCnt++)
	//	asm("nop");
	SPI_FLUSH();
	SPI_READ(dummyReg);
	SPI_CS_SET(FM25V02_CS_N_PORT_NUM, FM25V02_CS_N_PIN);
}
