lab11/triumvi/contiki/apps/wirelessMeteringV8/project-conf.h

#ifndef PROJECT_CONF_H_
#define PROJECT_CONF_H_

/*
 * @author: Brad Campbell <bradjc@umich.edu>
 */

// No need for UART
#define STARTUP_CONF_VERBOSE 0
#define START_IMMEDIATELY
//#define COMPARATOR_NEGEDGE

//#define CALIBRATE
//#ifdef ERASE_FRAM
//#define RTC_SET
//#define FRAM_WRITE

//#define THREEPHASE_UNIT
//#define THREEPHASE_MASTER

#ifdef CALIBRATE
#define UART_CONF_ENABLE 1
#endif


#define AES_PKT_IDENTIFIER 0xc0
#define TRIUMVI_PKT_IDENTIFIER 0xa0
#define LEN_LEN 2 // LVal
#define MIC_LEN 4 // MVal
#define ADATA_LEN 0x08
#define PDATA_LEN 0x05


#endif /* PROJECT_CONF_H_ */

/** @} */
