lab11/triumvi/contiki/apps/triumviV9AutoCal2/calibration_coef.h

#define IGAIN17_D0 62.6530
#define IGAIN17_D1 0.9703

#define IGAIN9_D0 38.6570
#define IGAIN9_D1 0.9893

#define IGAIN5_D0 34.0731
#define IGAIN5_D1 0.9916

#define IGAIN3_D0 -21.5563
#define IGAIN3_D1 0.9988

// from larger sensing resistor
#define IGAIN2_D0 35.4659
#define IGAIN2_D1 0.9909

#define PGAIN17_D0 10346
#define PGAIN17_D1 0.9517

#define PGAIN9_D0 4038
#define PGAIN9_D1 0.9922

#define PGAIN5_D0 3674
#define PGAIN5_D1 0.9941

#define PGAIN3_D0 2003
#define PGAIN3_D1 0.9950

// from larger sensing resistor
#define PGAIN2_D0 3013
#define PGAIN2_D1 0.9981
