lab11/triumvi/contiki/apps/wirelessMeteringV8/calibrateData.h

#ifndef __CALIBRATEDATA_H__
#define __CALIBRATEDATA_H__
int sineTable[BUF_SIZE] = {
// Node 2
//109, 116, 122, 128, 134, 139, 144, 149, 153, 
//156, 160, 162, 165, 167, 168, 169, 170, 
//170, 169, 168, 167, 165, 163, 160, 157, 
//153, 149, 145, 140, 135, 129, 123, 117, 
//110, 103, 96, 89, 81, 73, 65, 56, 
//48, 39, 31, 22, 13, 4, -5, -14, 
//-23, -32, -40, -49, -57, -66, -74, -82, 
//-90, -97, -104, -111, -118, -124, -130, -135, 
//-141, -145, -150, -154, -157, -160, -163, -165, 
//-167, -168, -169, -170, -170, -169, -168, -166, 
//-165, -162, -159, -156, -152, -148, -143, -139, 
//-133, -127, -121, -115, -108, -101, -94, -86, 
//-79, -71, -62, -54, -45, -37, -28, -19, 
//-10, -1, 8, 16, 25, 34, 43, 51, 
//60, 68, 76, 84, 92, 99, 106};

// Node 3
//104, 111, 118, 124, 130, 136, 141, 146, 150, 
//154, 158, 161, 163, 165, 167, 169, 169, 
//170, 170, 169, 168, 166, 164, 162, 159, 
//156, 152, 148, 143, 138, 133, 127, 121, 
//115, 108, 101, 94, 86, 78, 70, 62, 
//54, 45, 36, 28, 19, 10, 1, -8, 
//-17, -26, -35, -43, -52, -60, -68, -77, 
//-84, -92, -99, -107, -113, -120, -126, -132, 
//-137, -142, -147, -151, -155, -158, -161, -164, 
//-166, -168, -169, -169, -170, -169, -169, -168, 
//-166, -164, -161, -158, -155, -151, -147, -142, 
//-137, -131, -125, -119, -113, -106, -99, -91, 
//-84, -76, -68, -60, -51, -43, -34, -25, 
//-16, -7, 2, 11, 19, 28, 37, 46, 
//54, 63, 71, 79, 87, 94, 101};

// Node 4
//120, 126, 132, 137, 142, 147, 151, 155, 159, 
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
//134, 139, 144, 148, 153, 156, 160, 162, 
//165, 167, 168, 169, 170, 170, 169, 168, 
//167, 165, 163, 160, 157, 153, 149, 145, 
//140, 135, 129, 123, 117, 111, 104, 96, 
//89, 81, 73, 65, 57, 48, 40, 31, 
//22, 13, 4, -5, -14, -22, -31, -40, 
//-49, -57, -65, -74, -82, -89, -97};

157, 160, 163, 165, 167, 168, 169, 170, 170, 
169, 168, 167, 165, 162, 159, 156, 152, 
148, 144, 139, 133, 128, 122, 115, 109, 
102, 94, 87, 79, 71, 63, 55, 46, 
37, 29, 20, 11, 2, -7, -16, -25, 
-33, -42, -51, -59, -67, -75, -83, -91, 
-98, -105, -112, -119, -125, -131, -136, -141, 
-146, -150, -154, -158, -161, -164, -166, -167, 
-169, -169, -170, -170, -169, -168, -166, -164, 
-162, -159, -156, -152, -148, -143, -138, -133, 
-127, -121, -114, -108, -101, -93, -86, -78, 
-70, -62, -53, -45, -36, -27, -19, -10, 
-1, 8, 17, 26, 35, 43, 52, 60, 
69, 77, 84, 92, 99, 106, 113, 120, 
126, 132, 137, 142, 147, 151, 155};

#endif
