lab11/triumvi/(commit log)

2015-05-04 Altium files for energy harvesting true power meter
    [Bill of Materials-coilcube_frontend_v2.xlsx, IVSense.SchDoc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]
2015-05-11 add current waveform and voltage synthesis script
2015-05-12 add ground truth plot
    [T0115CH4.CSV]
2015-05-15 add wireless transmit code
2015-05-16 disable nvic gpio interrupt in measurement
2015-05-20 add power factor measurements
2015-05-24 switch to rtimer
2015-05-29 add backoff timer configuration
2015-06-04 update shunt resistor equation
2015-06-09 fix adg704 leakage current
2015-06-10 add extra state to prevent false trigger of comparator
    [contiki-conf.h, contiki-main.c]
2015-06-15 add additional wait state to reduce power
2015-07-19 updated Gemini+++++++ frontend
    [G2_v7_array.PcbDoc, Genimi_v7.PcbDoc, IVSense.SchDoc, MCU.SchDoc, coilcube_frontend_v2.PrjPcb, coilcube_frontend_v2.~(5).SchDoc, coilcube_v6.PcbDoc, current_switch.SchDoc]
2015-07-20 fix ADC max value
2015-07-21 fix pgood interrupt
2015-07-30 move pin definition to platform file
2015-08-11 update board file for triumvi V8
2015-09-04 copy fm25v02 fram driver from fm25l, remove rv3049 additional byte read
2015-09-04 update fm25v02 driver
2015-09-09 add spi disable and extra state to avoid glitch
    [wirelessMeteringV8.c]
2015-09-14 fix fm25v02 read/write, add read/write status registers
    [fm25v02.c, fm25v02.h]
2015-09-16 bug fix, Set BLDR pins as output
    [project-conf.h, wirelessMeteringV8.c]
2015-09-22 add average for external voltage input
2015-09-23 update Triumvi calibration function
2015-09-23 add tactile button to clear fram pointers
2015-09-23 enable PB6 pull down resistor
2015-09-23 using Macro to enable PD resistor on PB6
2015-09-30 delay voltage by 2 samples
2015-10-01 add sx1509b driver
2015-10-03 add led driver features of sx1509b
2015-10-06 fix batteryPack circuit ID read
    [triumvi.c]
2015-10-06 update battery pack APIs
2015-10-07 add CC2538 Base station to parse the battery pack ID information
2015-10-07 add Triumvi battery pack code
2015-10-16 Synchronize the master/slave start time Fix calibrate functions
    [wirelessMeteringV8.c]
2015-10-19 update voltage scaling constant
2015-10-27 add I2C Slave driver
2015-10-28 add i2cSlave test codes for CC2538
2016-01-28 add spi slave driver for cc2538
2016-02-18 add delay after interrupt to edison
2016-02-19 Add spi RX fifo interrupt to prevent data missing
    [contiki-conf.h, spiSlave.c, spiSlave.h, startup-gcc.c, triumviMain.c]
2016-02-20 fix incorrect circular buffer pointer advances causing repeating packet transfer to intel edison
    [triumviMain.c]
2016-02-24 add busy status check to spi slave API
2016-02-26 restructure receiving code to support edison to start any SPI transmission without Triumvi packet interrupt
2016-02-26 fix the dropping packet when CC2538 circular fifo is full
    [triumviMain.c]
2016-02-29 add fail safe watchdog
    [triumviMain.c]
2016-03-08 add calibration table for each device
2016-03-08 Add check in Makefile that calibration is defined
    Should help point people to the right place instead of the compiler error.
2016-03-08 only flash LED on first measurement
2016-03-08 can not declare inline func prototypes
    in gcc 5
2016-04-20 add AD5274 driver
2016-05-09 add Triumvi version 9 hardware design files
    [Bill of Materials-coilcube_frontend_v2.xlsx, CT_switching.SchDoc, Connectors.SchDoc, Energy_harvesting.SchDoc, G2_v7_array.PcbDoc, Genimi_v7.PcbDoc, IVSense.SchDoc, IV_sensing.SchDoc]
2016-05-16 add altium libraries
    [FTDI_PCB_Public.PcbLib, RF.PcbLib, RF.SchLib, amplifier.PcbLib, amplifier.SchLib, battery_charging.PcbLib, battery_charging.SchLib, comparators.PcbLib]
2016-05-24 update battery pack code for triumvi V9
2016-05-24 add disable I2C function
2016-05-24 Fixing inlining problem with triumvi code
    [triumvi.c, triumvi.h]
2016-05-25 add calibrate / volt synthesis script
2016-05-25 disable AD5272 I2C after sampling current
2016-06-30 use hardcoded reference value from calibration process
2016-07-07 add calibration files
2016-07-08 add audo calibration code doesn't work now
    [project-conf.h, sineTable.h, triumviV9.c]
2016-07-09 update src still not working
    [triumviV9.c]
2016-07-09 update auto calibration code
2016-07-09 update auto calibration code pass compiler
2016-07-10 update triumvi process not working
    [triumviV9.c]
2016-07-10 fix auto calibration, pass compiler
    [project-conf.h, sineTable.h, triumviV9.c]
2016-07-12 fix phase offsets over 360
    [project-conf.h, triumvi.c]
2016-07-17 disable i2c after adjusting gain
2016-07-17 fix i2c disable
2016-07-19 fix external voltage waveform calculation
    [triumviV9.c]
2016-07-20 remove LED debugging
2016-07-20 fix read pin function
    [triumvi.c, triumviV9.c]
2016-07-22 add power factor calculation method
2016-07-24 remove timer value storage enable pull down resistor for external voltage selection
2016-07-24 fix INA333 gain = 1, disable AD5272 remove macro for AD5272, the last two bits of RDAC in AD5274 is don't care can use the same code for both AD5272 and AD5274
    [ad5274.c, project-conf.h, triumvi.c, triumviV9.c]
2016-07-25 tune the sampling interval to 2.99 degree / sample
2016-07-27 add time out to save battery
2016-08-01 clear ready pin once it starts sampling
2016-08-01 add power calibration coefficient
2016-08-01 use polyfit value to compute power factor
2016-08-02 Do not apply polynomial fit at power lower than 50 W
2016-08-02 INA gain 1 is not accurate, skip this setting
    [calibration_coef.h, project-conf.h, triumviV9.c]
2016-08-23 update configuration board detection code
2016-08-23 fix configuration board attach detection
    [triumvi.c]
2016-09-01 add macros for low sensing resistor
2016-09-06 update src to use new external voltage acquisition
2016-09-29 replace with clear ready function
    [triumviV9.c]
2016-09-30 tweak the sample timing, add support for 50 Hz sampling only works w/o external voltage input
2016-09-30 tweak timing for 50 hz ac works for both w/ w/o voltage input
2016-10-01 add voltage generation script
2016-10-09 fix IRMS return 0
    [project-conf.h, triumviV9.c]
2016-10-10 add power value linear fit
2016-10-11 add calibration to v10 code
2016-10-11 add macro to disable amplitude calibration
2016-10-11 restore GPIO Port A if UART is eneabled in calibration mode
2016-10-17 add spi --> rf
2016-10-18 remove redudent macros add auto amplitude calibration to v10
2016-10-30 add driver for fm25cl64b and related fram operation
2016-11-28 deassert analog mux when power is gated. preventing current from internal diodes
    [contiki-main.c, triumvi.c, triumviV10.c]
2016-11-30 add case parts
    [bottom_cap_case.SLDPRT, triumvi_v10_cap.SLDPRT, triumvi_v10_charge_holder.SLDASM, triumvi_v10_charge_holder_pod.SLDPRT, triumvi_v9_cap.SLDPRT, triumvi_white_charge_holder.SLDPRT, triumvi_white_charge_holder_test.SLDPRT]
2016-12-15 set calibration current starts at 1 A to prevent low amplitude jitter
    [triumviV10.c]
2016-12-15 set the starting calibration current to 1000 mA
2017-01-06 fix RTC bug, disable RF for triumvi platform at boot, clear RTC reset flags
    [contiki-main.c, rv3049.c, triumviV10.c]
2017-01-07 fix RTC quiry packet
    [triumviV10.c]
2017-01-10 fix fram read/write for new triumvi format
    [contiki-main.c, triumvi.c, triumvi.h, triumviV10.c]
2017-01-13 store calibration coefficient in FRAM
2017-01-19 Add storing calibration coefficients into FRAM and RTC for V9 (10.0) board
2017-02-04 remove loading pre-calibrated coefficient, using nearby setting instead
2017-02-07 add 1 retry for phase calibration
2017-02-10 add triumvi 3d parts
    [triumvi_v10.1_charge_holder.SLDASM, triumvi_v10_cap.SLDPRT, triumvi_v10_charge_holder_middle.SLDPRT, triumvi_v10_charge_holder_pod.SLDPRT]
2017-03-01 Set ina gain = 1 when disabling current sensing
2017-03-09 add reset rf fifo feature
    [spiDataProc.c, triumviForward.c]
2017-03-16 add dc offset calibration for every gain setting add trickle charging resistor setting
2017-06-05 clean up init and make leds more descriptive
2017-06-23 add v11, v12 hardware files
    [Bill of Materials-Triumvi_v10_config.xlsx, Bill of Materials-Triumvi_v10_mcu.xlsx, Bill of Materials-Triumvi_v11_sensing.xlsx, Bill of Materials-coilcube_frontend_v2.xlsx, Bill of Materials-triumvi_integrated.xlsx, Bill of Materials-triumvi_integrated_v2_base.xlsx, Bill of Materials-triumvi_integrated_v2_config.xlsx, Bill of Materials-triumvi_v10_phoneJeck_charging.xlsx]
